Kaszti49/RezonFallDetector/out/phase2/fix2/element-1990.jpeg

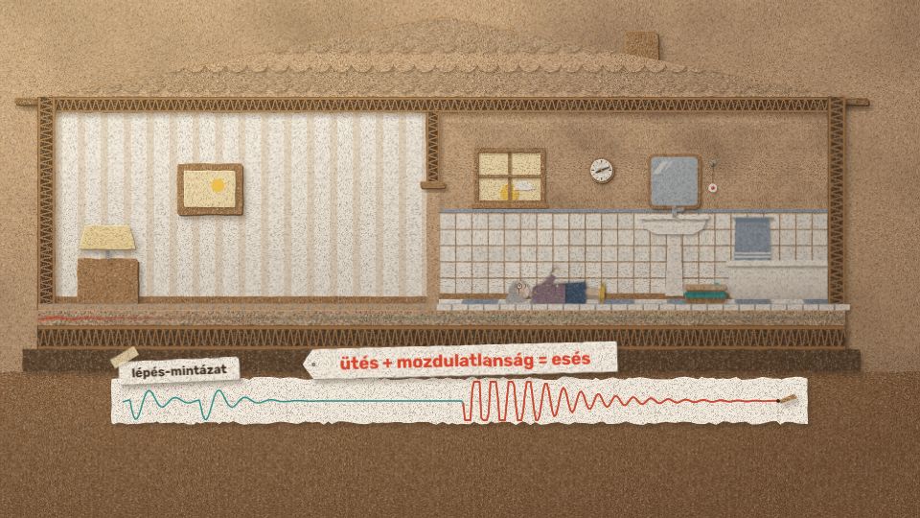
out/phase2/fix2/element-1990.jpeg
