Kaszti49/RezonFallDetector/out/phase2/fix_sheet.jpg

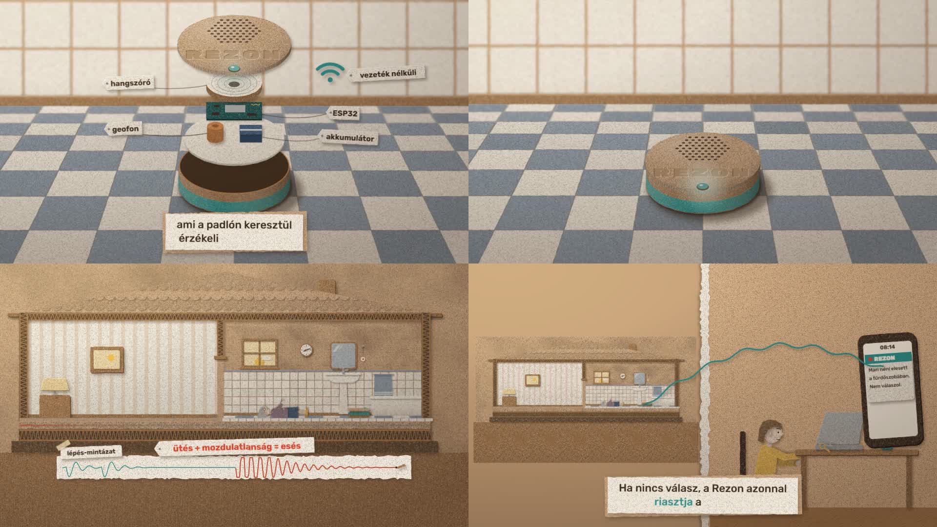
out/phase2/fix_sheet.jpg
