Kaszti49/RezonFallDetector/SCRIPT.md

# REZON – Harman Hackathon 2026 selection video: script

Single source of truth for the story, voiceover, captions and timing.
Language: Hungarian. Target length **1:56** (hard cap 1:58; the rules allow max 2:00).
30 fps. All times are mm:ss.

**Voices**
- **VO** = Kaszti (narrator).
- **DEV** = the Rezon device speaking. Also Kaszti, run through a "small speaker" filter.
- **TEAM** = each member's own line.

**Characters**
- **Mari néni**: 81, lives alone.
- **Anna**: her daughter.

---

## 1. HOOK (0:00 – 0:06)

| ID | Time | Picture | Sound | VO / caption |
|---|---|---|---|---|
| S01 | 0:00–0:06 | Black cardboard surface, barely lit. At 0:00.6 a dull **thud**, and the frame shakes once (3 px, damped). Dust specks settle. At 2.0 the caption appears word by word on a torn white paper strip. | thud (dull, cardboard-like), then 1 s of silence | **VO-01:** „Mi történik, ha senki sem hallja?" |

## 2. PROBLEM (0:06 – 0:29)

| ID | Time | Picture | Sound | VO / caption |
|---|---|---|---|---|
| S02 | 0:06–0:11 | Cardboard bathroom, morning light through a cut-out window. Mari néni shuffles in. In the background a **panic-button pendant hangs on a hook** by the mirror, out of reach. | dripping tap, slippers on tile | **VO-02:** „Ő Mari néni. Nyolcvanegy éves, és egyedül él." |
| S03 | 0:11–0:18 | Push in on a small camera in the top corner with a blinking red LED. Mari stares at it, hesitates, then throws a towel over it. The LED glows faintly through the towel. | paper rustle, towel flop | **VO-03:** „A lánya kamerát szereltetett a fürdőszobába. De ki akarna kamera előtt fürdeni?" |
| S04 | 0:18–0:21 | Wet tile, Mari slips, the cut-out falls flat. **Same thud as the hook** (callback). Small inset: the camera's feed shows only towel texture and the label **„NINCS KÉP"**. | thud, then silence | — |
| S05 | 0:21–0:29 | Time passes: the paper sun/moon disc rotates past the window, the clock hands spin, the light goes from warm to blue. Mari lies still. | ticking clock (sped up), silence | **VO-04:** „A kamera ott volt. Csak éppen semmit sem látott. Mari néni órákig feküdt a hideg csempén." |

## 3. PRODUCT (0:29 – 1:32), the longest section

| ID | Time | Picture | Sound | VO / caption |
|---|---|---|---|---|
| S06 | 0:29–0:33 | **Rewind:** a cardboard cassette-reel icon spins in the corner, and S05→S02 plays backwards fast, stepped and jerky. It stops on the empty morning bathroom. | tape rewind, then a click | **VO-05:** „Tekerjük vissza!" |
| S07 | 0:33–0:40 | The camera peels off the wall like a sticker and falls out of frame. The view pulls back and the bathroom becomes a **cross-section of the whole house** with the floor layers visible. A big cardboard caption stamps in: **2028**. | peel, stamp | **VO-06:** „Kétezer-huszonnyolc. Mi lenne, ha nem egy kamera figyelne, hanem maga a ház?" |
| S08 | 0:40–0:52 | **The Rezon device slides in** and lands on the floor by the bathroom wall. Push in, then an **exploded view**: the layers lift apart, with Hungarian labels on paper tags: **geofon · ESP32 · akkumulátor · hangszóró**, plus a small Wi-Fi icon for **„vezeték nélküli"**. Then it reassembles with a snap. | cardboard slide, snap | **VO-07:** „Ez a Rezon. Egy vezeték nélküli kis doboz, ami a padlón keresztül érzékeli a rezgéseket." |
| S09 | 0:52–1:03 | Mari walks across the cross-section. **Each step sends teal ripples** through the floor to the Rezon, and its LED pulses green. A **seismograph paper tape** at the bottom draws the same rhythm, labelled **„lépés-mintázat"**. | footsteps, paper tape scratch | **VO-08:** „Nem lát, nem vesz fel hangot, és nem kell hordani. Minden lépésnek saját rezgése van – a Rezon megtanulja, hogyan jár Mari néni." |
| S10 | 1:03–1:07 | Same slip as S04. **One big red ripple**, the tape spikes, then a **flat line**. A caption tag appears: **„ütés + mozdulatlanság = esés"**. | thud, then silence | — |
| S11 | 1:07–1:14 | The Rezon LED turns amber, and sound-wave rings come from its speaker. The speech bubble is shaped like sound waves. Mari's hand moves weakly; she cannot get up. A **10-second ring countdown** runs around the device. | two-tone chime | **DEV-01:** „Mari néni, jól van?" · (pause) · **DEV-02:** „Nyugalom, segítséget hívok." |
| S12 | 1:14–1:22 | Split screen. Right: Anna at her desk, and a cardboard phone lights up with **„REZON • Mari néni elesett a fürdőszobában. Nem válaszol. 08:14"**. Anna grabs her keys. Left: a ripple line travels from the house to the phone. | phone buzz, keys | **VO-10:** „Ha nincs válasz, a Rezon azonnal riasztja a családot. Nem órák múlva – másodpercek alatt." |
| S13 | 1:22–1:32 | Anna kneels by Mari and helps her sit up; Mari smiles. Pull back to the house: the Rezon LED back to green, calm ripples. **Tagline** in cardboard letters. | door, soft relief beat (no music) | **VO-11:** „Rezon. A ház, ami meghallja, ha baj van." |

## 4. TEAM (1:32 – 1:56)

Format: a pop-up book.
- Each member **pops up** from the center fold with a paper "flap" sound.
- Their **photo head sits on a cardboard suit body**, and the mouth flaps on their line.
- A name/role tag sits below them.
- After the line they **slide right** and stay there, so the members stack left to right.

| ID | Time | Picture | VO / caption |
|---|---|---|---|
| S14 | 1:32–1:36 | The book opens; the background is a warm kraft wall. | **VO-12:** „Mi vagyunk a Rezon csapata." |
| S15 | 1:36–1:40 | Member 1 pops up. Tag: **Kaszti Benedek – design és projektvezetés** | **TEAM-1:** „Mert mindenkinek van egy Mari nénije." |
| S16 | 1:40–1:44 | Member 2. Tag: **Szabó Viktor – jelfeldolgozás és MI** | **TEAM-2:** „Nem akarjuk kamerával figyelni." |
| S17 | 1:44–1:48 | Member 3. Tag: **Veress Bence – beágyazott szoftver** | **TEAM-3:** „De tudni akarjuk, hogy jól van." |
| S18 | 1:48–1:52 | Member 4. Tag: **Bors Máté – elektronika és prototípus** | **TEAM-4:** „Ezért építettük meg a Rezont." |
| S19 | 1:52–1:56 | **REZON** in cardboard letters pops up behind them, with the device on a small pedestal. Everyone in frame. Hold. | — |

**Team line limit:** max **7 words / 3 seconds** each, or the cap breaks.

---

## Recording list (Kaszti)

Record WAV, 48 kHz, 24-bit. Do 3 takes per line, with 1 s of silence before and after.

| File | Text |
|---|---|
| vo_01.wav | Mi történik, ha senki sem hallja? |
| vo_02.wav | Ő Mari néni. Nyolcvanegy éves, és egyedül él. |
| vo_03.wav | A lánya kamerát szereltetett a fürdőszobába. De ki akarna kamera előtt fürdeni? |
| vo_04.wav | A kamera ott volt. Csak éppen semmit sem látott. Mari néni órákig feküdt a hideg csempén. |
| vo_05.wav | Tekerjük vissza! |
| vo_06.wav | Kétezer-huszonnyolc. Mi lenne, ha nem egy kamera figyelne, hanem maga a ház? |
| vo_07.wav | Ez a Rezon. Egy vezeték nélküli kis doboz, ami a padlón keresztül érzékeli a rezgéseket. |
| vo_08.wav | Nem lát, nem vesz fel hangot, és nem kell hordani. Minden lépésnek saját rezgése van – a Rezon megtanulja, hogyan jár Mari néni. |
| dev_01.wav | Mari néni, jól van? *(calm, clear, a little slower)* |
| dev_02.wav | Nyugalom, segítséget hívok. |
| vo_10.wav | Ha nincs válasz, a Rezon azonnal riasztja a családot. Nem órák múlva – másodpercek alatt. |
| vo_11.wav | Rezon. A ház, ami meghallja, ha baj van. |
| vo_12.wav | Mi vagyunk a Rezon csapata. |
| team_1.wav | Mert mindenkinek van egy Mari nénije. *(Kaszti)* |
| team_2.wav | Nem akarjuk kamerával figyelni. *(Viktor)* |
| team_3.wav | De tudni akarjuk, hogy jól van. *(Bence)* |
| team_4.wav | Ezért építettük meg a Rezont. *(Máté)* |

## How the video answers the jury's questions

| Their question | Where |
|---|---|
| Problem / opportunity | S02–S05 |
| Human–machine relationship in 5 years | S07, S11 (the house speaks and asks) |
| Role of sound | S11 device voice, S09 the floor "hears", tagline |
| What's new vs today | S03 camera fails, S02 pendant out of reach, S08–S09 no camera, no wearable |
| Team introduced | S14–S19 |
| Technical depth (selection criterion) | S08 exploded view, S09 tape, S10 detection rule |

**Technical claims (approved by Kaszti, 2026-10-21):** wireless, battery-powered, speaker in the unit, "nem vesz fel hangot" (doesn't record audio), "impact + stillness = fall".

---

## Alternative team lines (decided 2026-10-22: **set D**)

Kaszti chose **set D** on 2026-10-22; it is now in S15–S18 and the recording list. The other sets are kept for reference only. Pick one set; then S15–S18, the recording list and the captions are updated together. Every line is ≤ 7 words and ≈ 2–3 seconds. Order is always Kaszti → Viktor → Bence → Máté.

**A – current: "What I give it"**
- Kaszti: „Én adok neki formát és hangot."
- Viktor: „Én tanítom meg érezni a lépéseket."
- Bence: „Én kötöm össze a családdal."
- Máté: „Én pedig összerakom, hogy működjön is."

**B – "What I do"** (plain and clear: each role in one sentence)
- Kaszti: „Én tervezem, hogyan néz ki és szól."
- Viktor: „Én tanítom meg felismerni az esést."
- Bence: „Én írom a dobozban futó kódot."
- Máté: „Én forrasztom össze az egészet."

**C – "Mine is…"** (short, rhythmic, a little funny – the easiest to say)
- Kaszti: „Enyém a dizájn."
- Viktor: „Enyém az okos rész."
- Bence: „Enyém a kód."
- Máté: „Enyém minden, amit megfoghatsz."

**D – "One thought, four voices"** (together they finish one sentence and restate why Rezon exists; follows VO-12 „Mi vagyunk a Rezon csapata.")
- Kaszti: „Mert mindenkinek van egy Mari nénije."
- Viktor: „Nem akarjuk kamerával figyelni."
- Bence: „De tudni akarjuk, hogy jól van."
- Máté: „Ezért építettük meg a Rezont."
