Kaszti49/RezonFallDetector/out/Font example.png

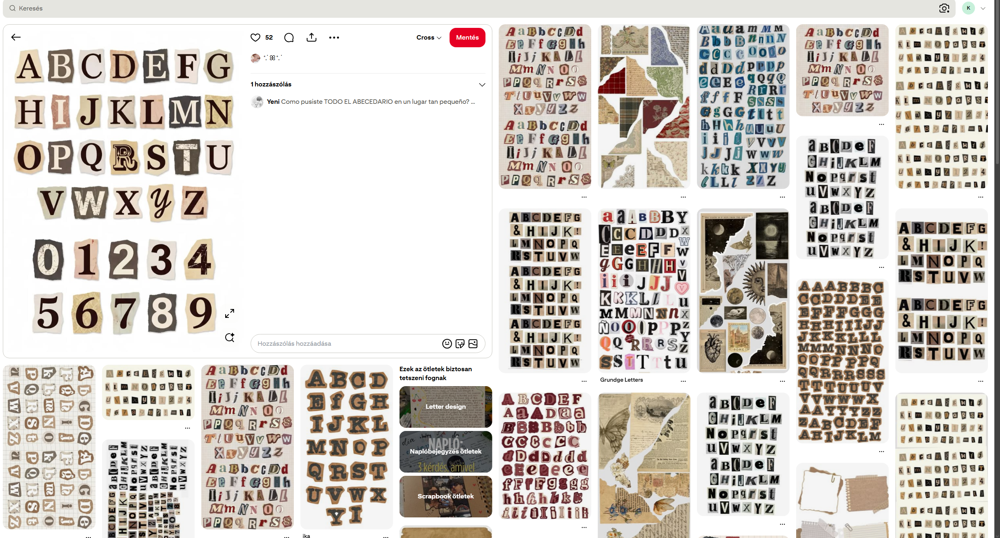
out/Font example.png
