Kaszti49/RezonFallDetector/out/phase0/title_crop_2x.png

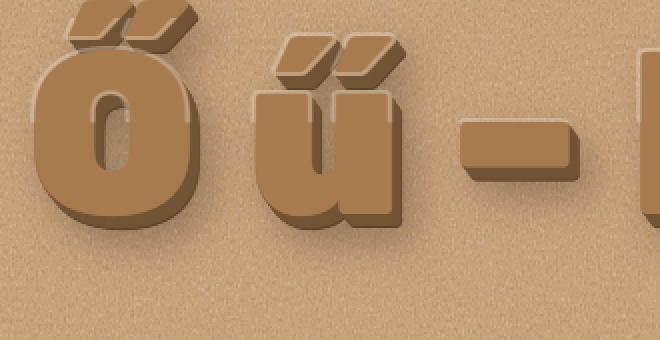
out/phase0/title_crop_2x.png
