Kaszti49/RezonFallDetector/out/phase1/PHASE1_contact_sheet.png

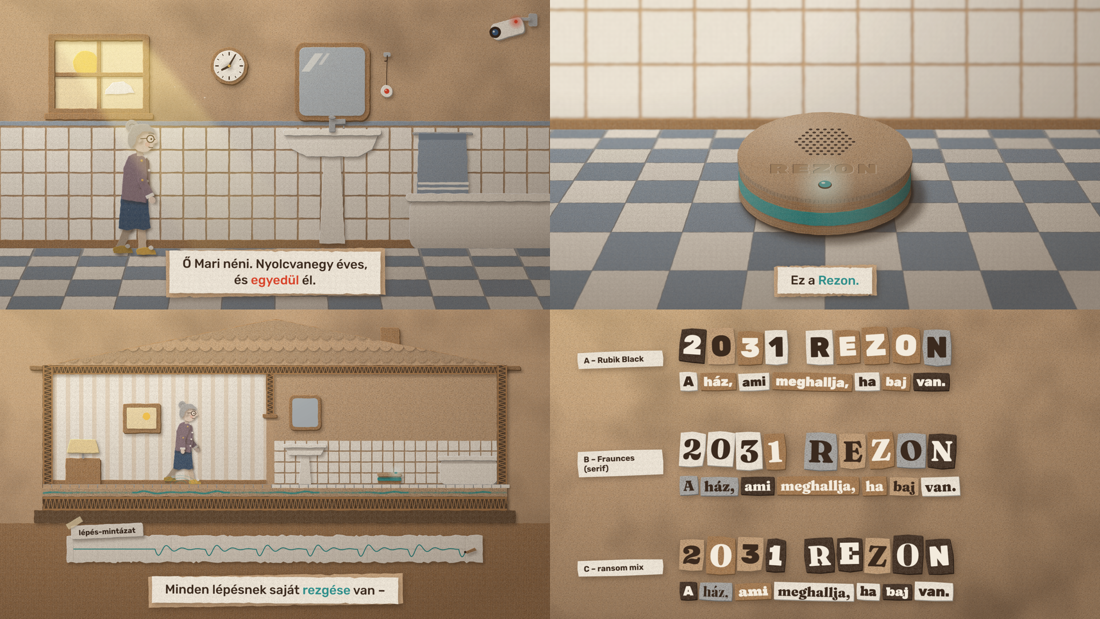
out/phase1/PHASE1_contact_sheet.png
