Kaszti49/RezonFallDetector/out/phase1/section_ripple_crop.png

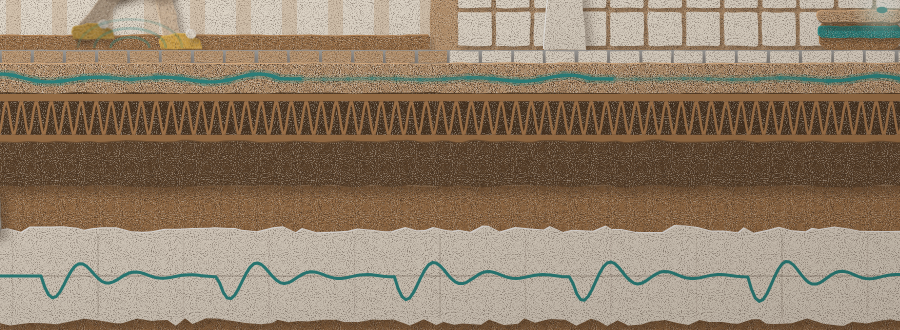
out/phase1/section_ripple_crop.png
