Kaszti49/RezonFallDetector/out/phase1/StyleBathroom.png

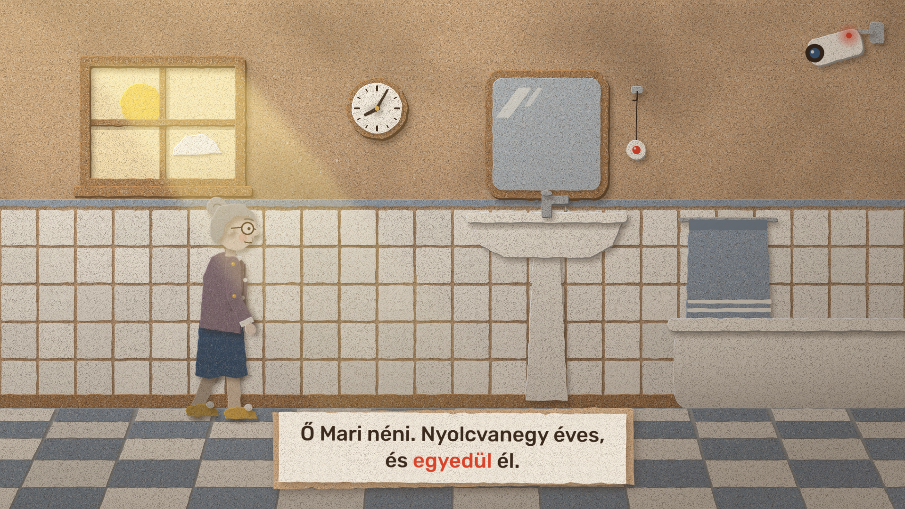
out/phase1/StyleBathroom.png
