Kaszti49/RezonFallDetector/out/phase1/StyleDevice.png

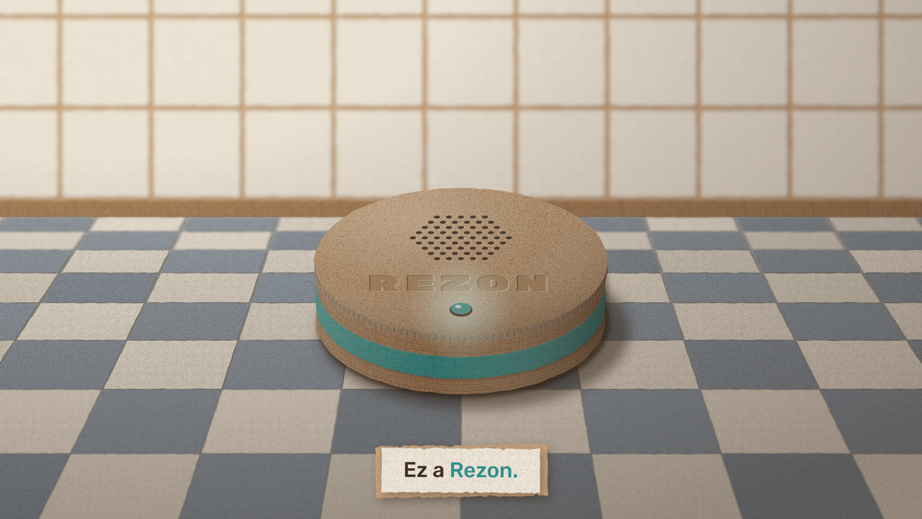
out/phase1/StyleDevice.png
