Kaszti49/RezonFallDetector/out/phase1/StyleSection.png

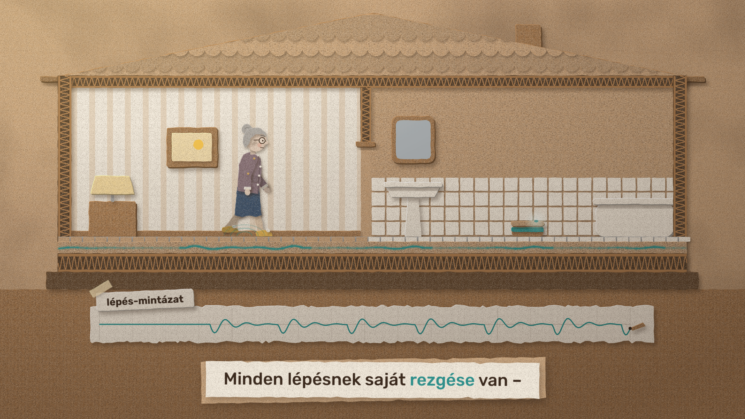
out/phase1/StyleSection.png
