Kaszti49/RezonFallDetector/out/phase1/StyleTitles.png

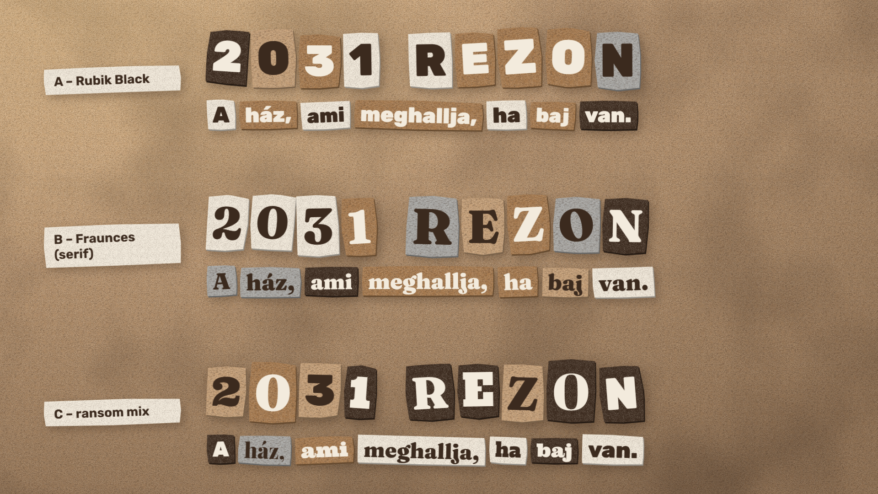
out/phase1/StyleTitles.png
