Kaszti49/RezonFallDetector/out/phase1/v1_bathroom.png

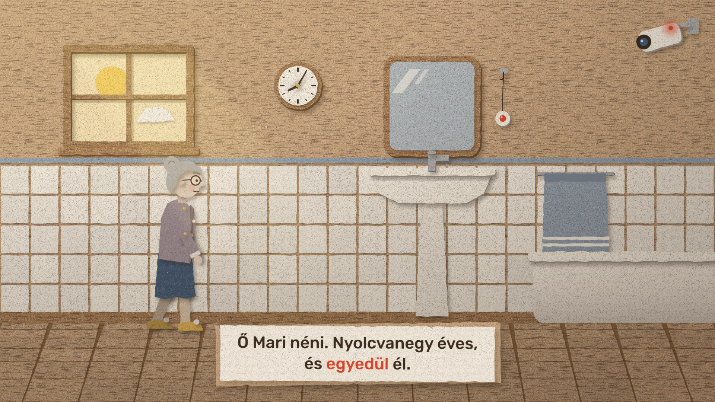
out/phase1/v1_bathroom.png
