Kaszti49/RezonFallDetector/out/phase1/v2_mari_2x.png

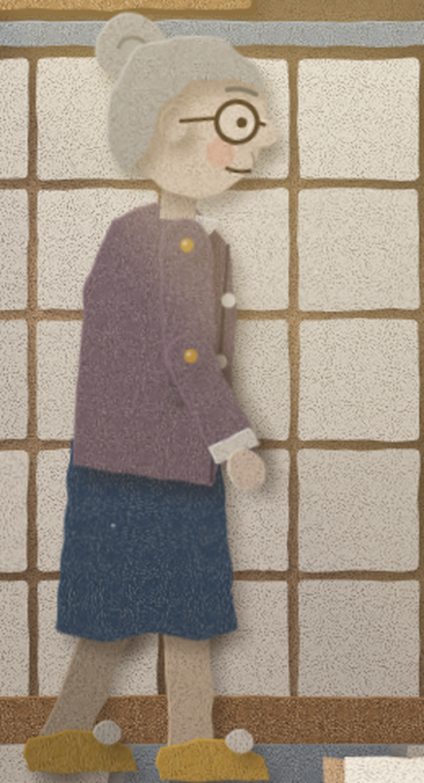
out/phase1/v2_mari_2x.png
