Kaszti49/RezonFallDetector/out/phase1/v3_StyleTitles.png

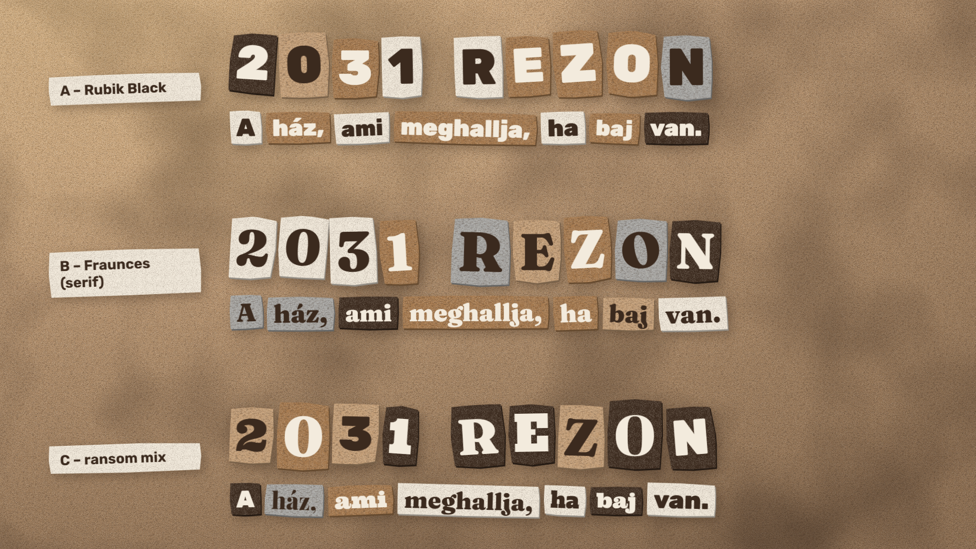
out/phase1/v3_StyleTitles.png
