Kaszti49/RezonFallDetector/out/phase2/cut_check.jpg

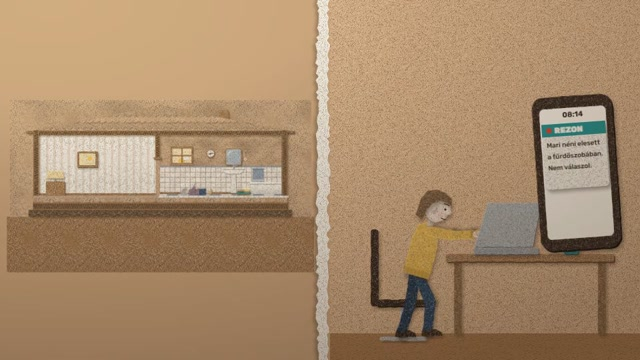
out/phase2/cut_check.jpg
