Kaszti49/RezonFallDetector/out/phase2/flap_check.jpg

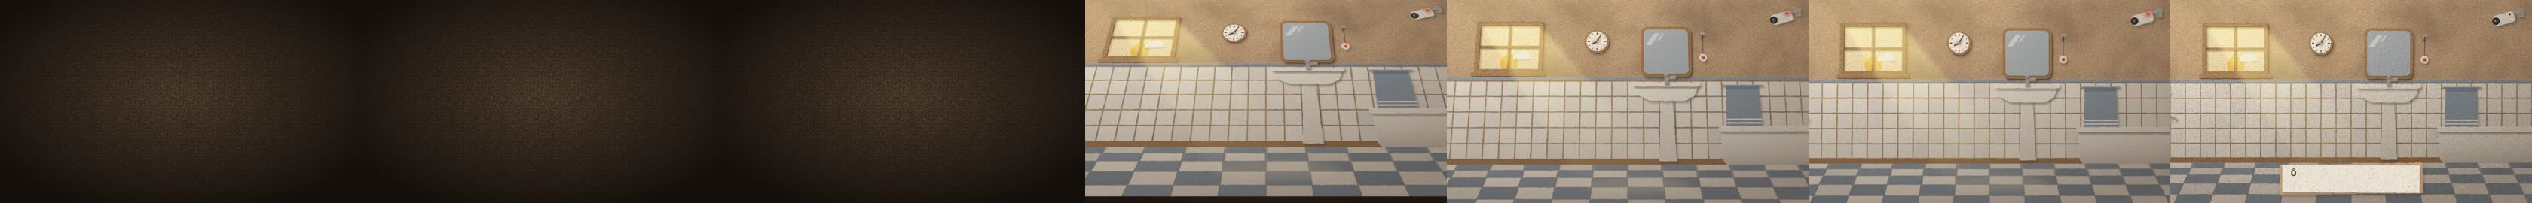
out/phase2/flap_check.jpg
