Kaszti49/RezonFallDetector/out/phase2/flip_check.jpg

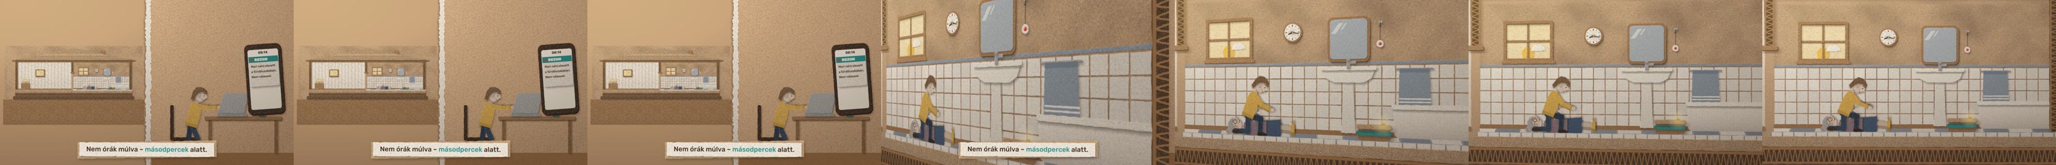
out/phase2/flip_check.jpg
