Kaszti49/RezonFallDetector/out/phase2/handoff.jpg

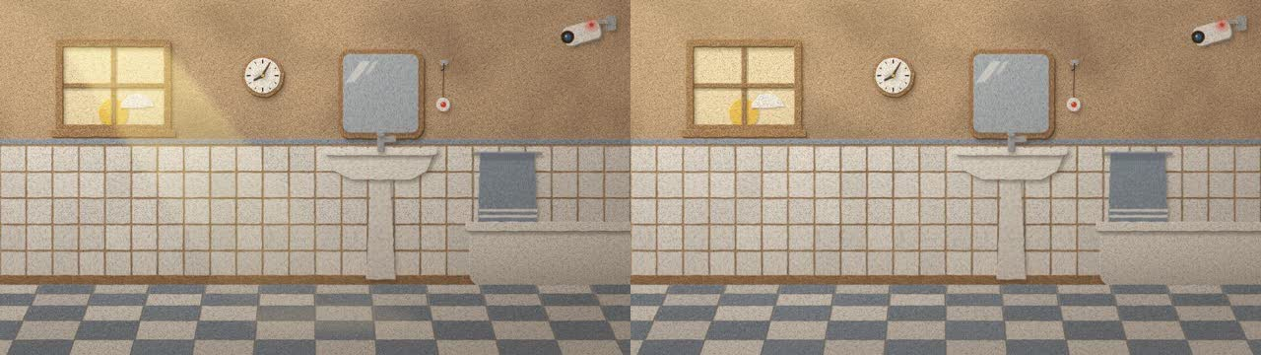
out/phase2/handoff.jpg
