Kaszti49/RezonFallDetector/out/phase2/keys/element-0021.jpeg

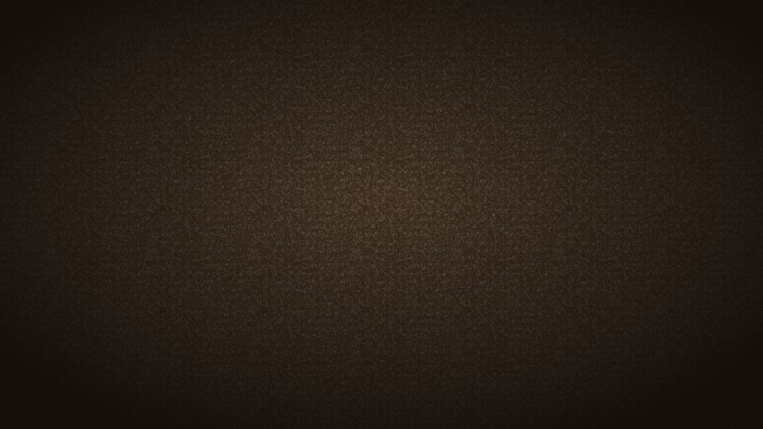
out/phase2/keys/element-0021.jpeg
