Kaszti49/RezonFallDetector/out/phase2/keys/element-0255.jpeg

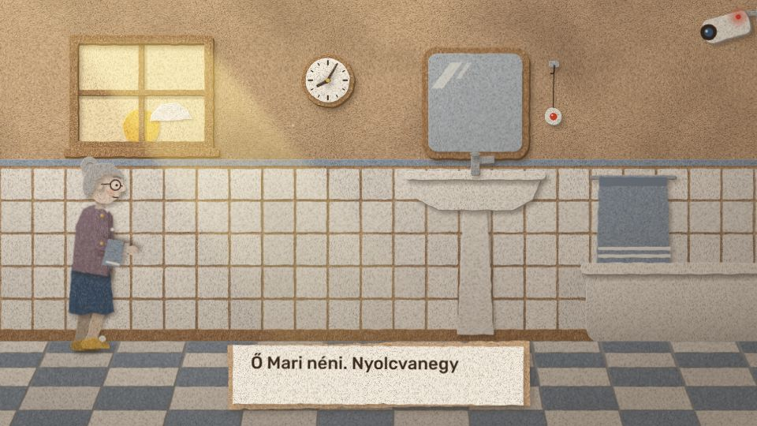
out/phase2/keys/element-0255.jpeg
