Kaszti49/RezonFallDetector/out/phase2/keys/element-0384.jpeg

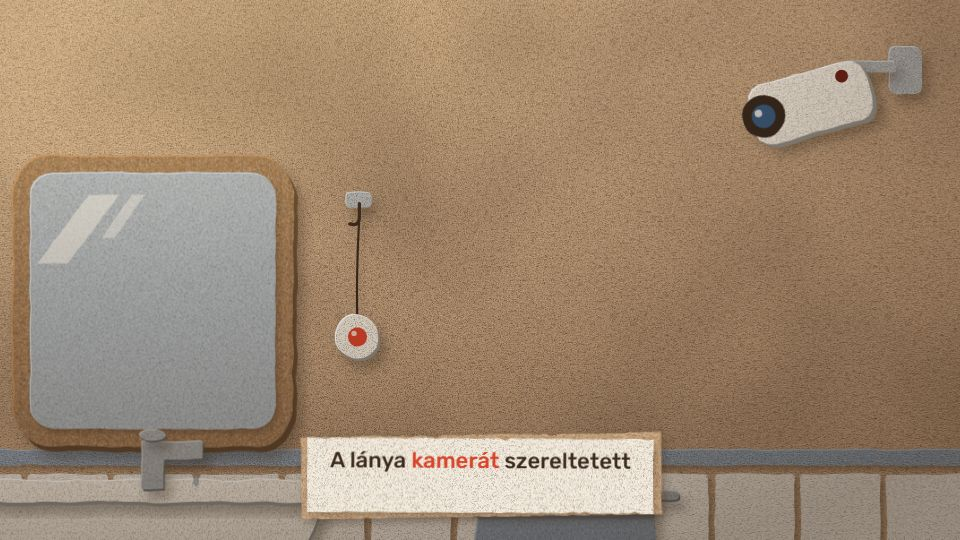
out/phase2/keys/element-0384.jpeg
