Kaszti49/RezonFallDetector/out/phase2/keys/element-0522.jpeg

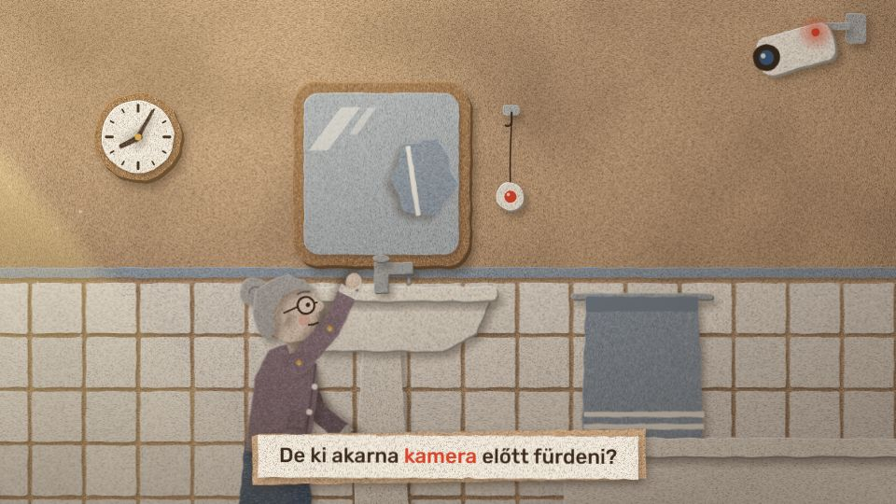
out/phase2/keys/element-0522.jpeg
