Kaszti49/RezonFallDetector/out/phase2/keys/element-0570.jpeg

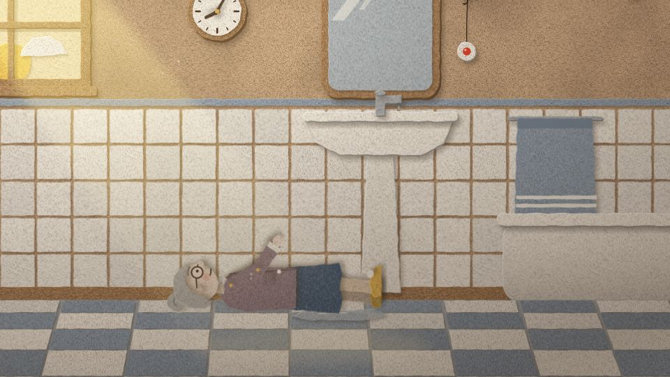
out/phase2/keys/element-0570.jpeg
