Kaszti49/RezonFallDetector/out/phase2/keys/element-0600.jpeg

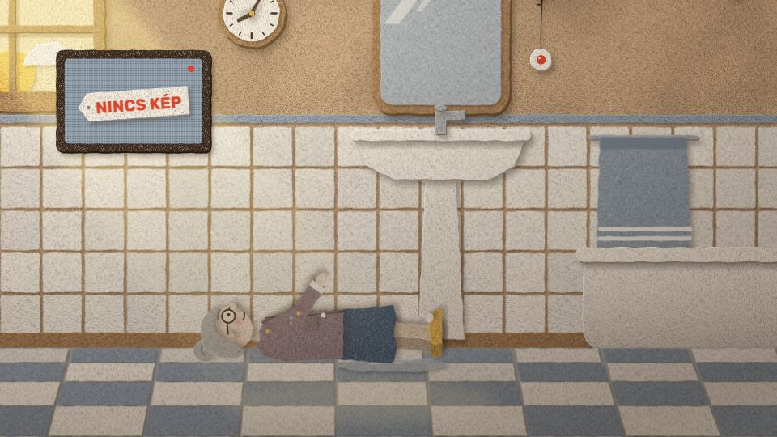
out/phase2/keys/element-0600.jpeg
