Kaszti49/RezonFallDetector/out/phase2/keys/element-0810.jpeg

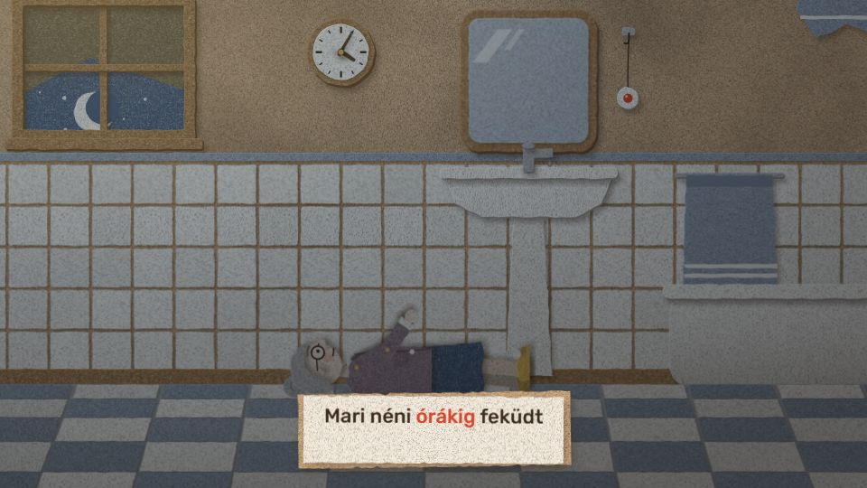
out/phase2/keys/element-0810.jpeg
