Kaszti49/RezonFallDetector/out/phase2/keys/element-0915.jpeg

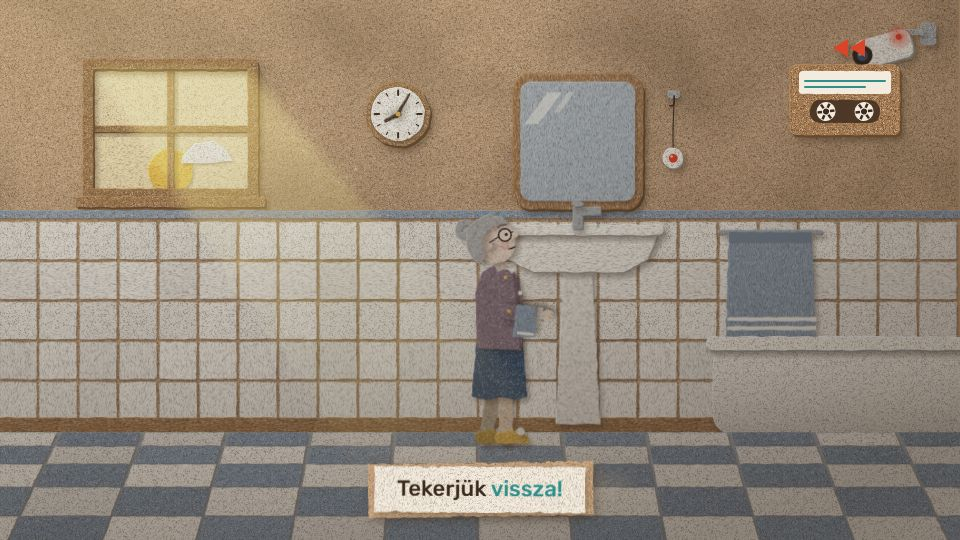
out/phase2/keys/element-0915.jpeg
