Kaszti49/RezonFallDetector/out/phase2/keys/element-0975.jpeg

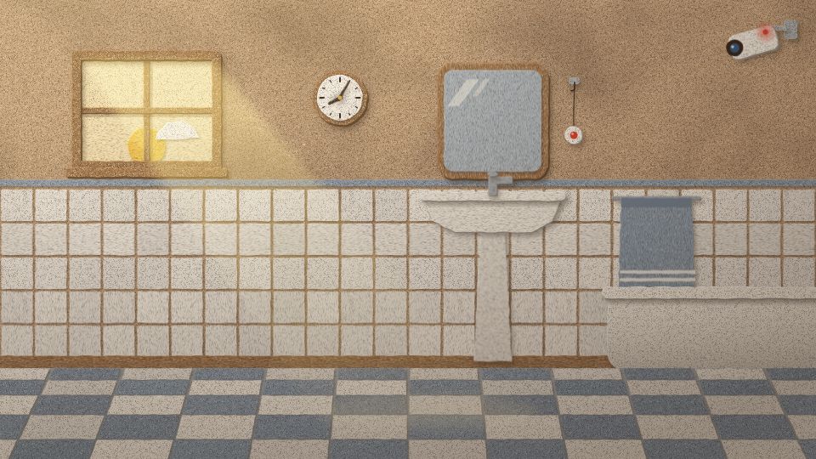
out/phase2/keys/element-0975.jpeg
