Kaszti49/RezonFallDetector/out/phase2/keys/element-1011.jpeg

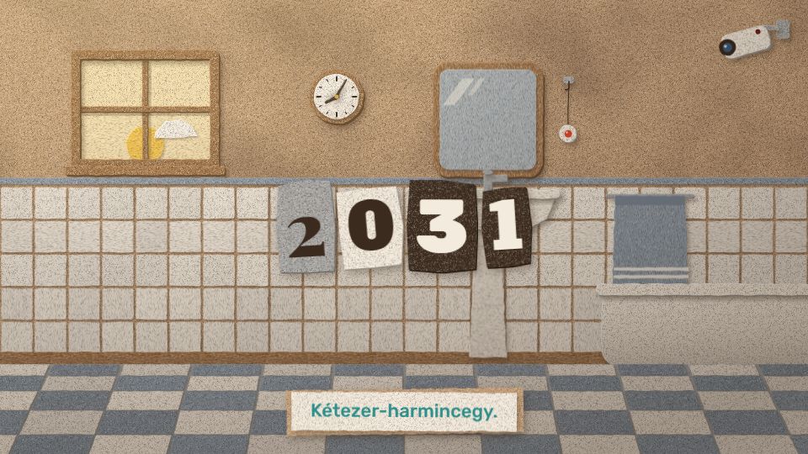
out/phase2/keys/element-1011.jpeg
