Kaszti49/RezonFallDetector/out/phase2/keys/element-1080.jpeg

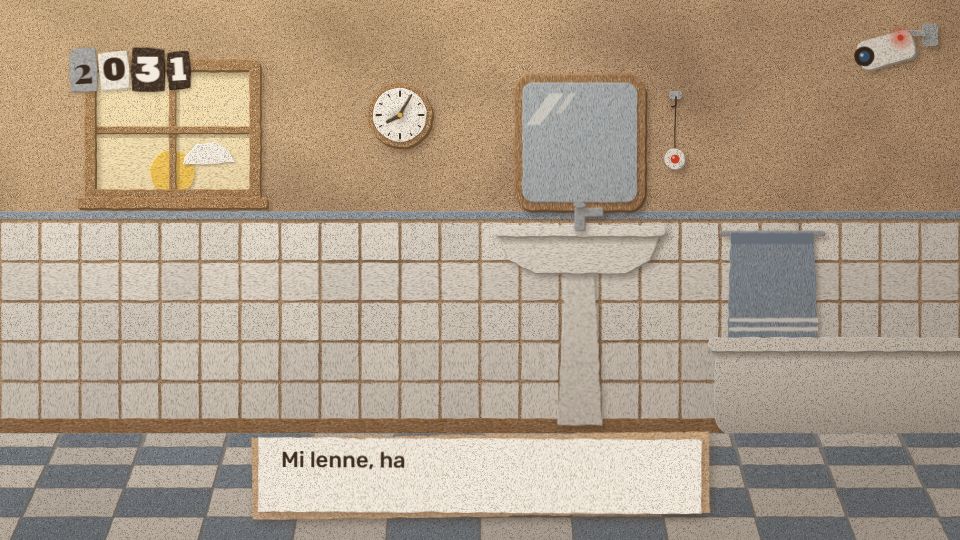
out/phase2/keys/element-1080.jpeg
