Kaszti49/RezonFallDetector/out/phase2/keys/element-1155.jpeg

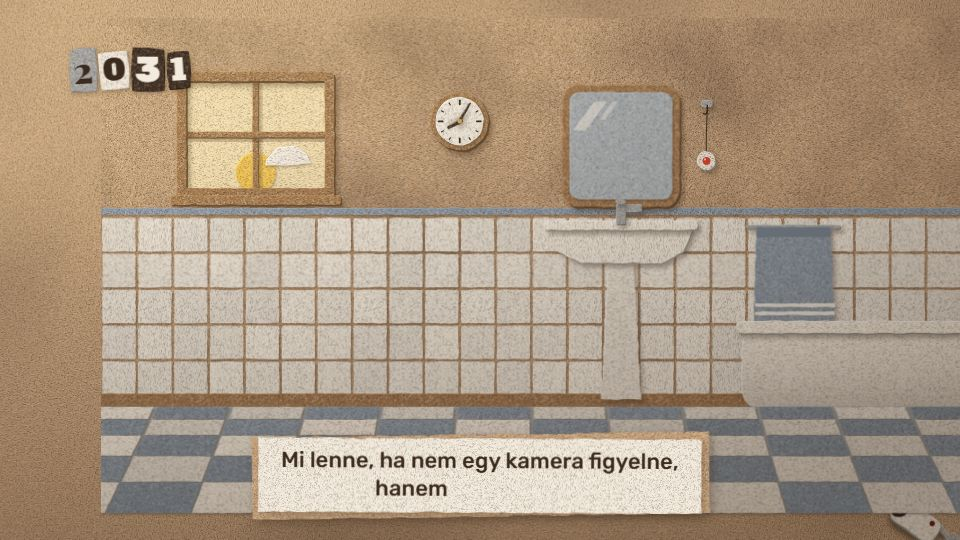
out/phase2/keys/element-1155.jpeg
