Kaszti49/RezonFallDetector/out/phase2/keys/element-1194.jpeg

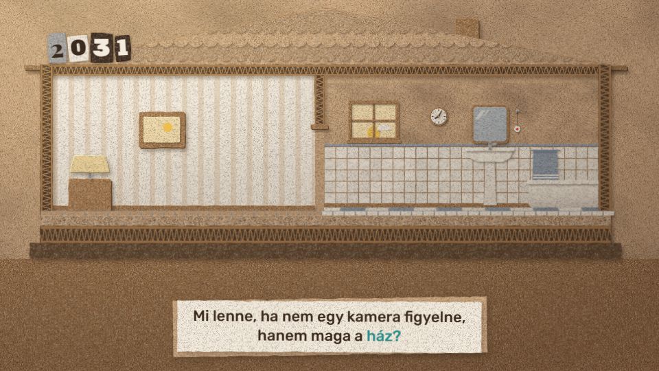
out/phase2/keys/element-1194.jpeg
