Kaszti49/RezonFallDetector/out/phase2/keys/element-1230.jpeg

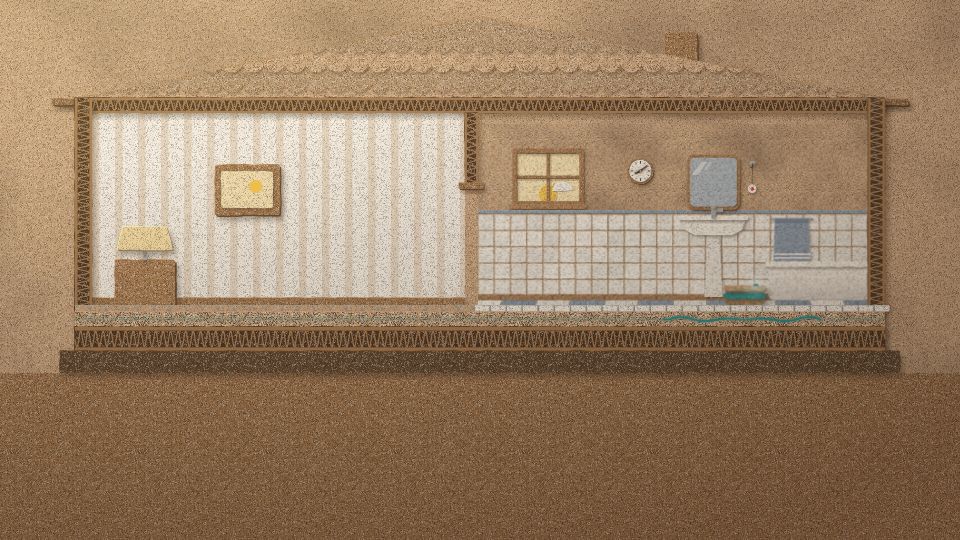
out/phase2/keys/element-1230.jpeg
