Kaszti49/RezonFallDetector/out/phase2/keys/element-1275.jpeg

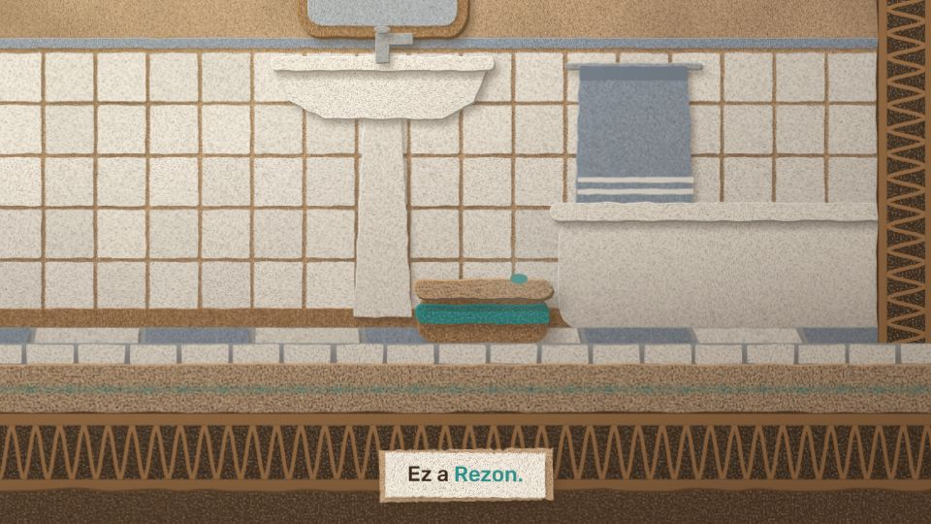
out/phase2/keys/element-1275.jpeg
