Kaszti49/RezonFallDetector/out/phase2/keys/element-1410.jpeg

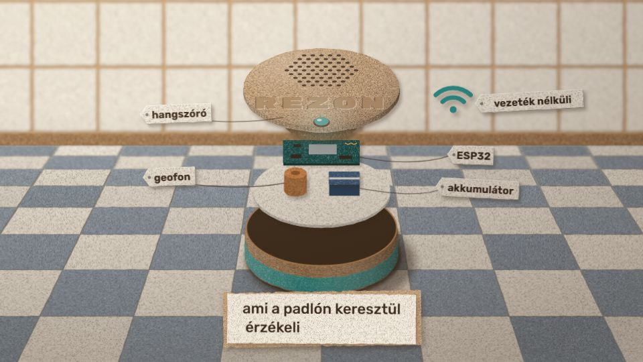
out/phase2/keys/element-1410.jpeg
