Kaszti49/RezonFallDetector/out/phase2/keys/element-1530.jpeg

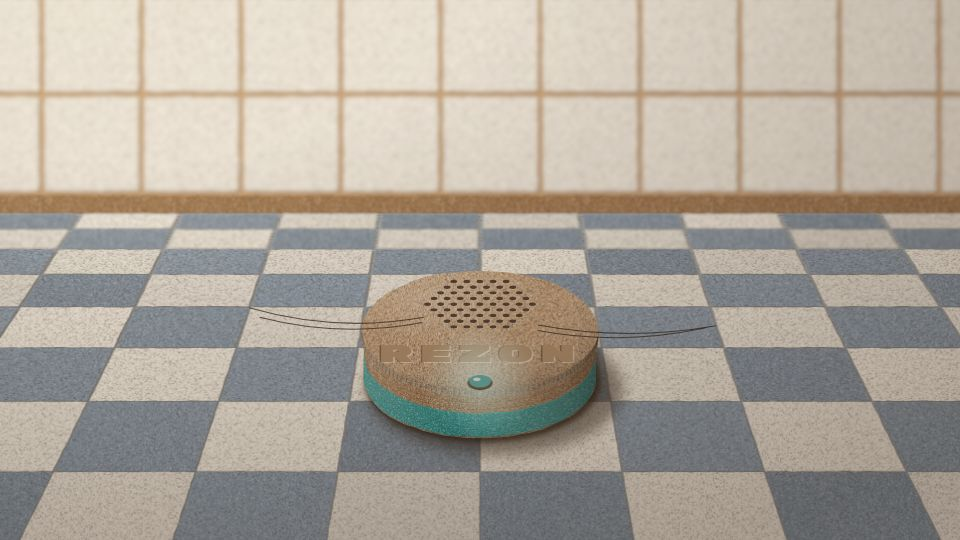
out/phase2/keys/element-1530.jpeg
