Kaszti49/RezonFallDetector/out/phase2/keys/element-1710.jpeg

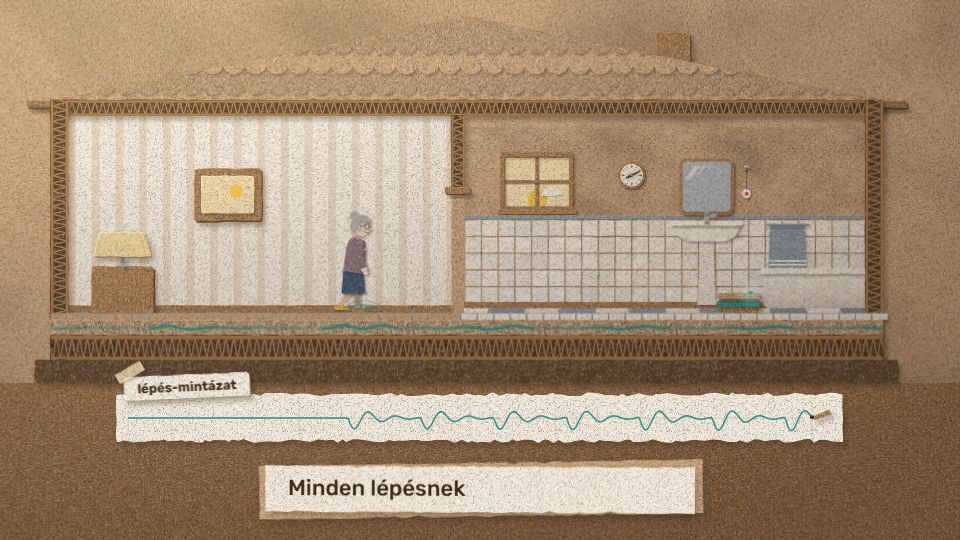
out/phase2/keys/element-1710.jpeg
