Kaszti49/RezonFallDetector/out/phase2/keys/element-1965.jpeg

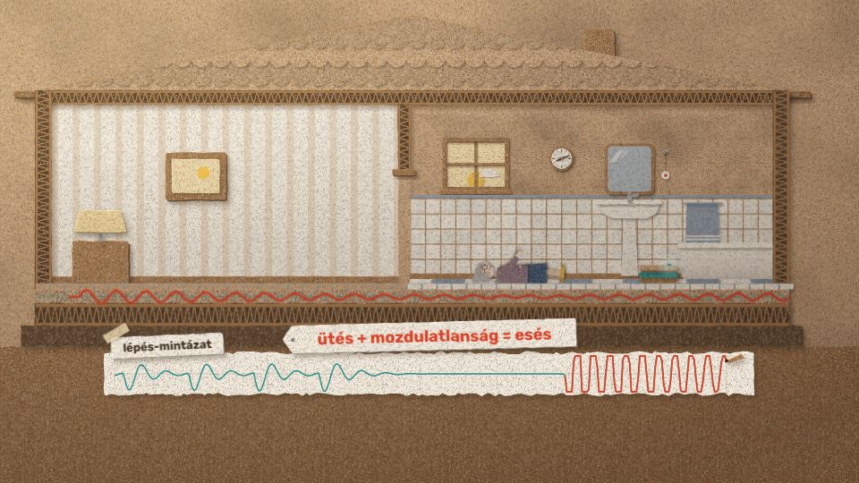
out/phase2/keys/element-1965.jpeg
