Kaszti49/RezonFallDetector/out/phase2/keys/element-2100.jpeg

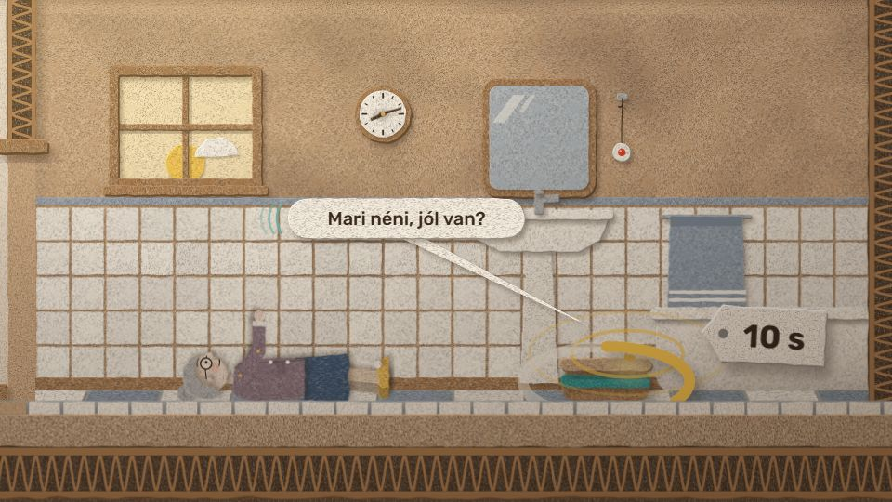
out/phase2/keys/element-2100.jpeg
