Kaszti49/RezonFallDetector/out/phase2/keys/element-2325.jpeg

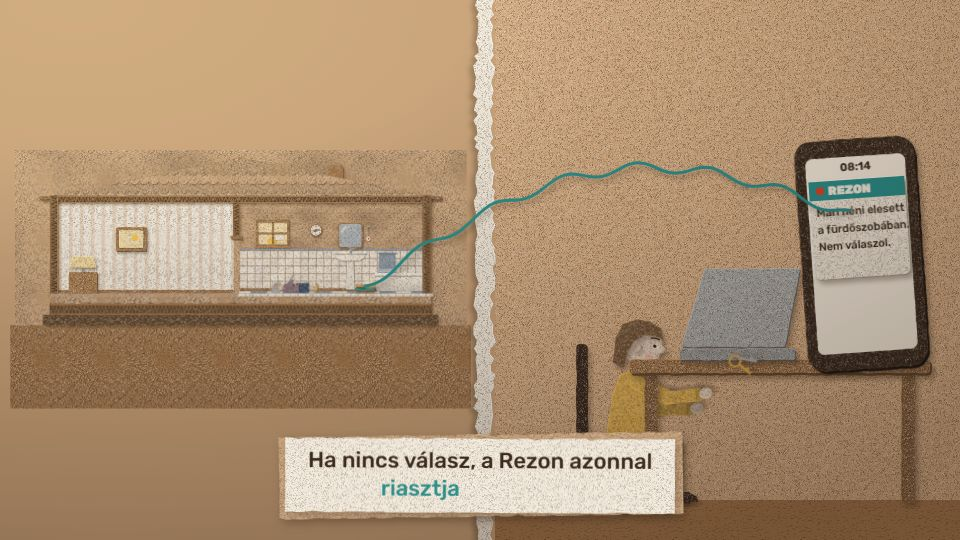
out/phase2/keys/element-2325.jpeg
