Kaszti49/RezonFallDetector/out/phase2/keys/element-2520.jpeg

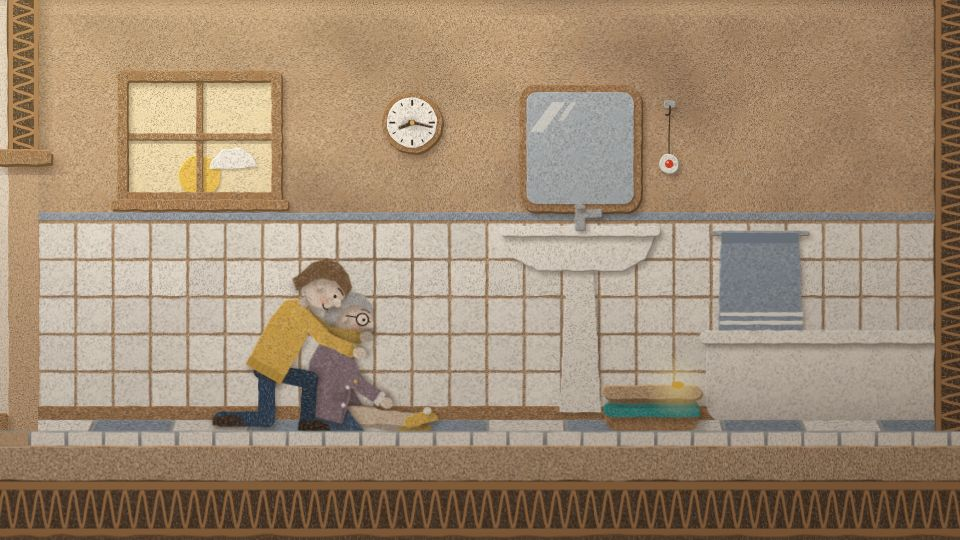
out/phase2/keys/element-2520.jpeg
