Kaszti49/RezonFallDetector/out/phase2/keys/element-2700.jpeg

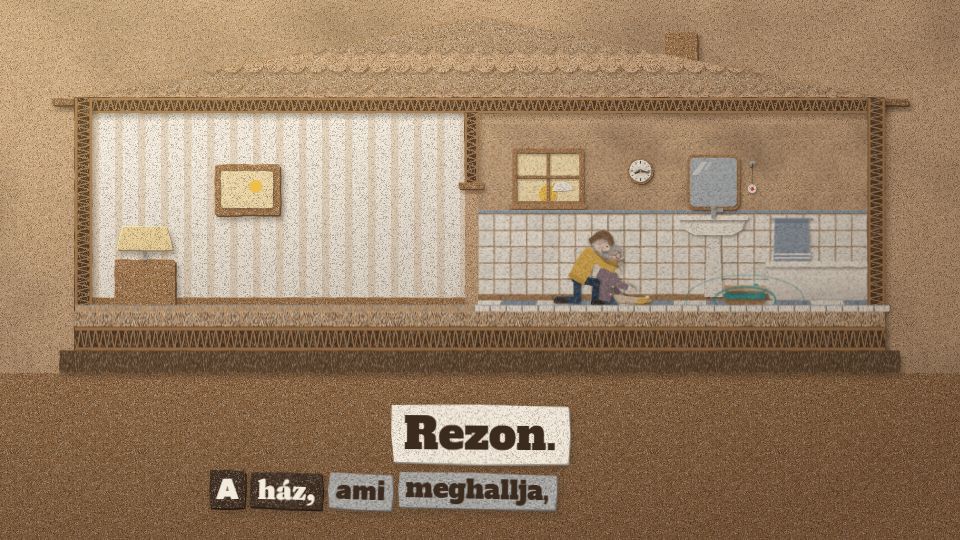
out/phase2/keys/element-2700.jpeg
