Kaszti49/RezonFallDetector/out/phase2/keys/element-2820.jpeg

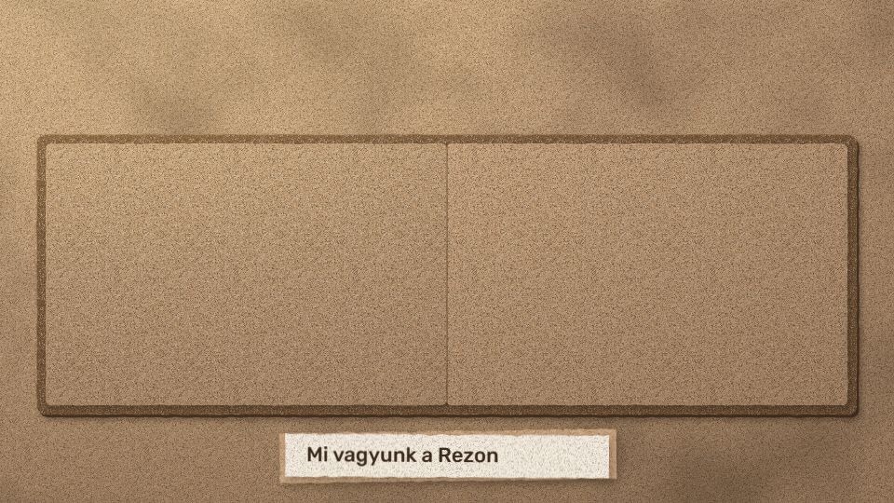
out/phase2/keys/element-2820.jpeg
