Kaszti49/RezonFallDetector/out/phase2/keys/element-2940.jpeg

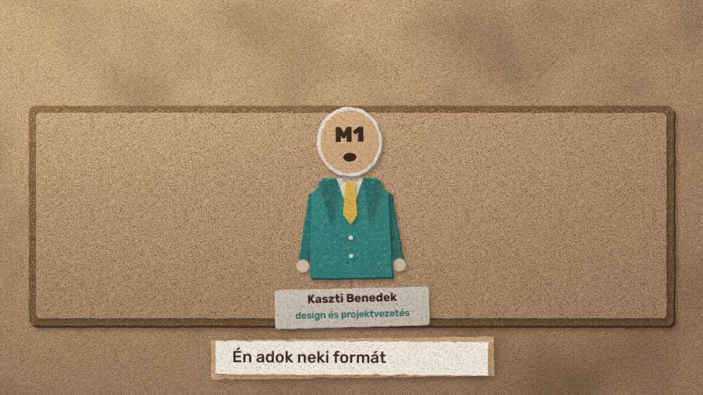
out/phase2/keys/element-2940.jpeg
