Kaszti49/RezonFallDetector/out/phase2/keys/element-3180.jpeg

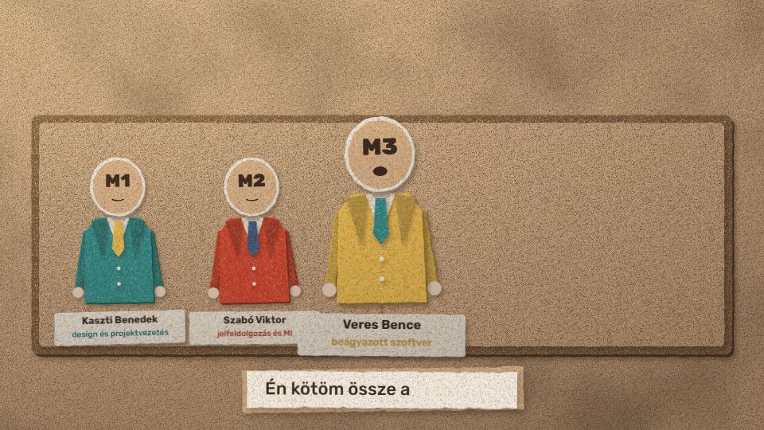
out/phase2/keys/element-3180.jpeg
