Kaszti49/RezonFallDetector/out/phase2/keys/element-3450.jpeg

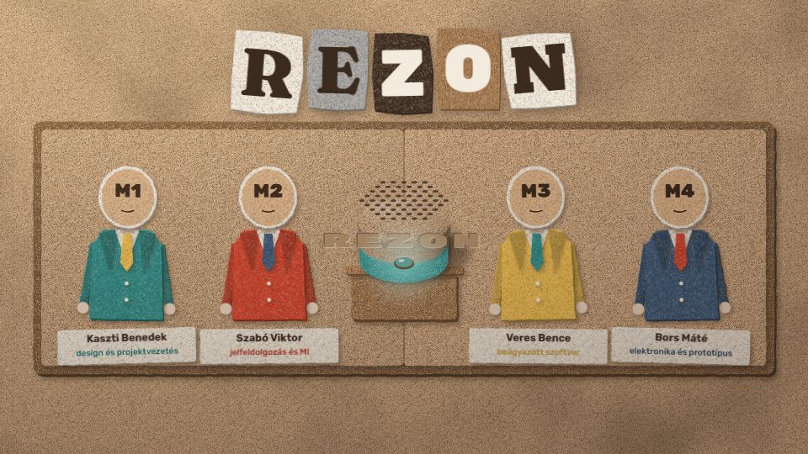
out/phase2/keys/element-3450.jpeg
