Kaszti49/RezonFallDetector/out/phase2/sheet_0.jpg

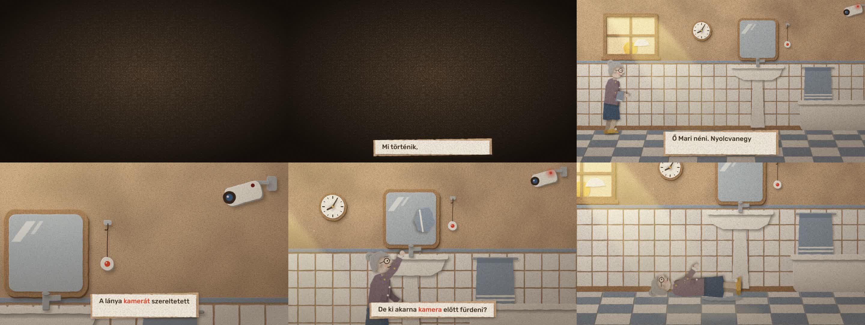
out/phase2/sheet_0.jpg
