Kaszti49/RezonFallDetector/out/phase2/sheet_1.jpg

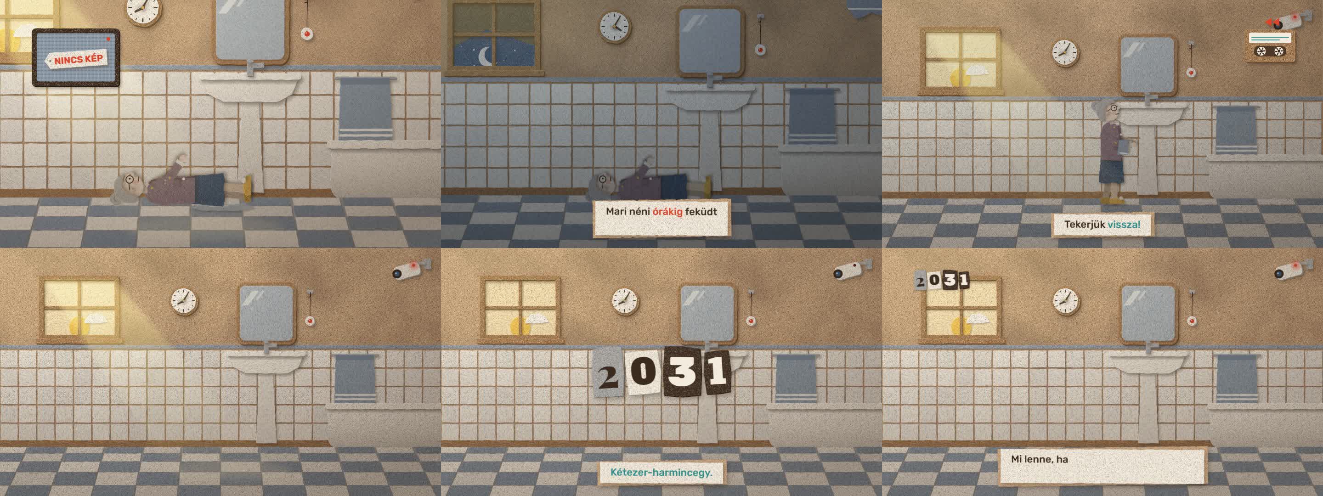
out/phase2/sheet_1.jpg
