Kaszti49/RezonFallDetector/out/phase2/sheet_2.jpg

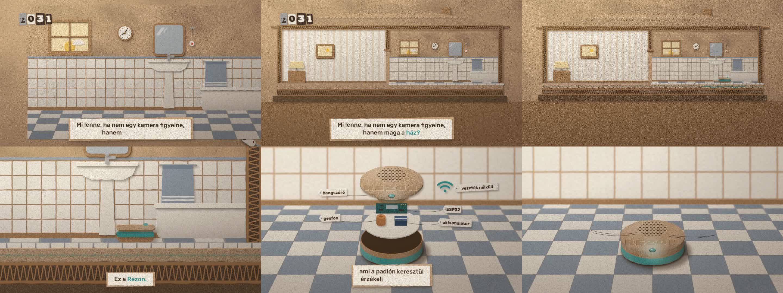
out/phase2/sheet_2.jpg
