Kaszti49/RezonFallDetector/out/phase2/sheet_3.jpg

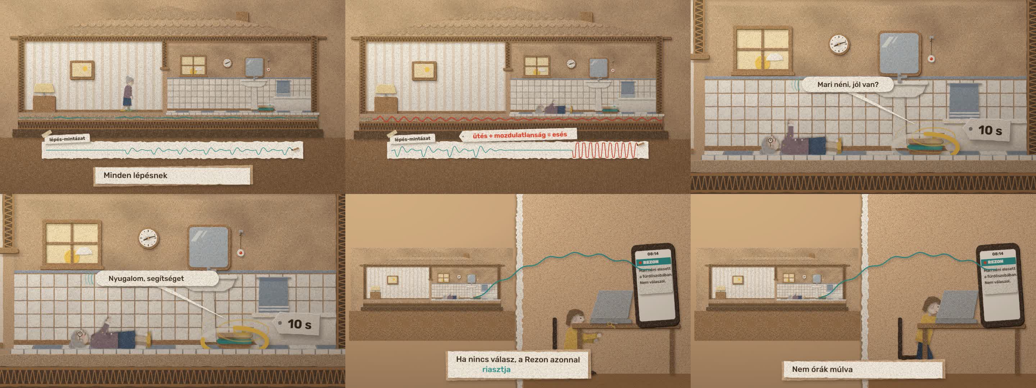
out/phase2/sheet_3.jpg
