Kaszti49/RezonFallDetector/out/phase2/sheet_4.jpg

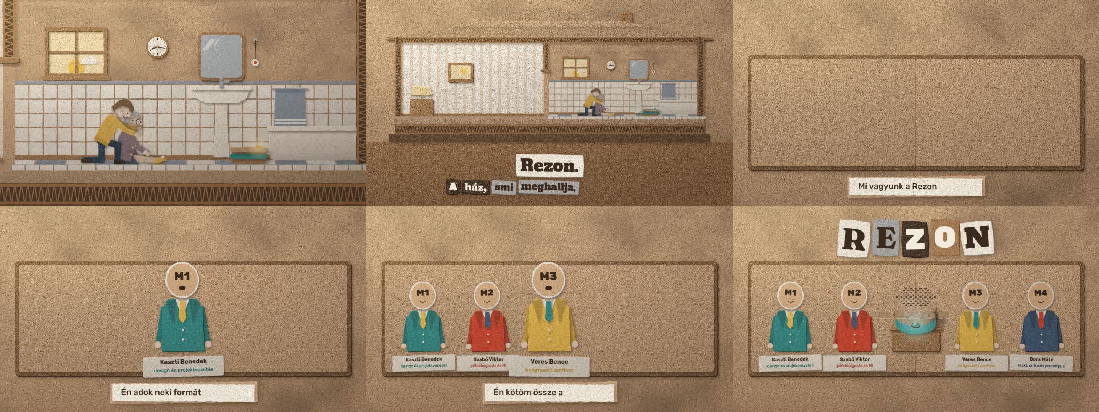
out/phase2/sheet_4.jpg
