Kaszti49/RezonFallDetector/out/phase2/trans/t_6.27.jpg

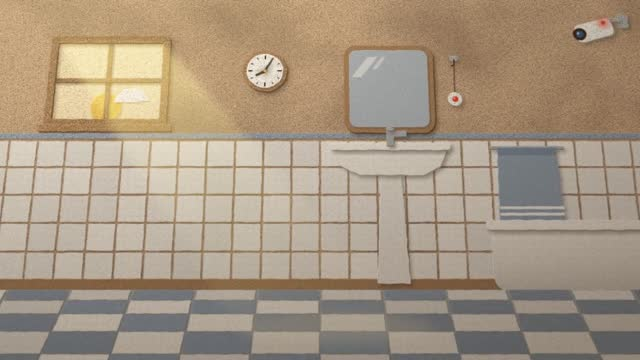
out/phase2/trans/t_6.27.jpg
