Kaszti49/RezonFallDetector/out/phase2/trans/t_33.05.jpg

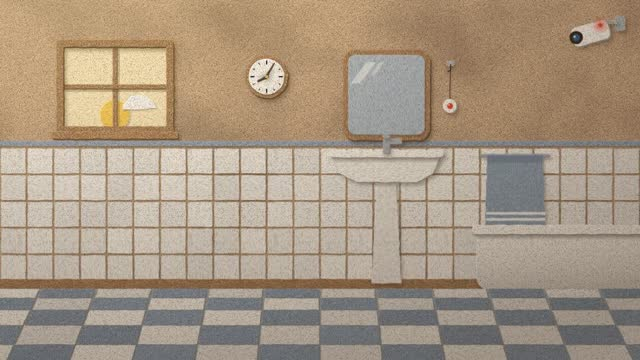
out/phase2/trans/t_33.05.jpg
