Kaszti49/RezonFallDetector/out/phase2/trans/t_74.27.jpg

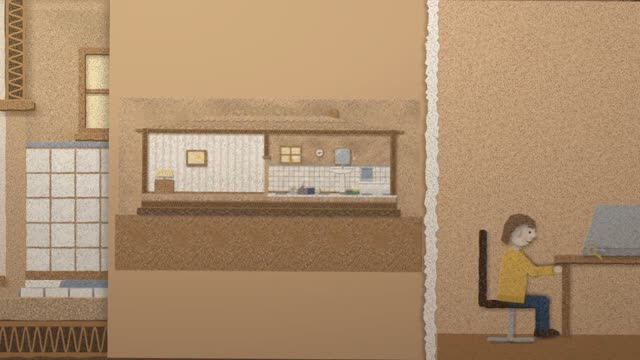
out/phase2/trans/t_74.27.jpg
