Kaszti49/RezonFallDetector/out/phase2/trans/t_82.30.jpg

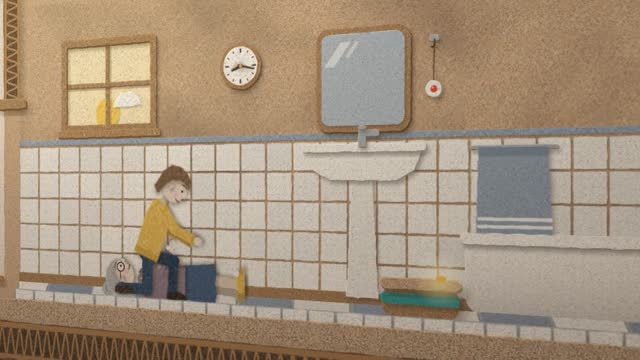
out/phase2/trans/t_82.30.jpg
