Kaszti49/RezonFallDetector/out/phase2/trans/t_92.30.jpg

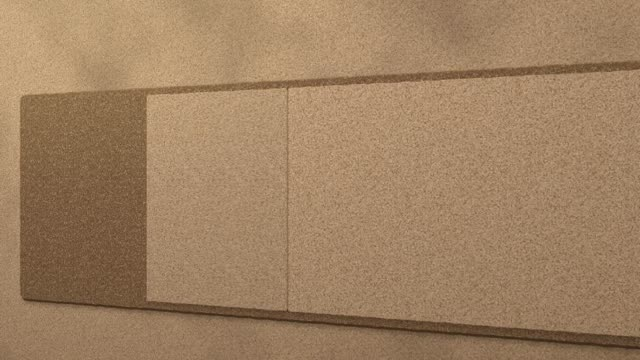
out/phase2/trans/t_92.30.jpg
