Kaszti49/RezonFallDetector/out/phase2/trans_sheet.jpg

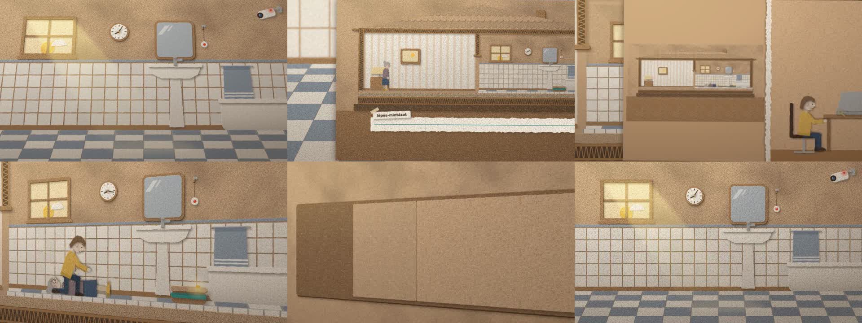
out/phase2/trans_sheet.jpg
