Kaszti49/RezonFallDetector/out/phase3/finale_book2.jpg

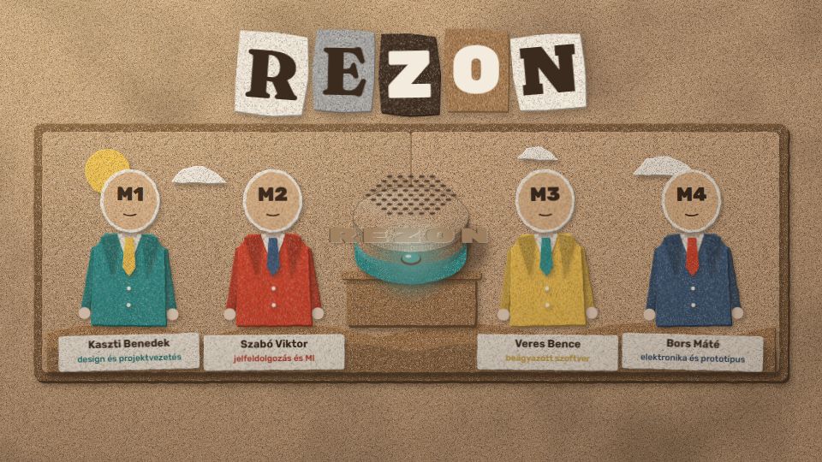
out/phase3/finale_book2.jpg
