Kaszti49/RezonFallDetector/out/phase3/keys4/element-0520.jpeg

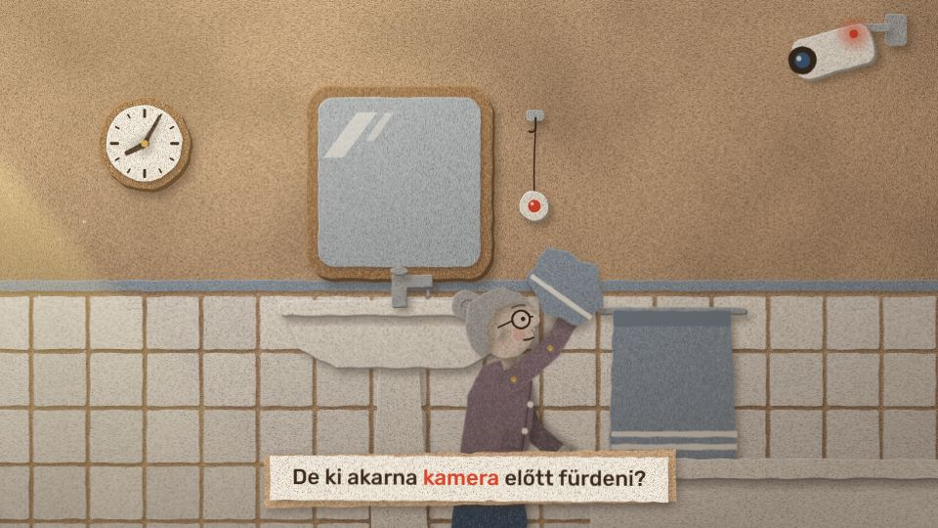
out/phase3/keys4/element-0520.jpeg
