Kaszti49/RezonFallDetector/out/phase3/keys4/element-1170.jpeg

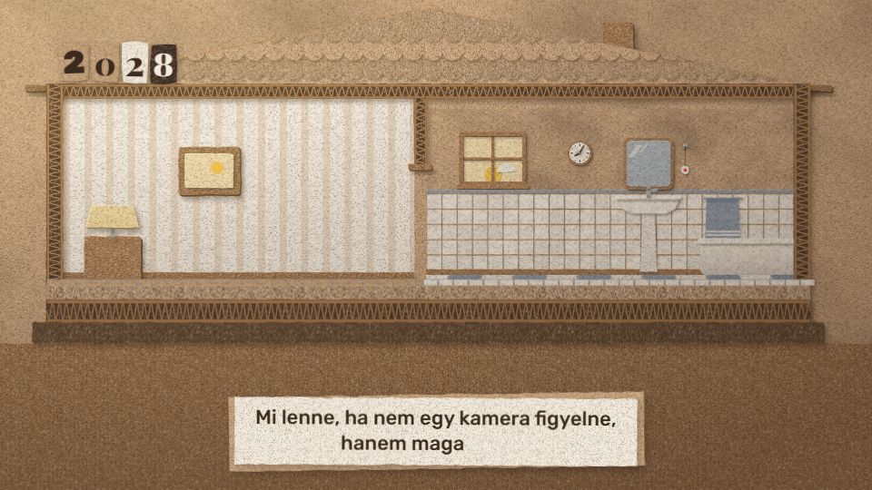
out/phase3/keys4/element-1170.jpeg
