Kaszti49/RezonFallDetector/out/phase3/keys4/element-2100.jpeg

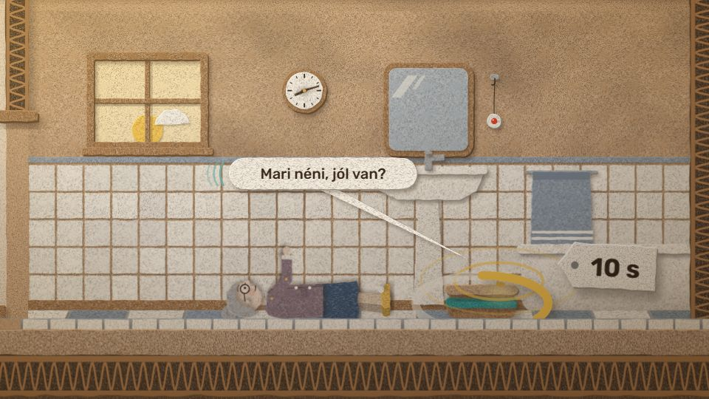
out/phase3/keys4/element-2100.jpeg
