Kaszti49/RezonFallDetector/out/phase3/keys/element-0330.jpeg

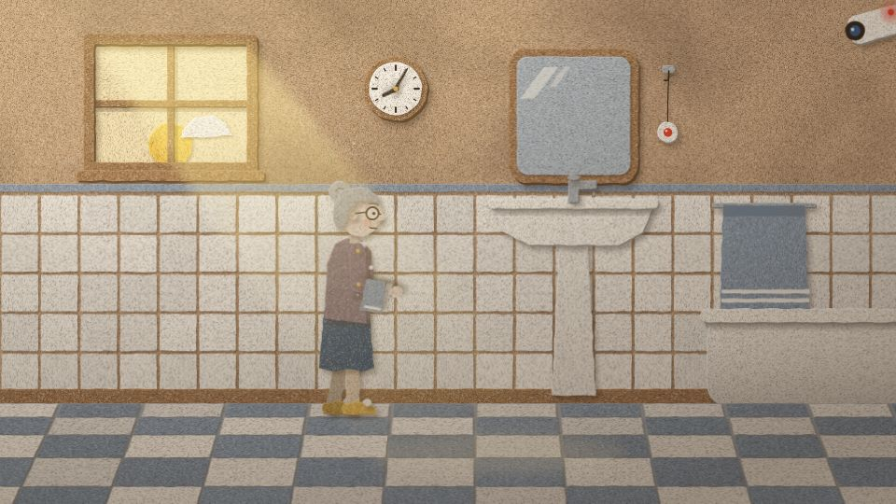
out/phase3/keys/element-0330.jpeg
