Kaszti49/RezonFallDetector/out/phase3/keys/element-2700.jpeg

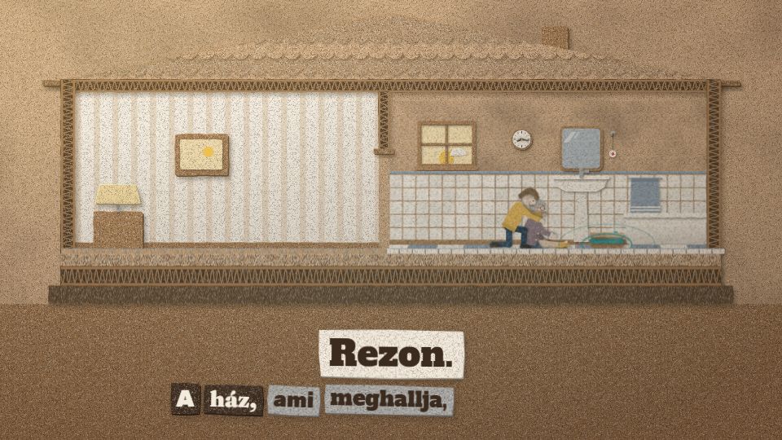
out/phase3/keys/element-2700.jpeg
