Kaszti49/RezonFallDetector/out/phase3/lid_check.jpg

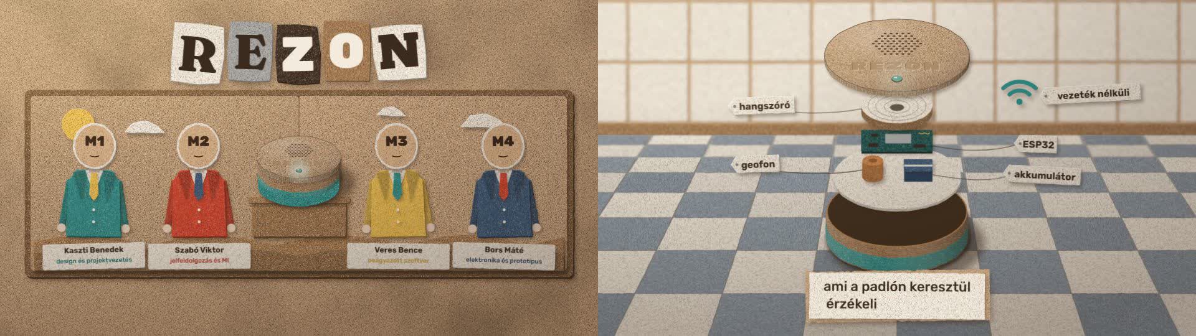
out/phase3/lid_check.jpg
