Kaszti49/RezonFallDetector/out/phase3/p3_keys.jpg

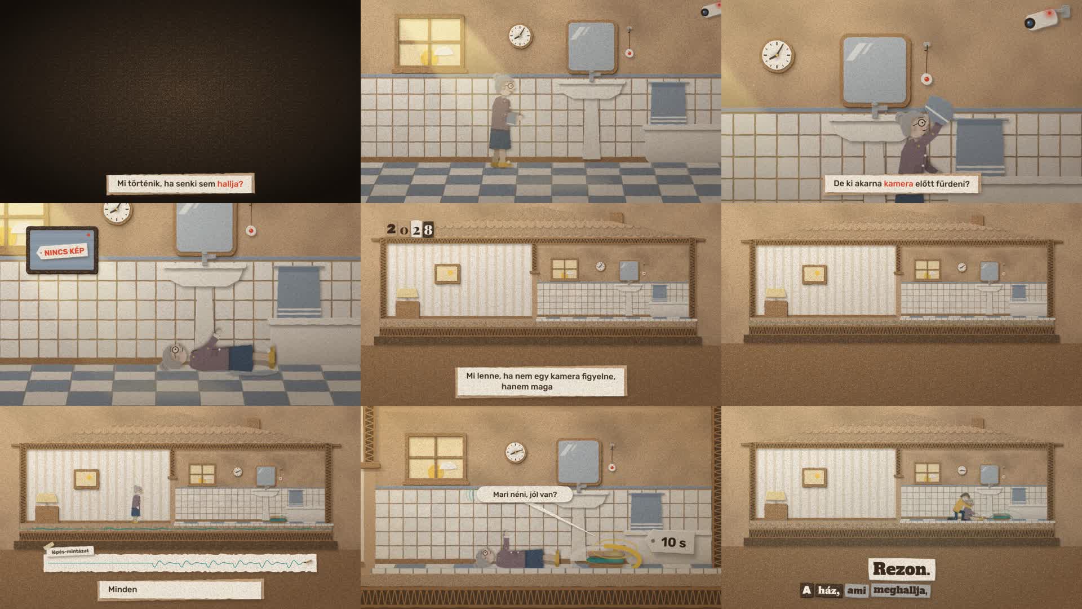
out/phase3/p3_keys.jpg
