Kaszti49/RezonFallDetector/out/phase3/s08_hero_check.jpg

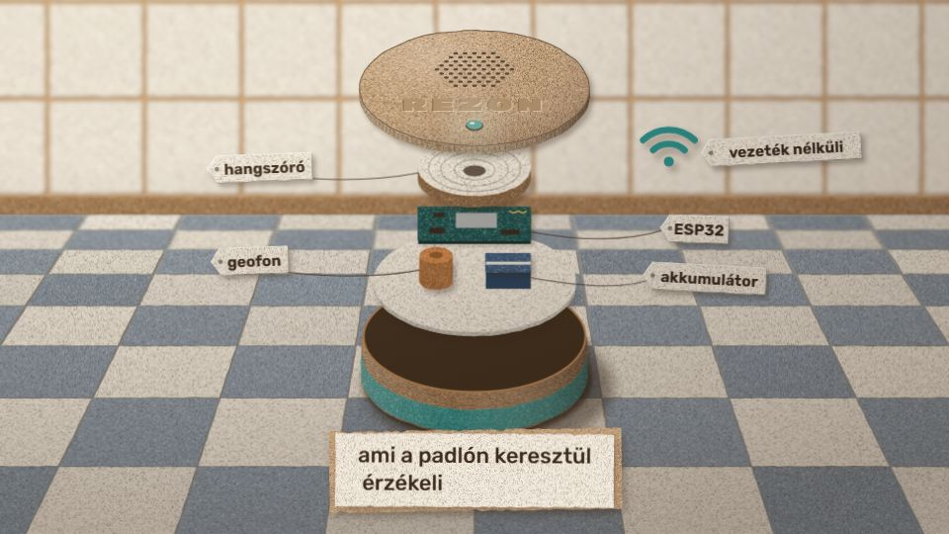
out/phase3/s08_hero_check.jpg
