Kaszti49/RezonFallDetector/out/phase3/spot_18.9.jpg

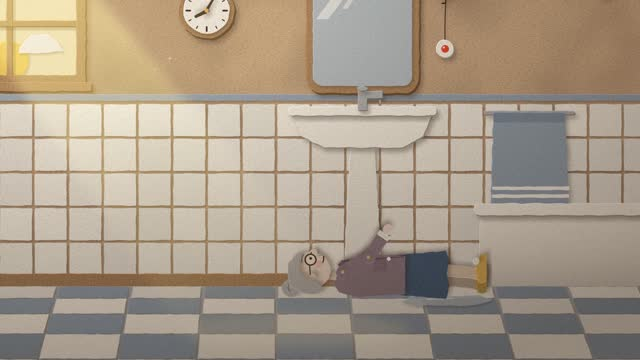
out/phase3/spot_18.9.jpg
