Kaszti49/RezonFallDetector/out/phase3/spot_64.0.jpg

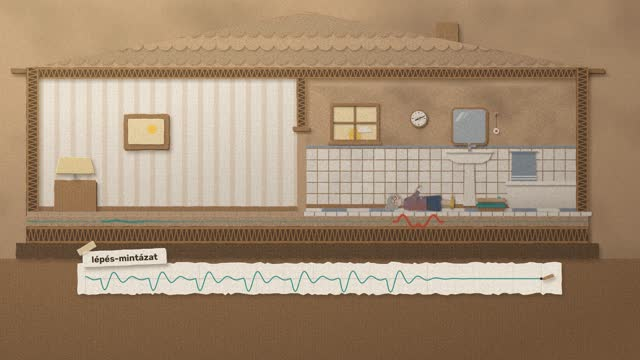
out/phase3/spot_64.0.jpg
