Kaszti49/RezonFallDetector/out/phase3/spot_sheet.jpg

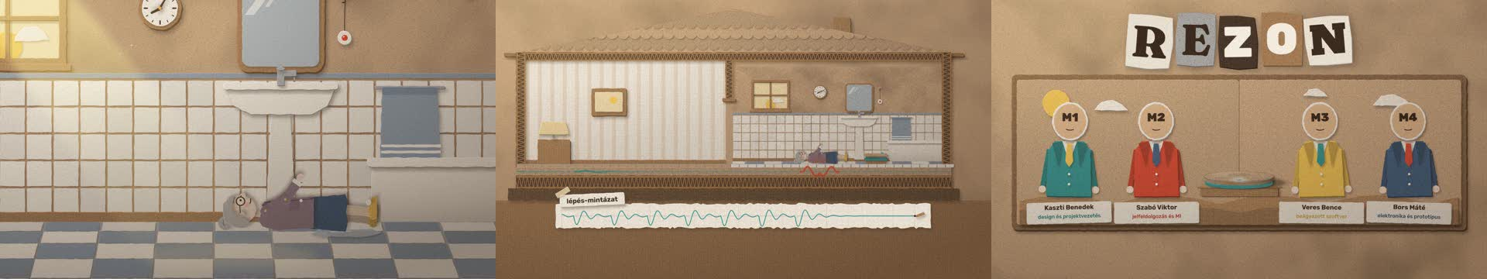
out/phase3/spot_sheet.jpg
