Kaszti49/RezonFallDetector/out/phase3/walk2/element-278.jpeg

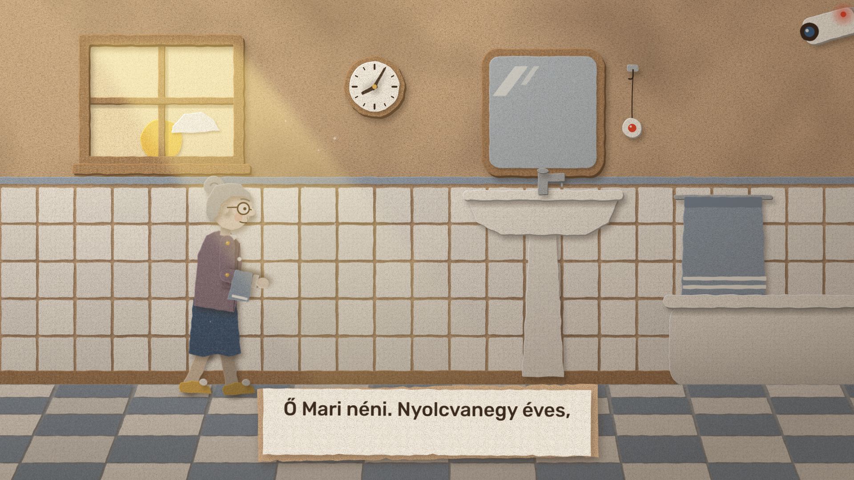
out/phase3/walk2/element-278.jpeg
