Kaszti49/RezonFallDetector/out/phase3/walk_strip2.jpg

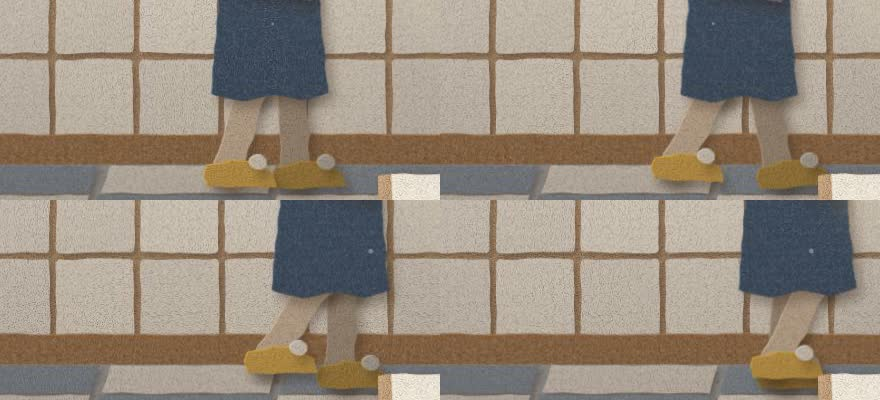
out/phase3/walk_strip2.jpg
