Kaszti49/RezonFallDetector/out/phase3/walk_strip.jpg

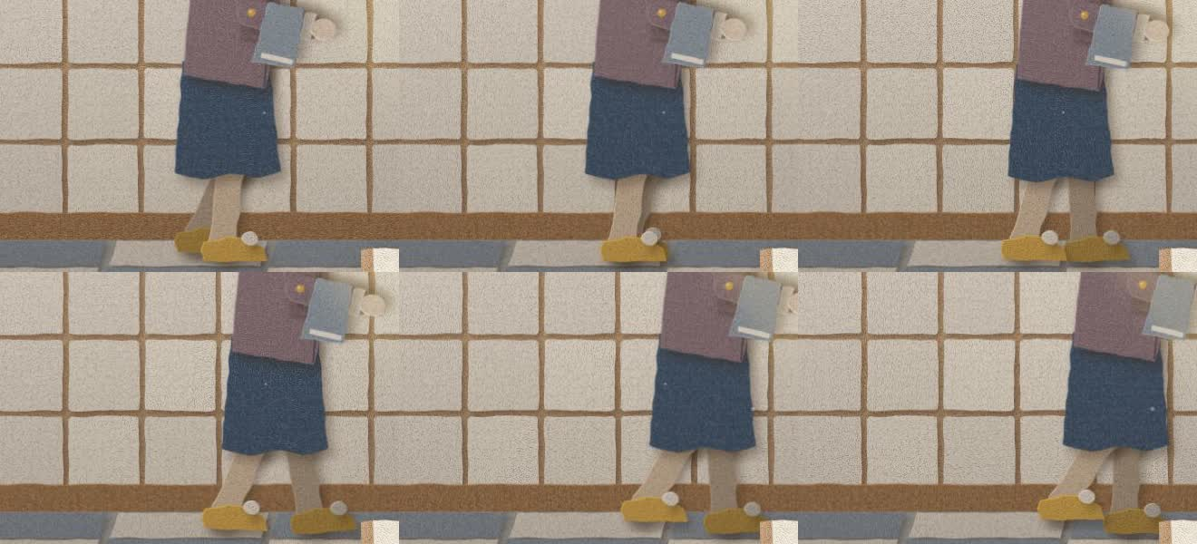
out/phase3/walk_strip.jpg
