Kaszti49/RezonFallDetector/practice/Robot ref1.jpg

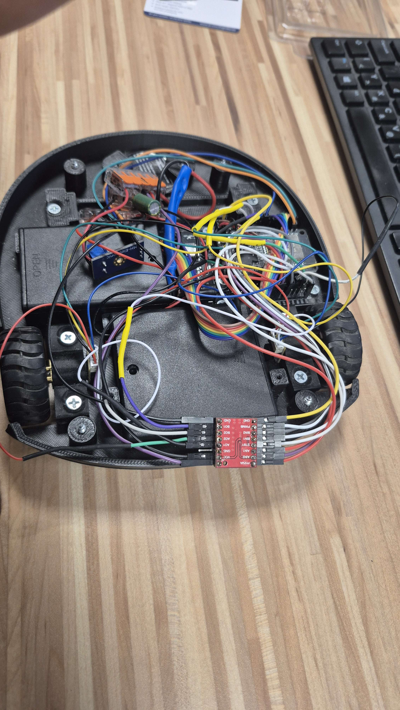
practice/Robot ref1.jpg
