Kaszti49/RezonFallDetector/practice/Robot ref2.jpg

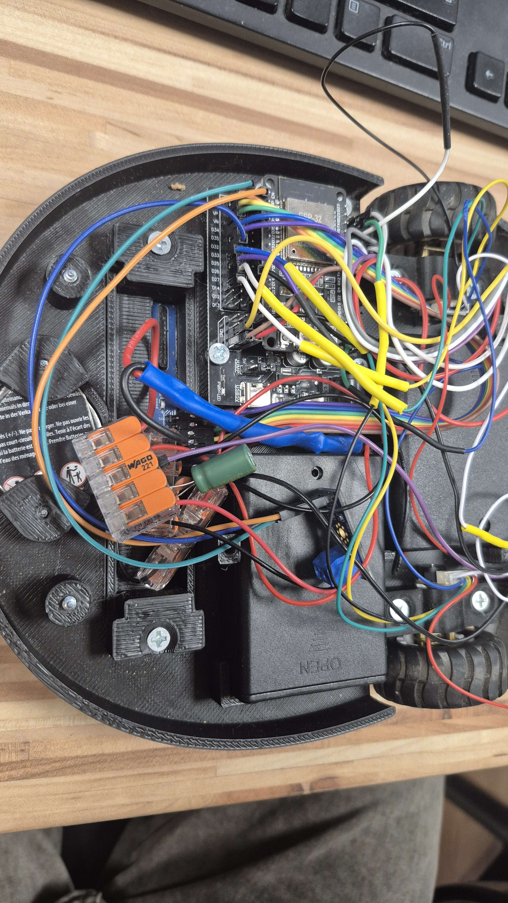
practice/Robot ref2.jpg
