Kaszti49/RezonFallDetector/presentation/assets/S02_1_forgetful_circle.png

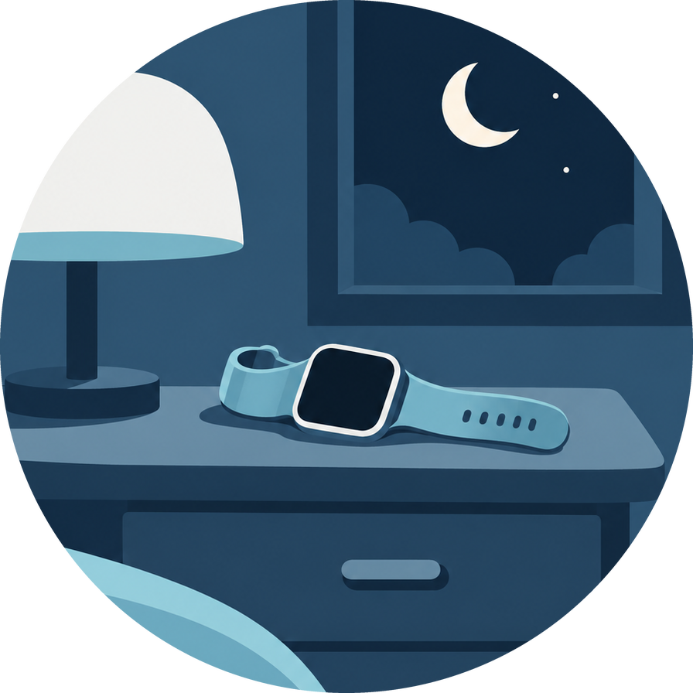
presentation/assets/S02_1_forgetful_circle.png
