Kaszti49/RezonFallDetector/presentation/assets/S02_2_privacy_circle.png

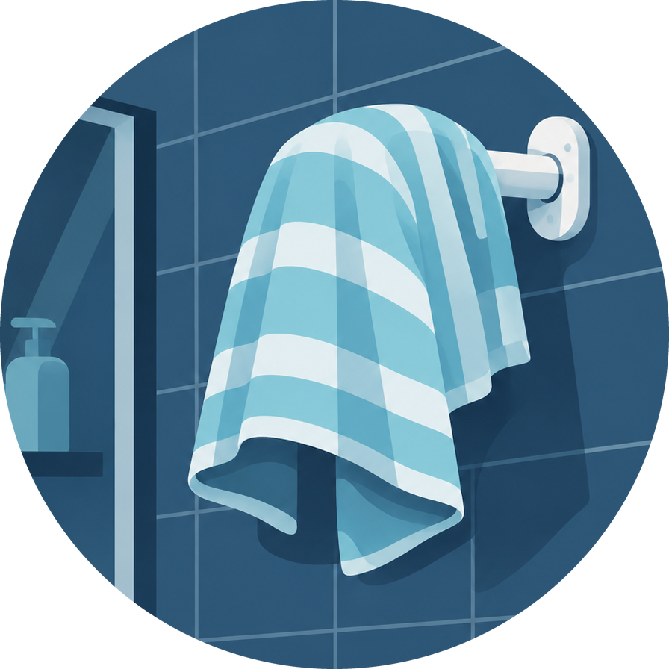
presentation/assets/S02_2_privacy_circle.png
