Kaszti49/RezonFallDetector/presentation/assets/S02_3_chance_circle.png

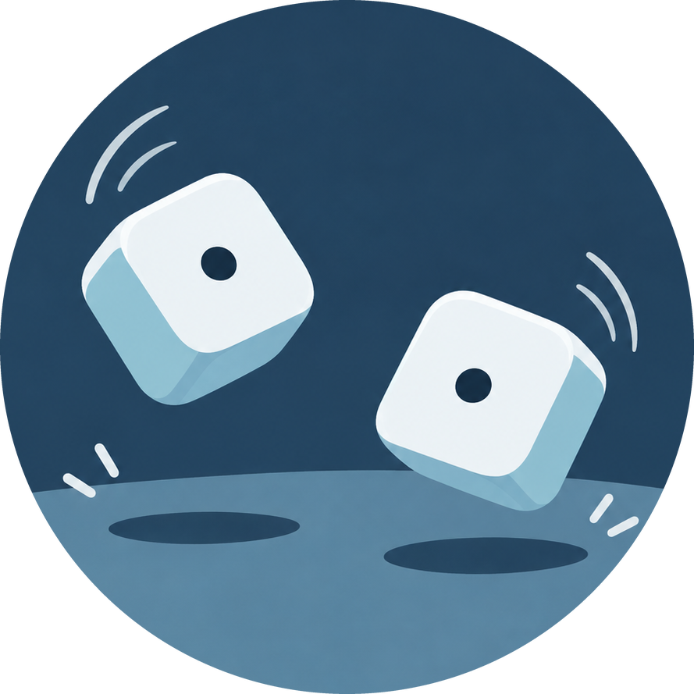
presentation/assets/S02_3_chance_circle.png
