Kaszti49/RezonFallDetector/presentation/renders/S02_styleframe_v1.png

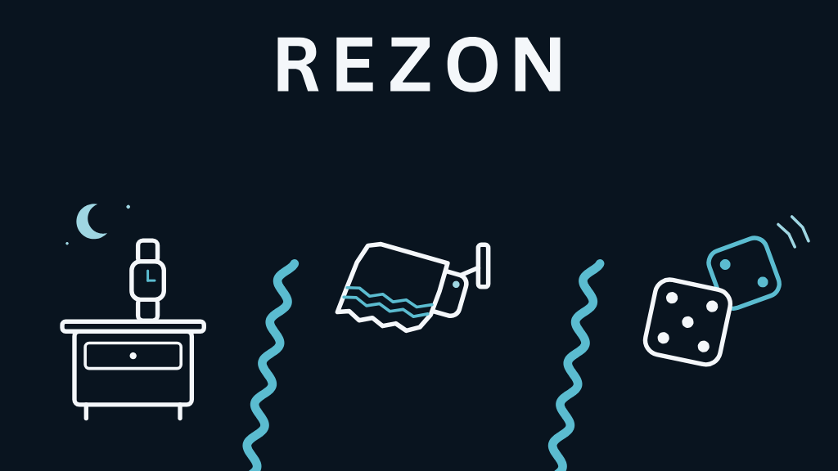
presentation/renders/S02_styleframe_v1.png
