Kaszti49/RezonFallDetector/public/faces/m1_closed.png

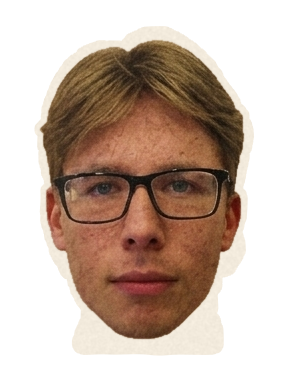
public/faces/m1_closed.png
