Kaszti49/RezonFallDetector/public/faces/m1_open.png

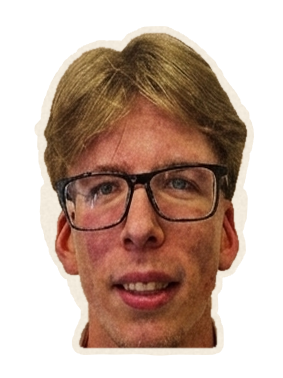
public/faces/m1_open.png
