Kaszti49/RezonFallDetector/public/faces/m2_closed.png

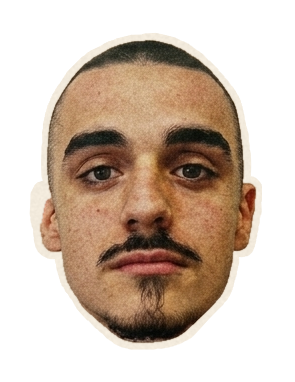
public/faces/m2_closed.png
