Kaszti49/RezonFallDetector/public/faces/m2_open.png

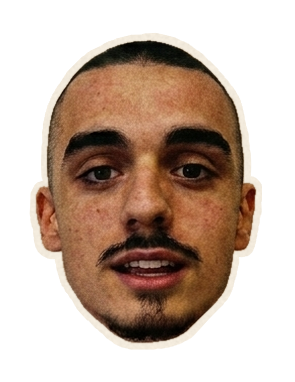
public/faces/m2_open.png
