Kaszti49/RezonFallDetector/public/faces/m3_closed.png

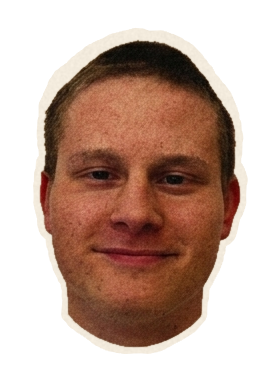
public/faces/m3_closed.png
