Kaszti49/RezonFallDetector/public/faces/m3_open.png

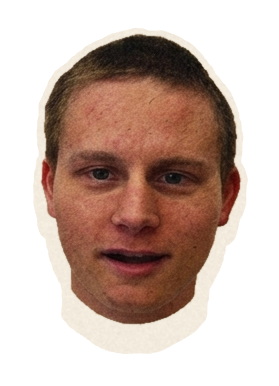
public/faces/m3_open.png
