Kaszti49/RezonFallDetector/public/faces/m4_closed.png

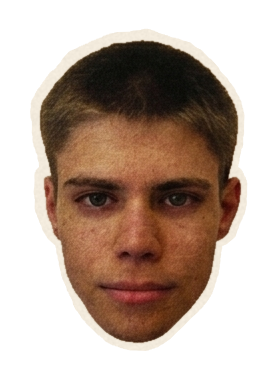
public/faces/m4_closed.png
