Kaszti49/RezonFallDetector/public/faces/m4_open.png

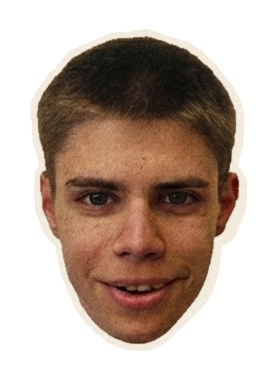
public/faces/m4_open.png
