Kaszti49/RezonFallDetector/uploads/Device1.jpg

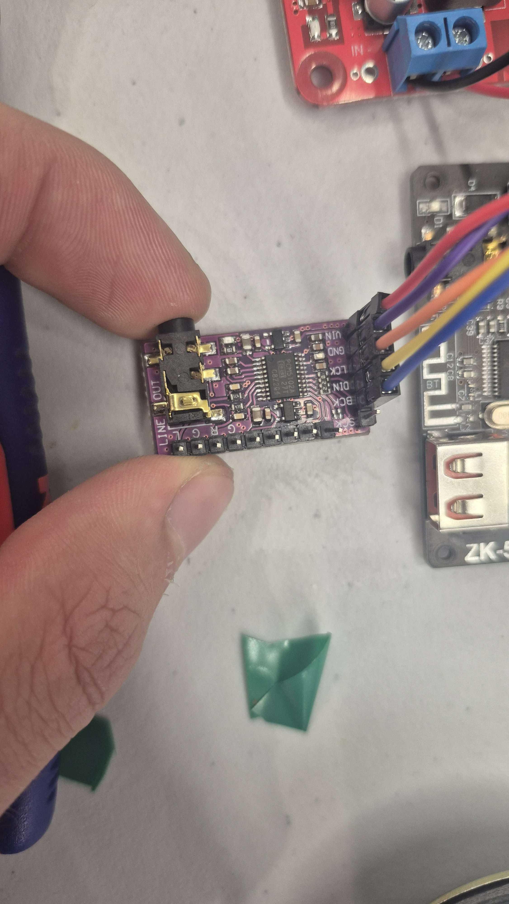
uploads/Device1.jpg
