Kaszti49/RezonFallDetector/uploads/Device2.jpg

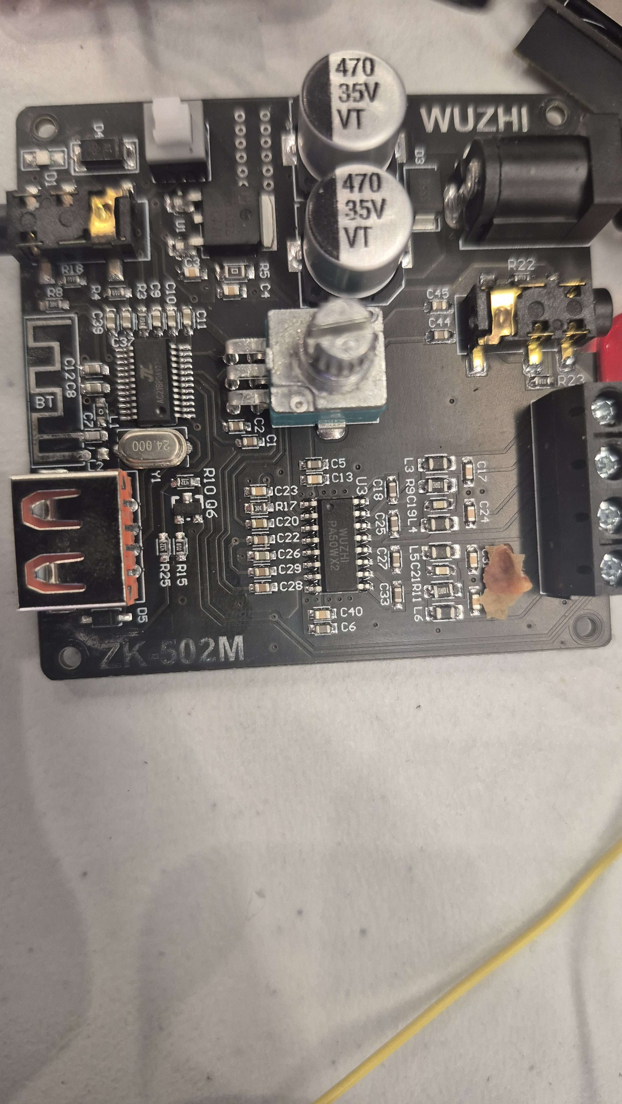
uploads/Device2.jpg
