Kaszti49/RezonFallDetector/uploads/Device3.jpg

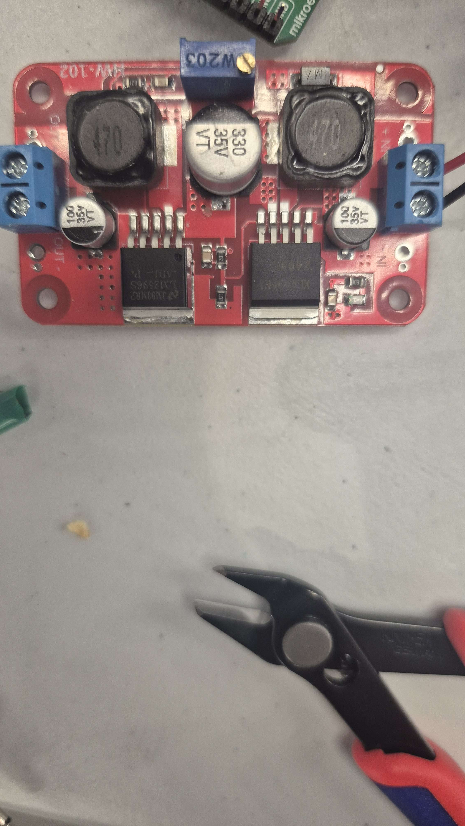
uploads/Device3.jpg
