Kaszti49/RezonFallDetector/uploads/NewSIM.jpg

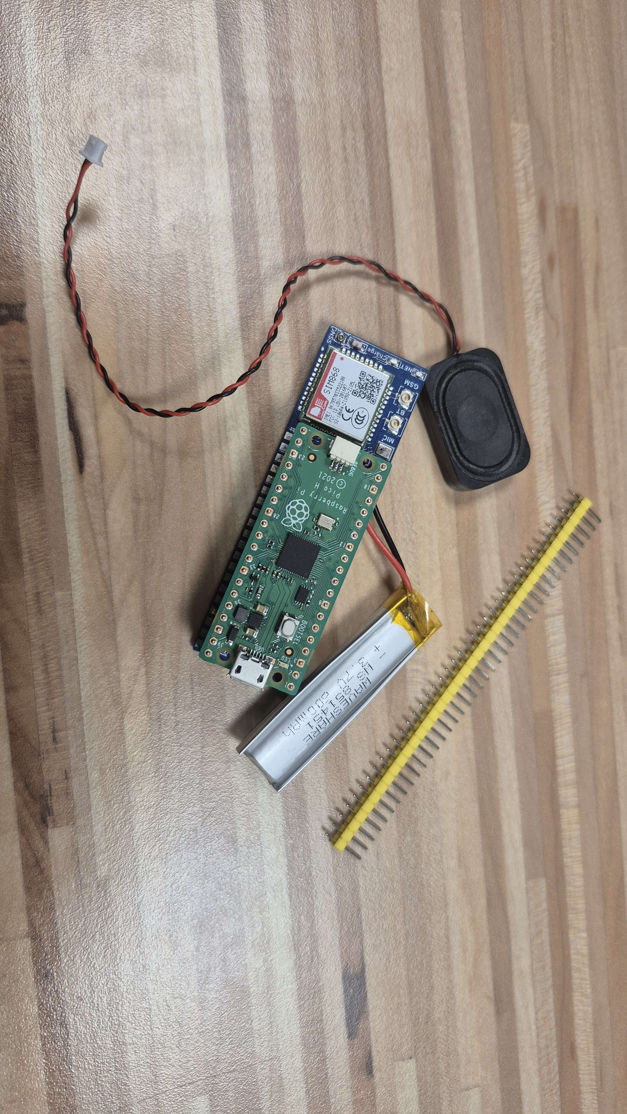
uploads/NewSIM.jpg
