Kaszti49/RezonFallDetector/uploads/S02_1_forgetful.png

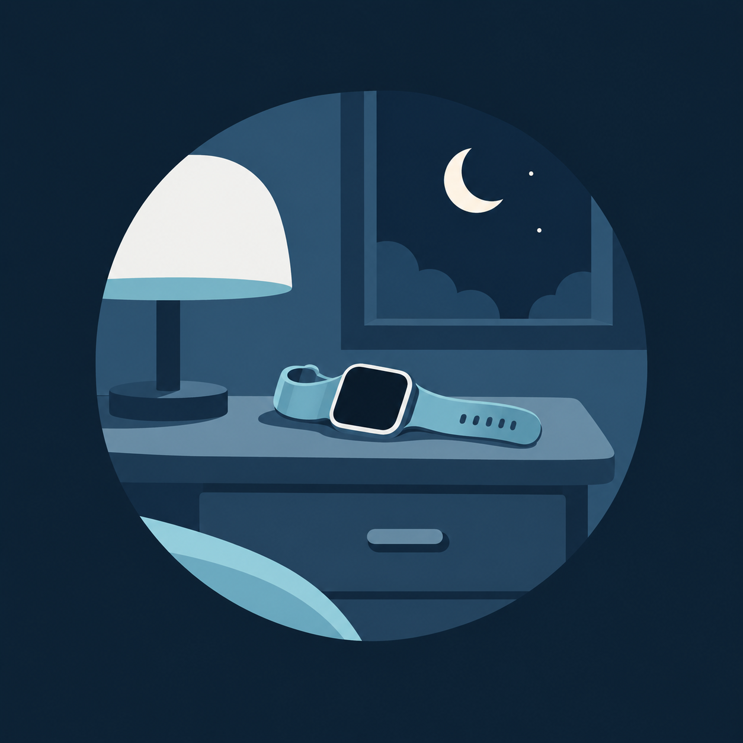
uploads/S02_1_forgetful.png
