Kaszti49/RezonFallDetector/uploads/S02_2_privacy.png

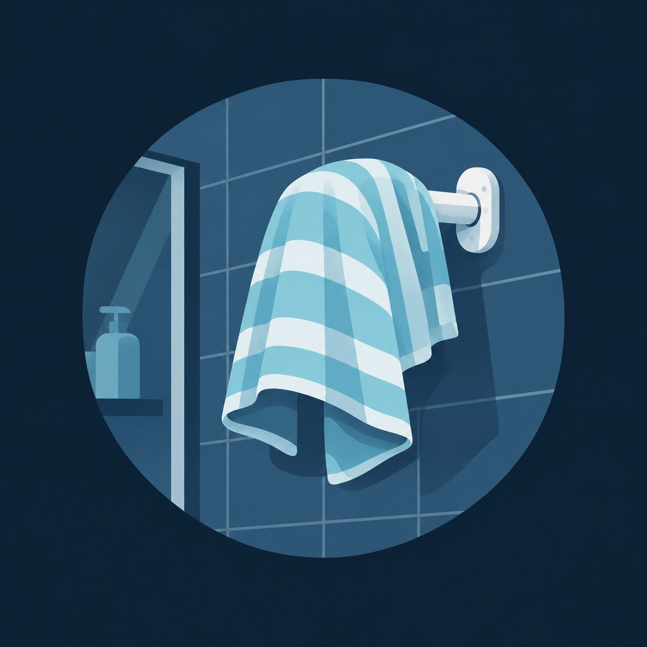
uploads/S02_2_privacy.png
