Kaszti49/RezonFallDetector/uploads/S02_3_chance.png

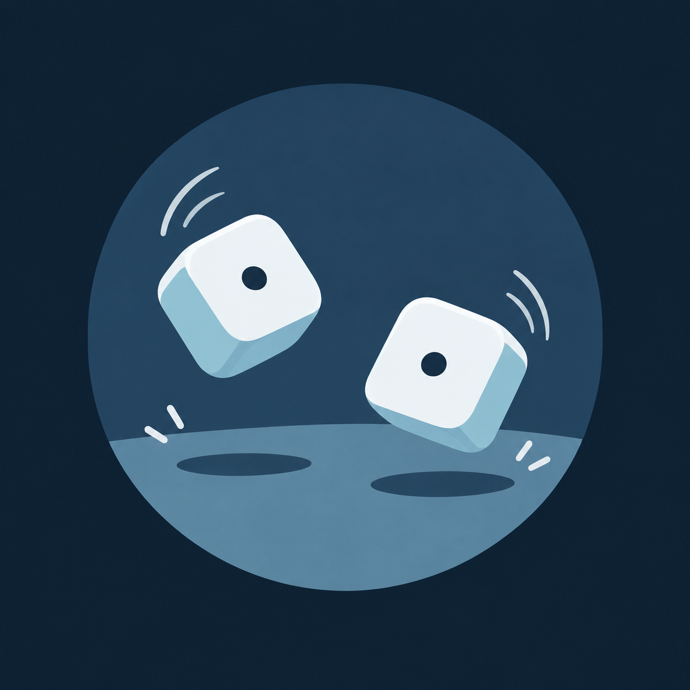
uploads/S02_3_chance.png
