Kaszti49/RezonFallDetector/uploads/Slide1 ref.png

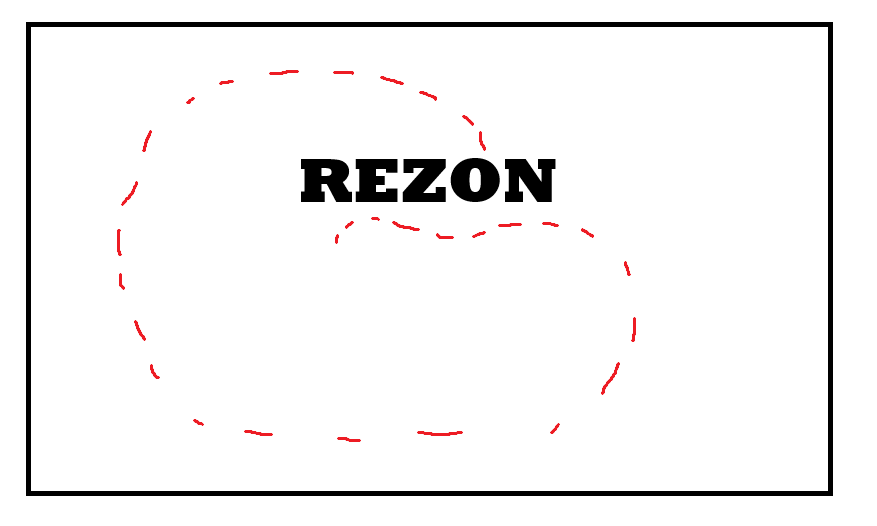
uploads/Slide1 ref.png
