Kaszti49/RezonFallDetector/uploads/Slide2 ref.png

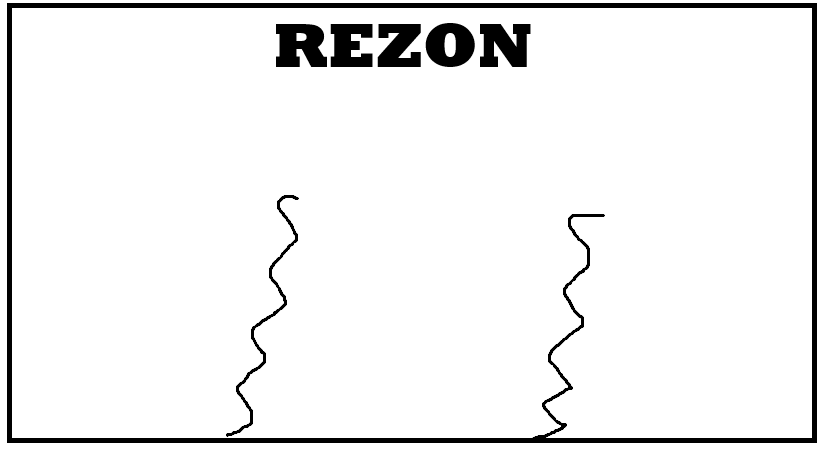
uploads/Slide2 ref.png
