Kaszti49/RezonFallDetector/uploads/Swiggly line ref.png

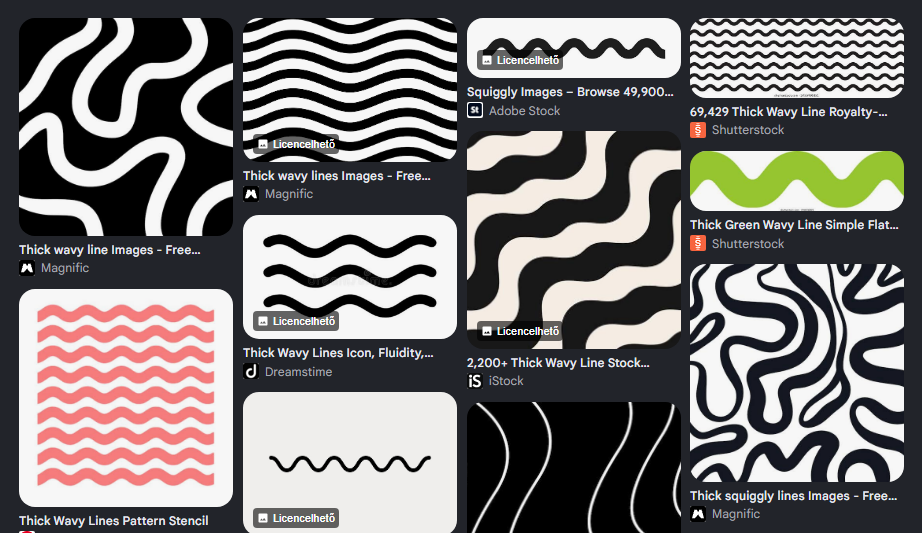
uploads/Swiggly line ref.png
