Kaszti49/RezonFallDetector/Rezon_Full_Mockup.stl

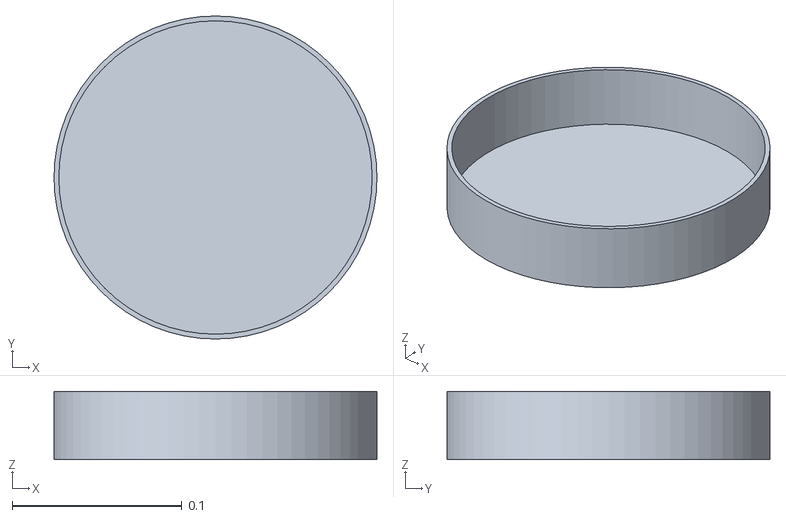
[picture p104: CAD file, 2026-11-14]
Rezon_Full_Mockup.stl
0.19 x 0.19 x 0.04
