Kaszti49/RezonFallDetector/Rezon_Walls_Mockup.stl

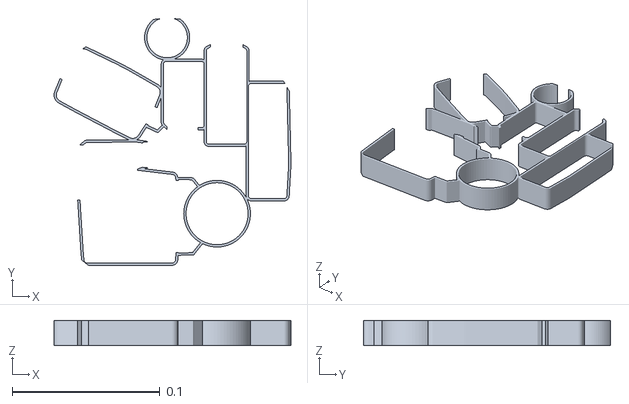
[picture p105: CAD file, 2026-11-14]
Rezon_Walls_Mockup.stl
0.161 x 0.167 x 0.0172
