Kaszti49/RezonFallDetector/Rezon_Lid.stl

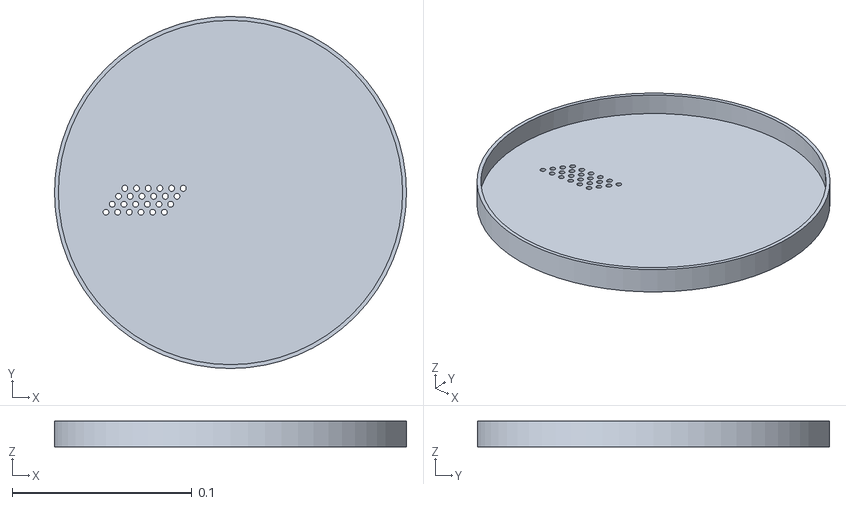
[picture p106: CAD file, 2026-11-14]
Rezon_Lid.stl
0.196 x 0.196 x 0.0143
