Kaszti49/RezonFallDetector/(list of files, cad)

Other CAD files:
Rezon_Full_Mockup.blend
