Kaszti49/RezonFallDetector/Rezon_Wiring_List.pdf

# REZON fall detector · wiring list

SM-24 geophone · ADC 15 Click · ESP32-S3 · PCM5102A + PAM8403 · SIM868 (Waveshare) · 18650 · hackathon build · 2026-11-12 · same numbering as the 3D guide (Rezon_Wiring_Guide.html)

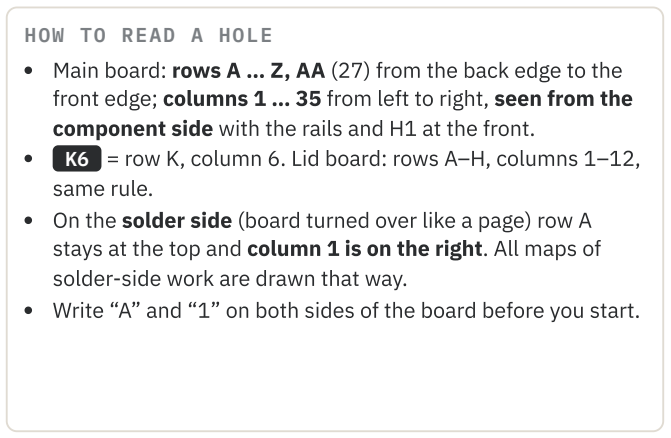
[picture p107: figure]
HOW TO READ A HOLE; same rule.; solder-side work are drawn that way.

Main board: rows A … Z, AA (27) from the back edge to the front edge; columns 1 … 35 from left to right, seen from the

component side with the rails and H1 at the front.
K6 = row K, column 6. Lid board: rows A–H, columns 1–12,

On the solder side (board turned over like a page) row A stays at the top and column 1 is on the right. All maps of

Write “A” and “1” on both sides of the board before you start.

## HOW EVERY CONNECTION IS MADE

Bare wire (rails/buses): 20 AWG solid, laid across the pads on the solder side, soldered at each listed hole.

Bridge: bend the component leg flat onto the neighbouring pin and solder both (one joint).

Link (33×): one insulated core from the 6×0.22 cable on the solder side. Cut to the listed length, strip 3 mm both ends, solder each end onto the named pin leg. “via” lists the corner holes the wire passes over.

Top wire: on the component side (screw terminals, module pads).

Two wires may cross (insulated); a link never runs along a bare rail.

Colours are for reading the list. The insulated cores can be any colour; label both ends with tape if they are all the same.

## BOARD LAYOUT · COMPONENT SIDE

1

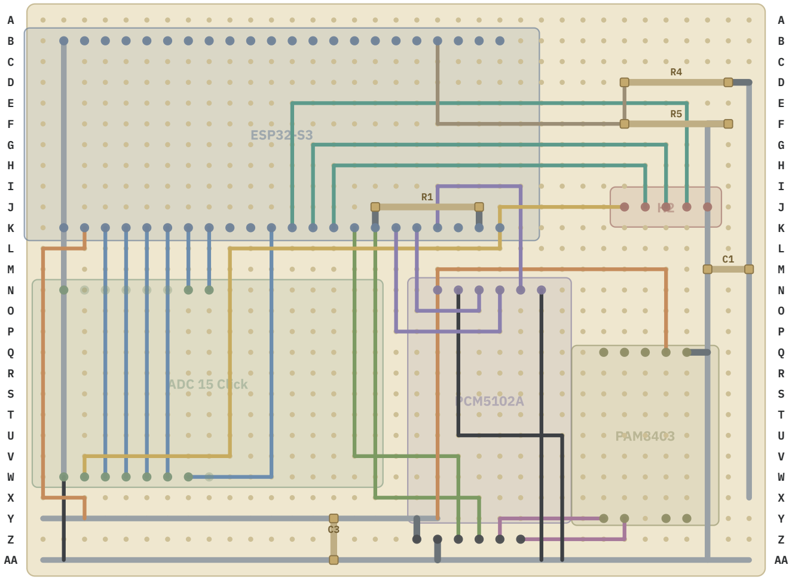
[picture p108: figure]
ESP32-S3; ADC 15 Click; PCM5102A; PAM8403

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
COMPONENT SIDE · row A (back) at the top · column 1 on the left · solder-side wires shown through the board

Check your modules first. The ESP32-S3 rows must be 9 holes apart (B and K), the Click rows 9 apart (N and W). If one of yours differs, shift that module’s second row and every hole that refers to it. Firmware pin map: SCK 12, MISO 13, MOSI 14, ADC-CS 11, clock-CS 9, DRDY 10, ADC-RST 8, I²S BCK 4 / LCK 5 / DIN 6, SIM868 TXD→GPIO18, GPIO17→SIM868 RXD, SIM868 PWRKEY 16

(HIGH 1.5 s), button 7, LED 15, VBAT/2 on GPIO1.

## REF Every pin hole on the main board

## ESP32-S3

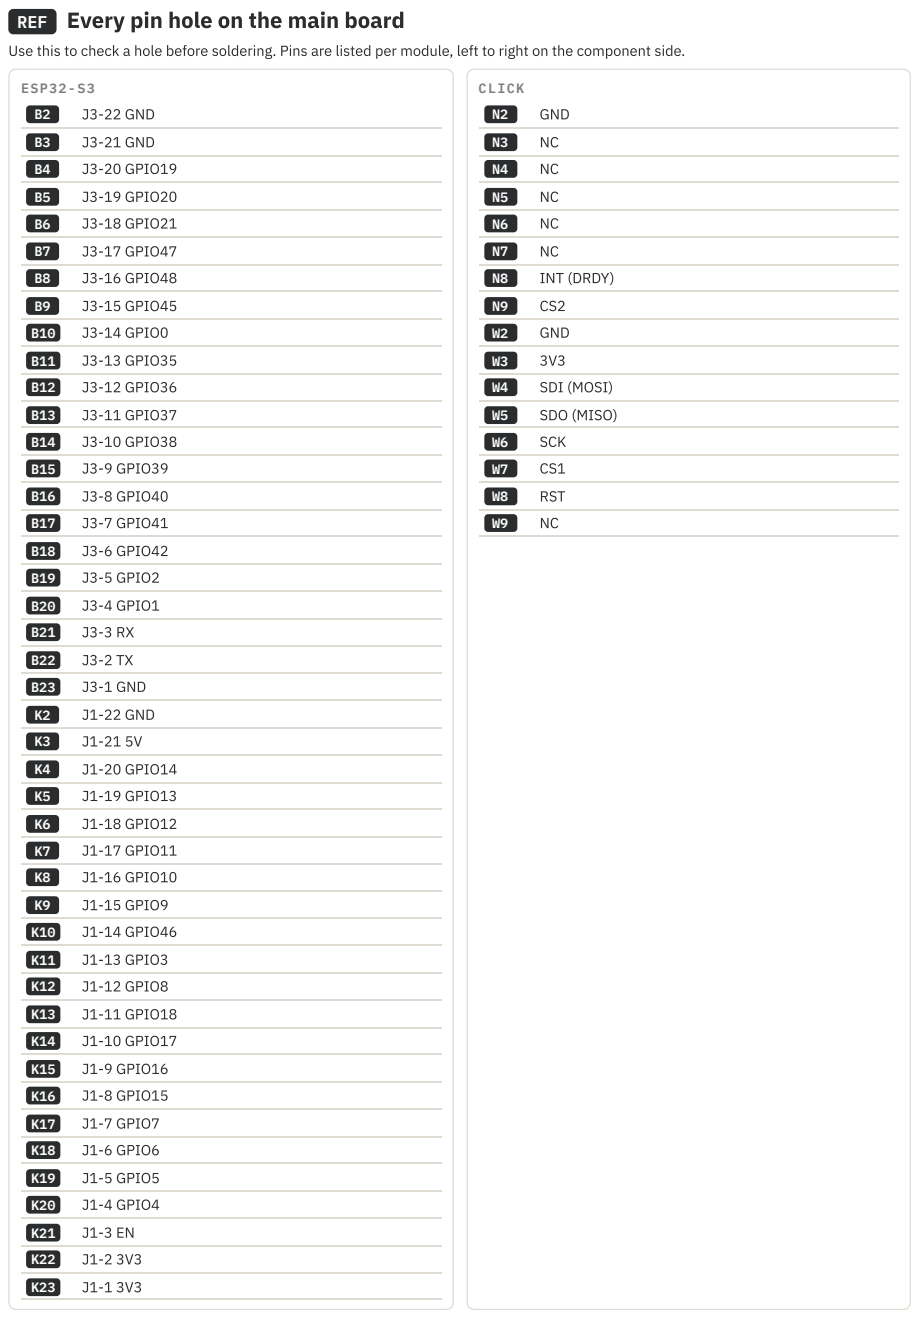
[picture p109: page 3]
J3-22 GND; J3-21 GND; J3-20 GPIO19; J3-19 GPIO20; J3-18 GPIO21; J3-17 GPIO47; J3-16 GPIO48; J3-15 GPIO45; J3-14 GPIO0; J3-13 GPIO35; J3-12 GPIO36; J3-11 GPIO37; J3-10 GPIO38; J3-9 GPIO39; J3-8 GPIO40; J3-7 GPIO41; J3-6 GPIO42; J3-5 GPIO2; J3-4 GPIO1; J3-1 GND; J1-22 GND; J1-20 GPIO14; J1-19 GPIO13; J1-18 GPIO12; J1-17 GPIO11; J1-16 GPIO10; J1-15 GPIO9; J1-14 GPIO46; J1-13 GPIO3; J1-12 GPIO8; J1-11 GPIO18; J1-10 GPIO17; J1-9 GPIO16; J1-8 GPIO15; J1-7 GPIO7; J1-6 GPIO6; J1-5 GPIO5; J1-4 GPIO4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

Use this to check a hole before soldering. Pins are listed per module, left to right on the component side.

## PCM5102A N20 VIN

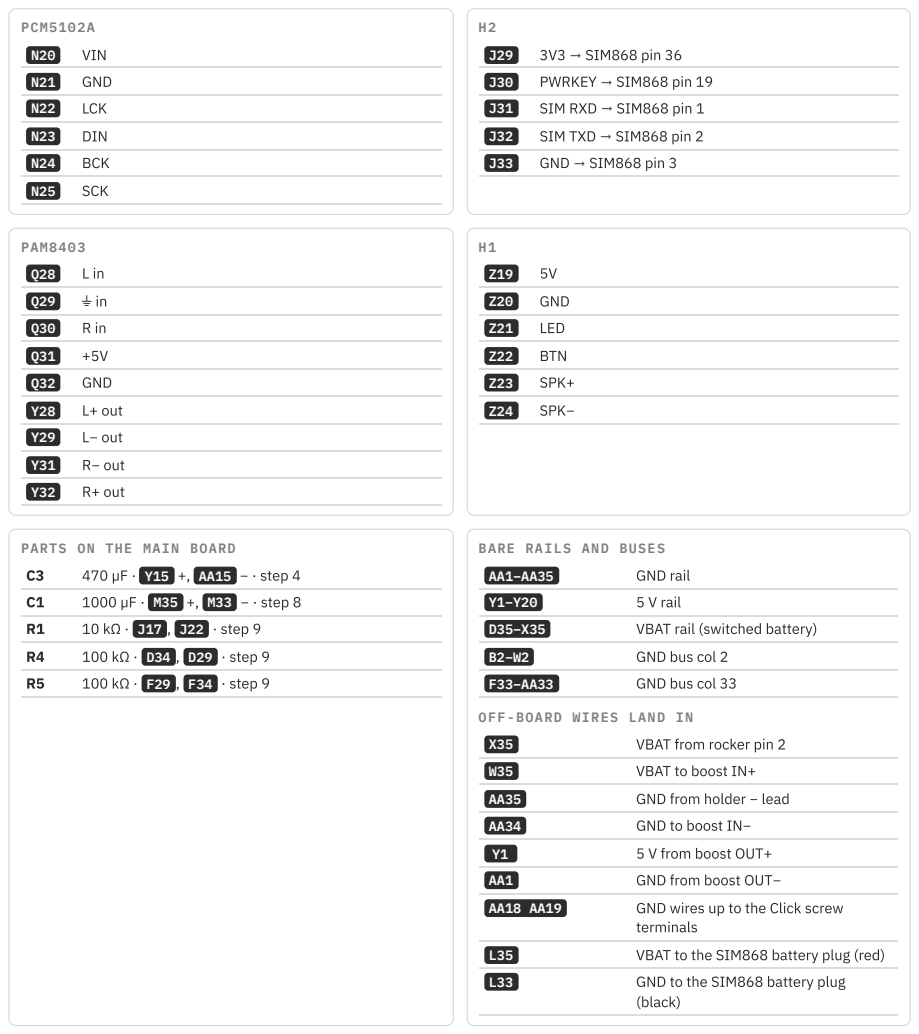
[picture p110: page 4]

PARTS ON THE MAIN BOARD

BARE RAILS AND BUSES

OFF-BOARD WIRES LAND IN

## STEP 2 Cut the perfboard

### Cutting bench

Cut the 9 × 15 cm perfboard (stock row 101) into the main board (35 columns × 27 rows of holes, ≈ 90 × 70 mm) and the lid board (12 × 8 holes, ≈ 30 × 20 mm). Score both sides along a hole row, snap, sand flat, knock 1 mm off each corner. With a pen, write “A” at the back

edge and “1” at the left edge on BOTH sides of the main board.

## STEP 3 Sockets, headers & module pins

### Soldering station Cutting bench

Component side up. Solder every socket and header before any wire. Plug the module in while soldering so the rows stay parallel; tack one pin at each end first, check, then solder the rest.

## HOLES

B2 … B23 | ESP32-S3 J3 socket, 22 contacts. B23 = J3-1 (GND, antenna end), B2 = J3-22 (GND, USB end)
K2 … K23 | ESP32-S3 J1 socket, 22 contacts. K23 = J1-1 (3V3), K3 = J1-21 (5V), K2 = J1-22 (GND)
N2 … N9 | Click back header socket, 8 contacts. N9 = CS2, N8 = INT, N7–N3 = NC, N2 = GND
W2 … W9 | Click front header socket, 8 contacts. W9 = NC, W8 = RST, W7 = CS1, W6 = SCK, W5 = SDO, W4 = SDI, W3 = 3V3,
J29 … J33 | H2 SIM868 header, 5 male pins pointing up: J29 3V3, J30 PWRKEY, J31 SIM RXD, J32 SIM TXD, J33 GND (the SIM868 board itself is off the perfboard, at the back wall)
N20 … N25 | PCM5102A: its own male header soldered straight into the board. N20 VIN, N21 GND, N22 LCK, N23 DIN, N24 BCK, N25 SCK
Q28 … Q32 | PAM8403 input/power pins (male header pins, module 2 mm above the board): Q28 L in, Q29 ⏚ in, Q30 R in, Q31
| +5V, Q32 GND
Y28 Y29 Y31 Y32 | PAM8403 output pins: Y28 L+, Y29 L−, Y31 R−, Y32 R+
Z19 … Z24 | H1 lid header, 6 male pins pointing up: Z19 5V, Z20 GND, Z21 LED, Z22 BTN, Z23 SPK+, Z24 SPK−

1

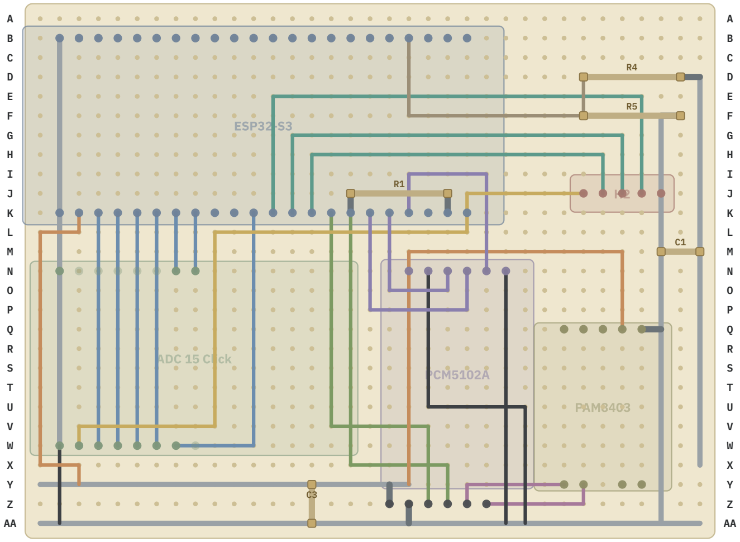
[picture p111: figure]
ESP32-S3; ADC 15 Click; PCM5102A; PAM8403

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
COMPONENT SIDE · row A (back) at the top · column 1 on the left · solder-side wires shown through the board

## STEP 4 Rails, buses & power distribution

## DO THESE IN ORDER

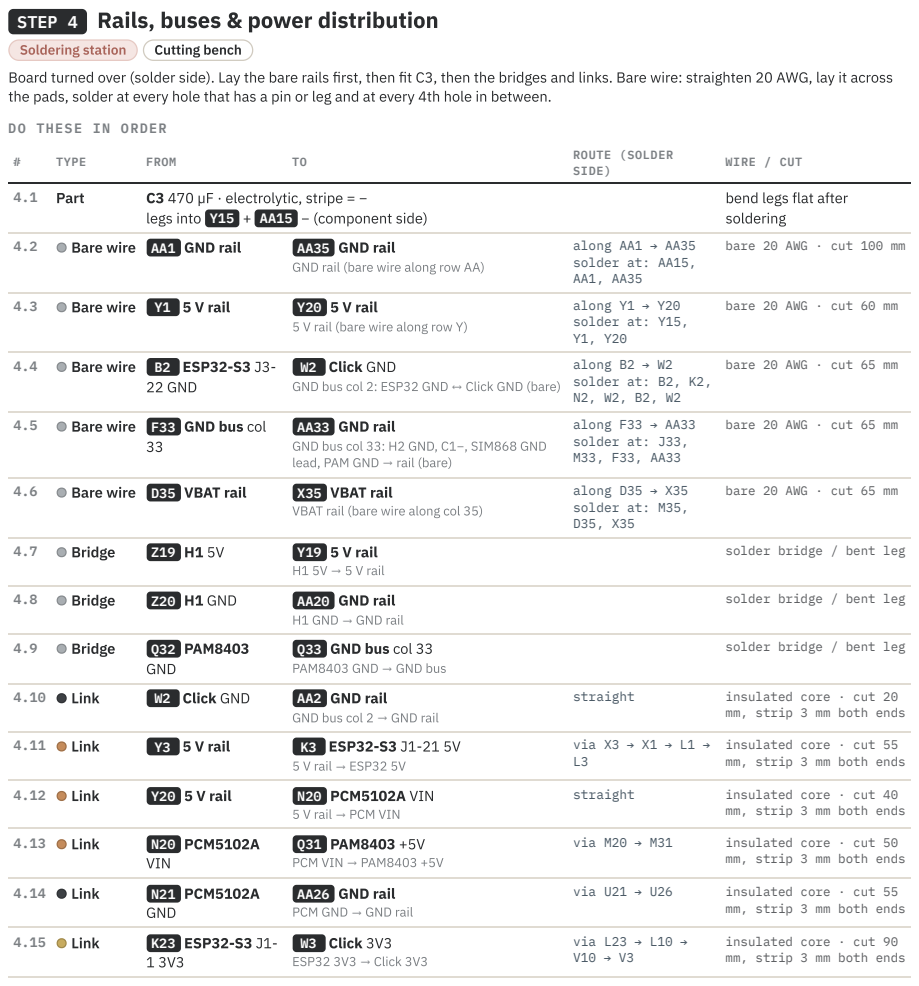
[picture p112: page 7]

Board turned over (solder side). Lay the bare rails first, then fit C3, then the bridges and links. Bare wire: straighten 20 AWG, lay it across
the pads, solder at every hole that has a pin or leg and at every 4th hole in between.

bend legs flat after
soldering
bare 20 AWG · cut 100 mm

legs into Y15 + AA15 − (component side)

GND rail (bare wire along row AA)

bare 20 AWG · cut 60 mm

5 V rail (bare wire along row Y)

W2 Click GND
GND bus col 2: ESP32 GND ↔ Click GND (bare)

bare 20 AWG · cut 65 mm

GND bus col 33: H2 GND, C1−, SIM868 GND
lead, PAM GND → rail (bare)

VBAT rail (bare wire along col 35)

solder bridge / bent leg

GND bus col 2 → GND rail

mm, strip 3 mm both ends

insulated core · cut 55

AA26 GND rail
PCM GND → GND rail

insulated core · cut 90

1

2

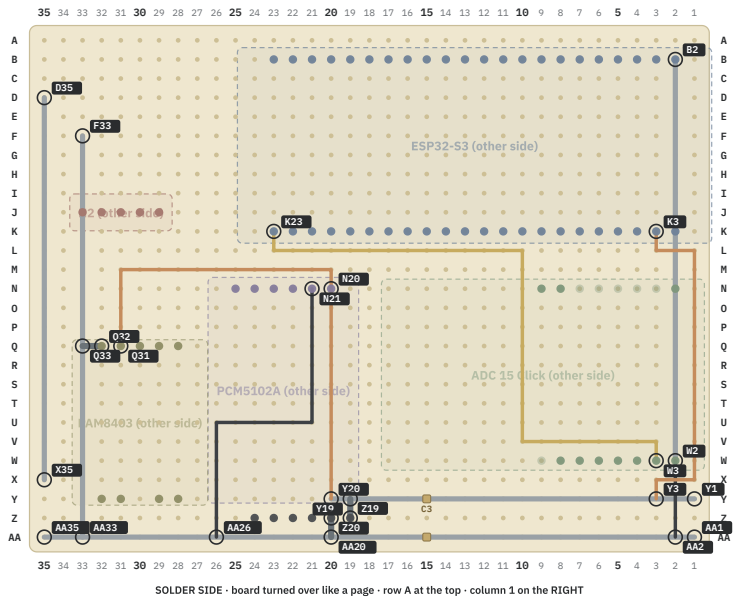
[picture p113: page 8]
ESP32-S3 (other side); PCM5102A (other side); PAM8403 (other side); H2 (other side)

ADC 15 Click (other side)

SOLDER SIDE · board turned over like a page · row A at the top · column 1 on the RIGHT

## STEP 5 ADC 15 Click ↔ ESP32⁻S3 (SPI)

### Soldering station

Seven links on the solder side. Six run straight in one column and pass the Click’s unused NC pins (N3–N7, W9): keep the insulation intact there.

## DO THESE IN ORDER

# | TYPE | FROM | TO

## ROUTE (SOLDER SIDE)

## WIRE / CUT

5.1 | Link | K6 ESP32-S3 J1-18 GPIO12 | W6 Click SCK
| | | SCK
straight | insulated core · cut 40

## mm, strip 3 mm both ends

5.2 | Link | K5 ESP32-S3 J1-19 GPIO13 | W5 Click SDO (MISO)
| | | MISO
straight | insulated core · cut 40

## mm, strip 3 mm both ends

5.3 | Link | K4 ESP32-S3 J1-20 GPIO14 | W4 Click SDI (MOSI) MOSI
straight | insulated core · cut 40

## mm, strip 3 mm both ends

5.4 | Link | K7 ESP32-S3 J1-17 GPIO11 | W7 Click CS1 ADC chip-select
straight | insulated core · cut 40

## mm, strip 3 mm both ends

5.5 | Link | K9 ESP32-S3 J1-15 GPIO9 | N9 Click CS2 clock-chip select
straight | insulated core · cut 20

## mm, strip 3 mm both ends

5.6 | Link | K8 ESP32-S3 J1-16 GPIO10 | N8 Click INT (DRDY) DRDY, active low
straight | insulated core · cut 20

## mm, strip 3 mm both ends

5.7 | Link | K12 ESP32-S3 J1-12 GPIO8 | W8 Click RST
| | | ADC reset
via W12 | insulated core · cut 50

## mm, strip 3 mm both ends

1

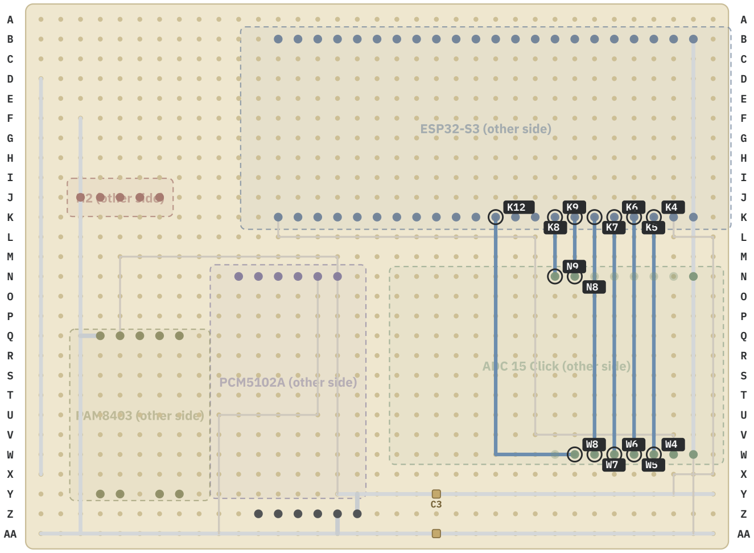
[picture p114: figure]
ESP32-S3 (other side); ADC 15 Click (other side); PCM5102A (other side); PAM8403 (other side); H2 (other side)

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
SOLDER SIDE · board turned over like a page · row A at the top · column 1 on the RIGHT

## STEP 6 Geophone → Click CH1

### Soldering station Small flat screwdriver

Solder the 1 kΩ resistor across the two SM-24 solder tabs. Twist two cores of the 6×0.22 cable (about 1 turn per cm), solder to the tabs (mark the + core). Screw-terminal ends: strip 5 mm, twist, tin lightly. Each terminal takes at most two conductors.

## DO THESE IN ORDER

# | TYPE | FROM | TO

## ROUTE (SOLDER SIDE)

## WIRE / CUT

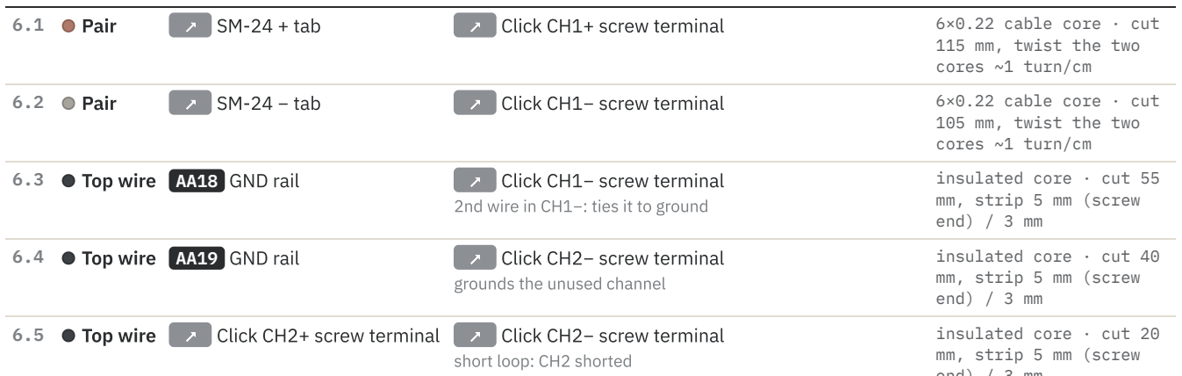
[picture p115: figure]
Pair; SM-24 + tab; Click CH1+ screw terminal; 6×0.22 cable core · cut; 115 mm, twist the two cores ~1 turn/cm; SM-24 − tab; Click CH1− screw terminal; 105 mm, twist the two cores ~1 turn/cm; Top wire; AA18 GND rail; 2nd wire in CH1−: ties it to ground; insulated core · cut 55 mm, strip 5 mm (screw end) / 3 mm; AA19 GND rail; Click CH2− screw terminal; grounds the unused channel; insulated core · cut 40 mm, strip 5 mm (screw end) / 3 mm; Click CH2+ screw terminal; short loop: CH2 shorted; insulated core · cut 20 mm, strip 5 mm (screw

## end) / 3 mm

1

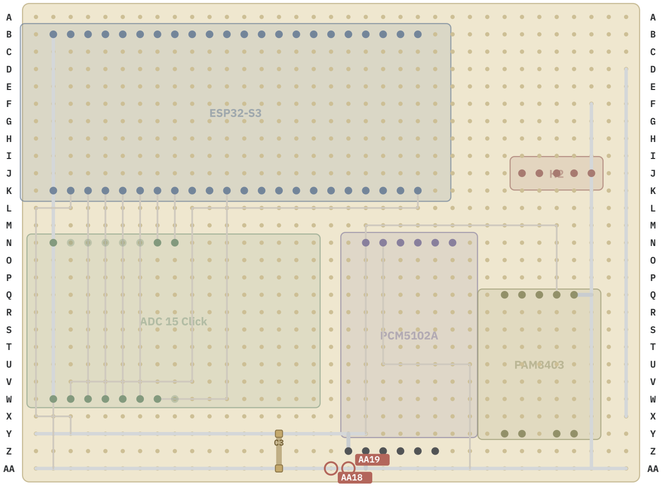
[picture p116: figure]
ESP32-S3; ADC 15 Click; PCM5102A; PAM8403

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
COMPONENT SIDE · row A (back) at the top · column 1 on the left · solder-side wires shown through the board

## STEP 7 Audio: I²S, DAC → amp → H1

### Soldering station

Before wiring, set the PCM5102A back-side jumpers: 1 FLT = L, 2 DEMP = L, 3 XSMT = H, 4 FMT = L. The two DAC → amp wires run on the

component side, pad to pad on top of the modules.

## DO THESE IN ORDER

# | TYPE | FROM | TO

## ROUTE (SOLDER SIDE)

## WIRE / CUT

7.1 | Link | Y28 PAM8403 L+ out | Z23 H1 SPK+
| | | speaker +
via Y23 | insulated core · cut 25

## mm, strip 3 mm both ends

7.2 | Link | Y29 PAM8403 L− out | Z24 H1 SPK−
| | | speaker −, NOT ground
via Z29 | insulated core · cut 25

## mm, strip 3 mm both ends

7.3 | Link | K20 ESP32-S3 J1-4 GPIO4 | N24 PCM5102A BCK bit clock
via I20 → I24 | insulated core · cut 40

## mm, strip 3 mm both ends

7.4 | Link | K19 ESP32-S3 J1-5 GPIO5 | N22 PCM5102A LCK word clock
via O19 → O22 | insulated core · cut 30

## mm, strip 3 mm both ends

7.5 | Link | K18 ESP32-S3 J1-6 GPIO6 | N23 PCM5102A DIN
via P18 → P23 | insulated core · cut 40

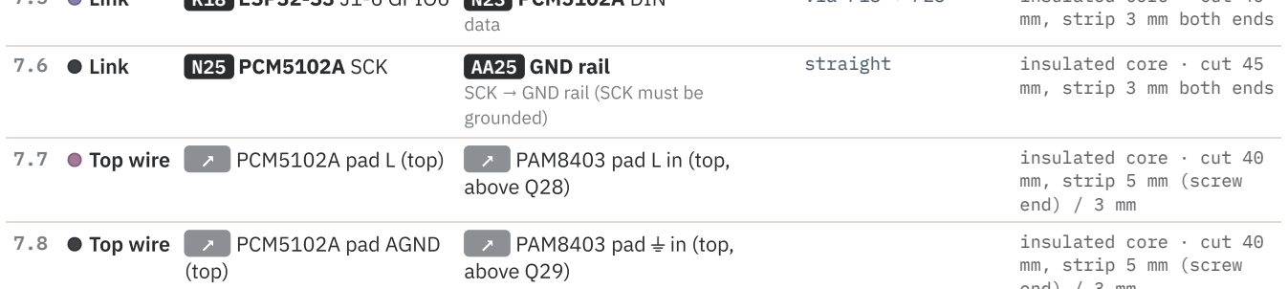
[picture p117: figure]
data; mm, strip 3 mm both ends; Link; N25 PCM5102A SCK; AA25 GND rail; SCK → GND rail (SCK must be; grounded); straight; insulated core · cut 45; Top wire; PCM5102A pad L (top); PAM8403 pad L in (top,; above Q28); insulated core · cut 40 mm, strip 5 mm (screw end) / 3 mm; PCM5102A pad AGND; (top); PAM8403 pad ⏚ in (top,; above Q29); insulated core · cut 40 mm, strip 5 mm (screw

## end) / 3 mm

1

2

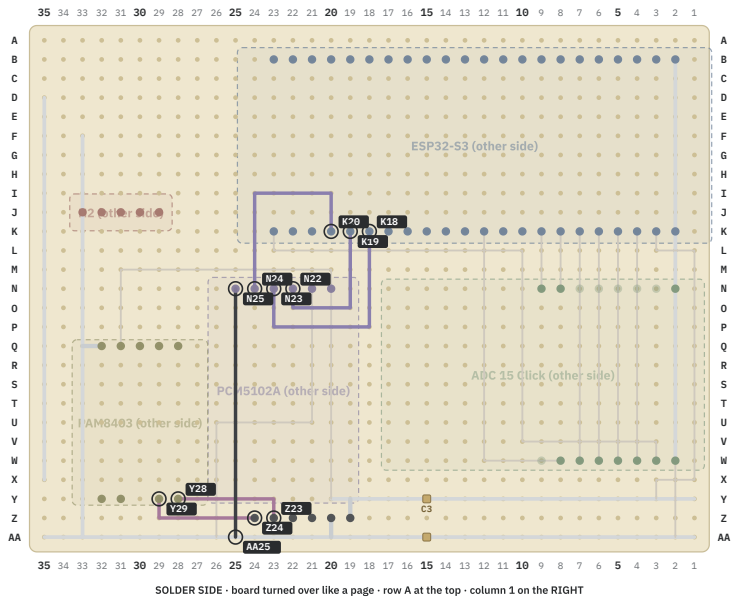
[picture p118: page 12]
ESP32-S3 (other side); PCM5102A (other side); PAM8403 (other side); H2 (other side)

ADC 15 Click (other side)

SOLDER SIDE · board turned over like a page · row A at the top · column 1 on the RIGHT

## STEP 8 SIM868: power leads, UART, jumpers

### Soldering station Cutting bench

The Waveshare Pico-SIM868 board is used as a modem only: pull the Pico H off it, it is not used. Fit C1, then the four links on the solder side to H2. Then the two 0.5 mm² power leads from L35/L33 (top side) to a PH2.0 plug for the board’s battery socket, and five M-F jumpers

from H2 into the board’s Pico sockets. Before power-on: GSM antenna on the “GSM” u.FL socket, nano SIM (PIN off) in the slot, the board’s power slide switch on the battery side.

## SIM868 BOARD: WHAT GOES WHERE

pin 1 (GP0) | SIM868 RXD, through the board’s own 3.3 V ↔ 2.8 V level shifter. From H2 J31 ← GPIO17 (ESP TX). No divider
pin 2 (GP1) | SIM868 TXD. To H2 J32 → GPIO18 (ESP RX).
pin 3 | GND. From H2 J33 (GND bus col 33).
pin 19 (GP14) | PWR_EN: drives an NPN on the SIM868 PWRKEY. HIGH for 1.5 s switches the module on (or off). From H2 J30 ←

pin 36 (3V3 OUT) Powers the board’s level shifter, microphone and RTC backup. From H2 J29 ← ESP32 3V3. Without it the UART

stays dead.

pin 39, pin 40 | VSYS, VBUS: leave EMPTY. Never 5 V into this board.
BAT (PH2.0) | Battery socket → SIM868 VBAT (3.4–4.4 V, 2 A bursts). Red lead from L35 (VBAT rail), black from L33 (GND bus).

Check polarity against the plug of the Li-po in the box.

GSM (u.FL) | GSM antenna, stuck flat to the inner wall at the back left. GNSS and BT sockets stay empty.

## DO THESE IN ORDER

# | TYPE | FROM | TO

## ROUTE (SOLDER SIDE)

## WIRE / CUT

8.1 Part | C1 1000 µF · electrolytic, stripe = −, burst reserve at the SIM868
| | power take-off
legs into M35 + M33 − (component side)

bend legs flat after
soldering
8.2 | Link | K23 ESP32-S3 J1-1
| | 3V3

J29 H2 3V3 → SIM868 pin 36

ESP32 3V3 (J1-1) → H2 3V3 (feeds the

via J23 | insulated core · cut 30

## mm, strip 3 mm both ends

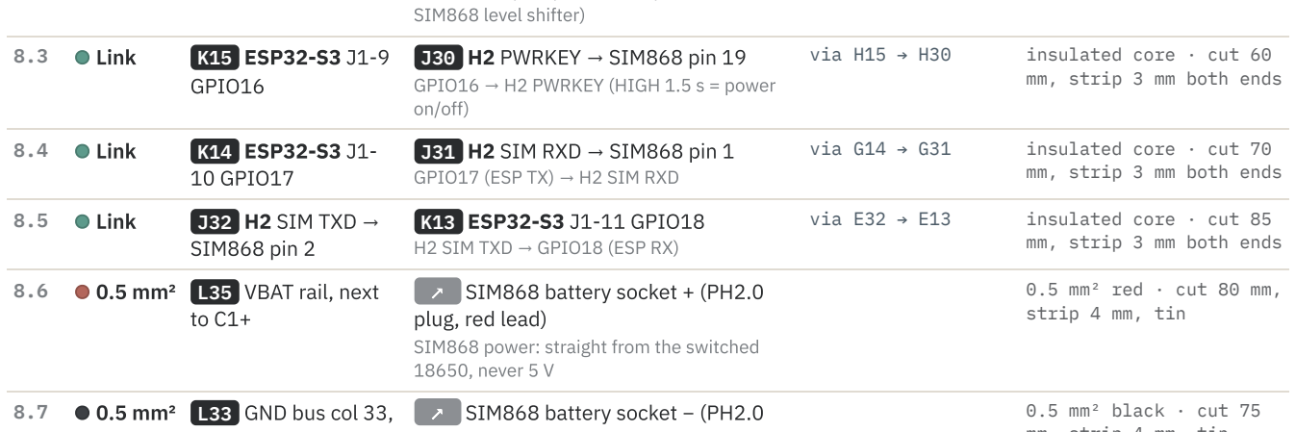
[picture p119: figure]
SIM868 level shifter); Link; K15 ESP32-S3 J1-9; GPIO16; J30 H2 PWRKEY → SIM868 pin 19; GPIO16 → H2 PWRKEY (HIGH 1.5 s = power; on/off); via H15 → H30; insulated core · cut 60; mm, strip 3 mm both ends; K14 ESP32-S3 J1-; 10 GPIO17; J31 H2 SIM RXD → SIM868 pin 1; GPIO17 (ESP TX) → H2 SIM RXD; via G14 → G31; insulated core · cut 70; J32 H2 SIM TXD →; SIM868 pin 2; K13 ESP32-S3 J1-11 GPIO18; H2 SIM TXD → GPIO18 (ESP RX); via E32 → E13; insulated core · cut 85; 0.5 mm²; L35 VBAT rail, next; SIM868 battery socket + (PH2.0; plug, red lead); 18650, never 5 V; 0.5 mm² red · cut 80 mm, strip 4 mm, tin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

SIM868 power: straight from the switched

female end on H2, male end straight into the

## end into the SIM868 socket

8.9 | Jumper | J30 H2 PWRKEY | ↗ | SIM868 header pin 19 (GP14 /

PWR_EN)

female end on H2, male end straight into the

SIM868 socket (Pico removed)

## M-F jumper 10 cm (stock row 39), used as is: female end on H2, male end into the SIM868 socket

8.10 | Jumper | J31 H2 SIM RXD | ↗ | SIM868 header pin 1 (GP0 / RXD)

female end on H2, male end straight into the

SIM868 socket (Pico removed)

## M-F jumper 10 cm (stock row 39), used as is: female end on H2, male end into the SIM868 socket

# | TYPE | FROM | TO

## ROUTE (SOLDER

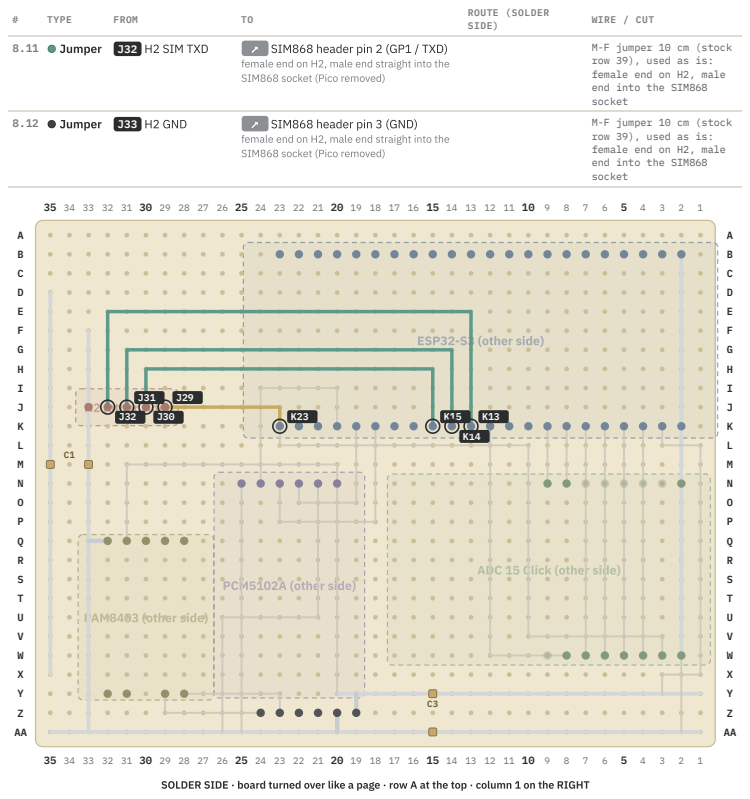
[picture p120: page 14]
SIDE); WIRE / CUT; Jumper; J32 H2 SIM TXD; SIM868 header pin 2 (GP1 / TXD); J33 H2 GND; SIM868 header pin 3 (GND); ESP32-S3 (other side); PCM5102A (other side); PAM8403 (other side); H2 (other side)

M-F jumper 10 cm (stock
row 39), used as is:
female end on H2, male
end into the SIM868
socket

female end on H2, male end straight into the
SIM868 socket (Pico removed)

ADC 15 Click (other side)

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

1

2

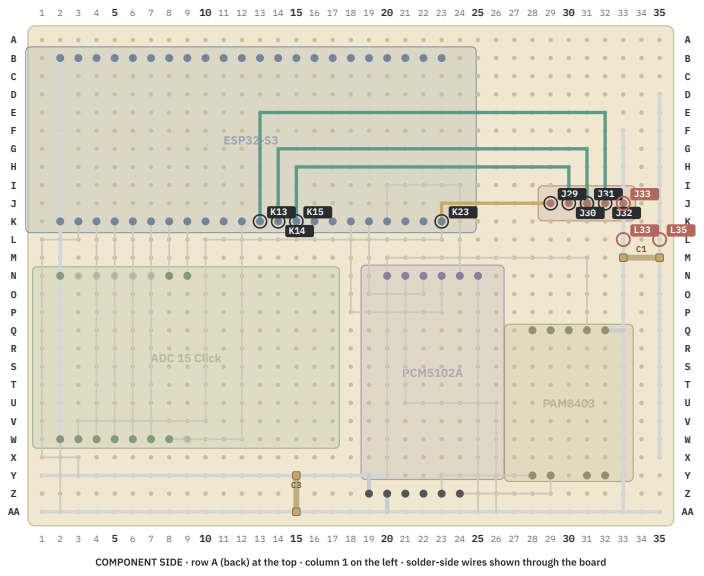
[picture p121: page 15]
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

## STEP 9 Battery sense, button & LED lines

## DO THESE IN ORDER

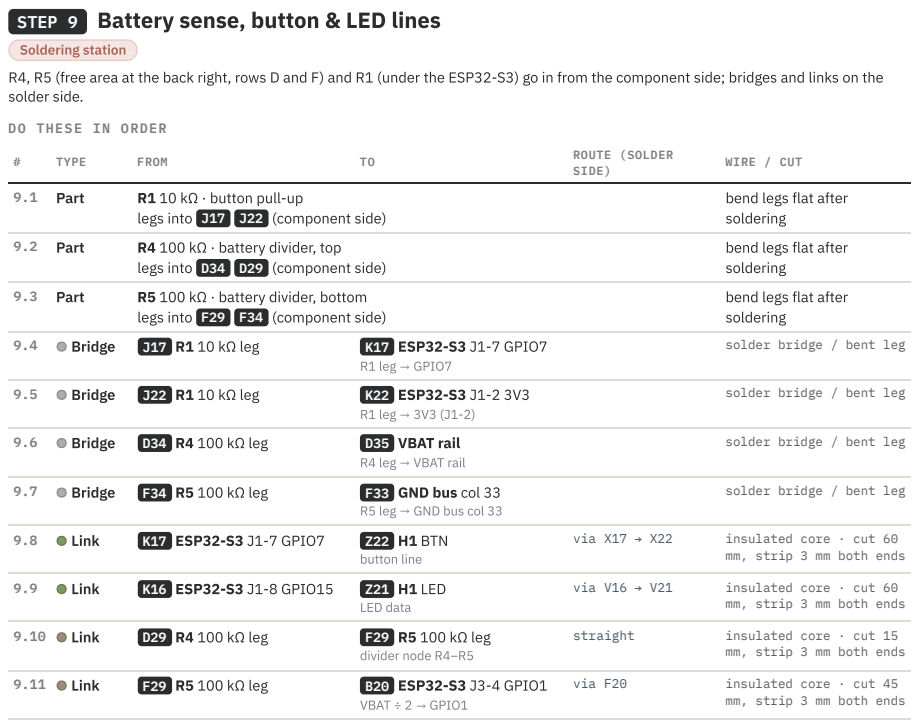
[picture p122: page 16]

R4, R5 (free area at the back right, rows D and F) and R1 (under the ESP32-S3) go in from the component side; bridges and links on the
solder side.

bend legs flat after
soldering

legs into J17 J22 (component side)

legs into D34 D29 (component side)

solder bridge / bent leg

legs into F29 F34 (component side)

R5 leg → GND bus col 33

mm, strip 3 mm both ends

1

2

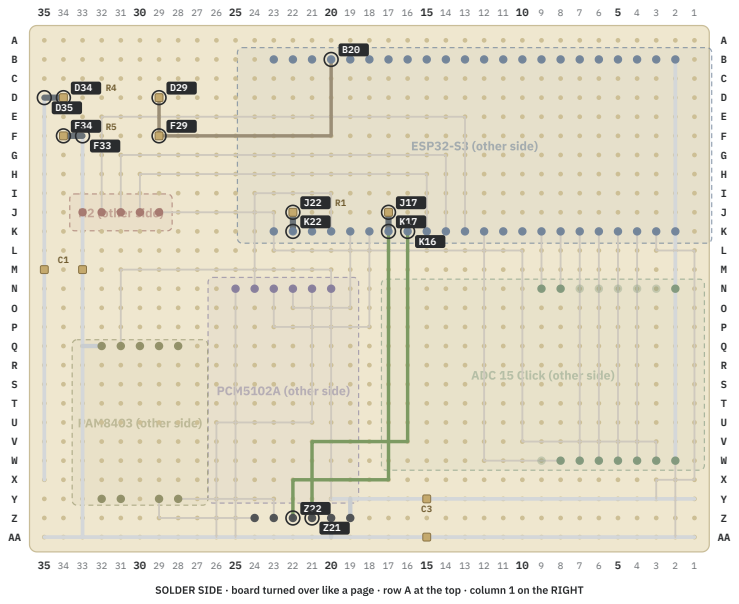
[picture p123: page 17]

ADC 15 Click (other side)

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

# STEP 10 Battery → switch

### Soldering station

Battery out of the holder. Push the rocker into the base’s wall cutout from outside first, then solder its two pins (lamp pin unused). Rail-end holes: tin the 0.5 mm² wire, push it through the hole from the component side and solder it to the rail underneath. No charger board in the device: charge the 18650 in an external charger and use a protected cell (nothing else stops over-discharge).

## DO THESE IN ORDER

# | TYPE | FROM | | TO

## ROUTE (SOLDER SIDE)

| | | | | | WIRE / CUT
10.1 | Lead | ↗ | Holder + lead | ↗ | Rocker pin 1 | holder lead · trim to 65
10.2 | Lead | ↗ | Holder − lead | AA35 GND rail end | holder lead · trim to 65
10.3 | 0.5 mm² | ↗ | Rocker pin 2 | X35 VBAT rail end | 0.5 mm² red · cut 60 mm,
| | | | | | strip 4 mm, tin

1

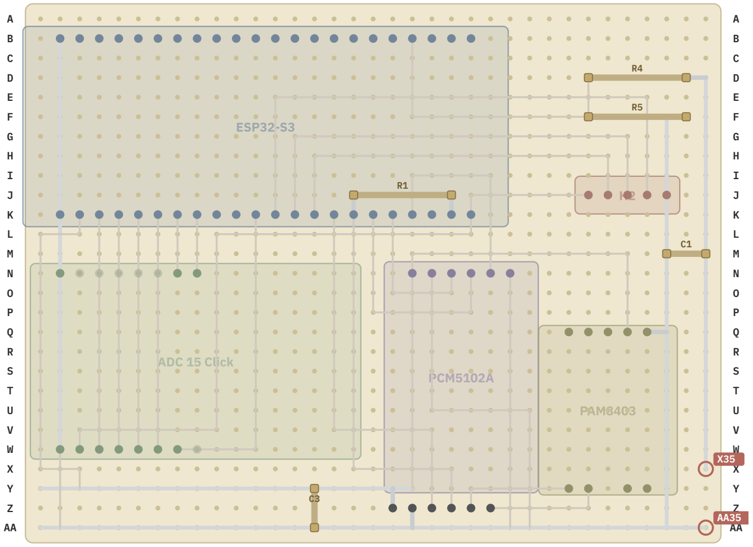
[picture p124: figure]
ESP32-S3; ADC 15 Click; PCM5102A; PAM8403

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

## STEP 11 Boost converter to 5.0 V

## DO THESE IN ORDER

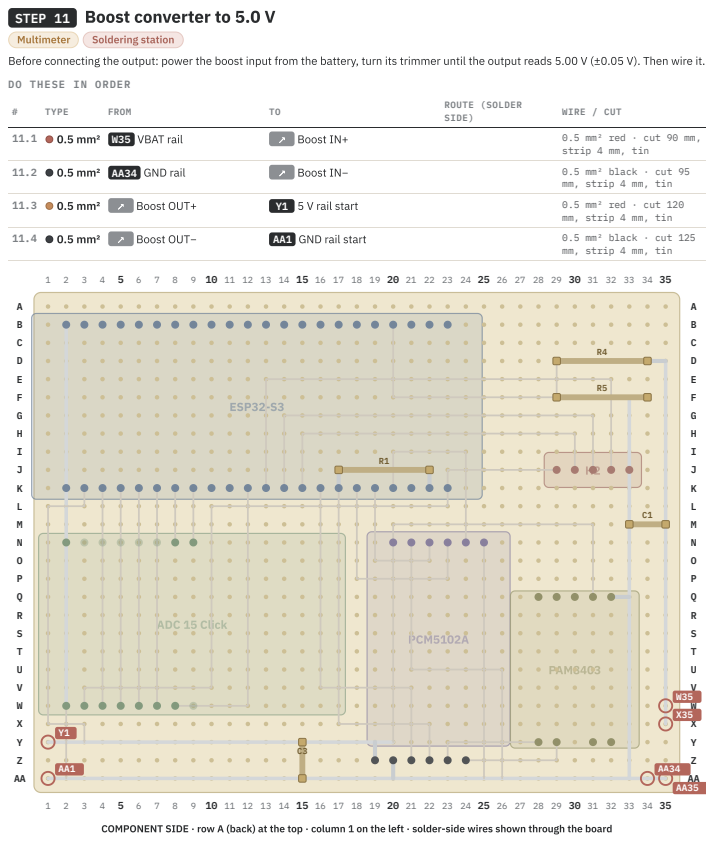
[picture p125: page 19]
Multimeter; Soldering station; TYPE; FROM; ROUTE (SOLDER SIDE); WIRE / CUT; 0.5 mm²; W35 VBAT rail; Boost IN+; 0.5 mm² red · cut 90 mm,; AA34 GND rail; Boost IN−; 0.5 mm² black · cut 95; Boost OUT+; Y1 5 V rail start; 0.5 mm² red · cut 120; Boost OUT−; AA1 GND rail start; 0.5 mm² black · cut 125; ESP32-S3; ADC 15 Click; PCM5102A; PAM8403

Before connecting the output: power the boost input from the battery, turn its trimmer until the output reads 5.00 V (±0.05 V). Then wire it.

strip 4 mm, tin

mm, strip 4 mm, tin

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

## STEP 12 Lid board: button, LED, diode

### Soldering station Cutting bench

Lid board, component side up: fit the parts into the listed holes, then turn it over and make the links. The header pins are bent 90° outward over the edge after soldering.

## PARTS INTO HOLES (COMPONENT SIDE)

C1 D1 E1 F1 | Lid header, 4 straight pins (C1 5V, D1 GND, E1 DIN, F1 BTN), bent 90° outward over the edge
C3 C6 E3 E6 | Tact switch legs (C3 + C6 are joined inside, E3 + E6 are joined inside)
A5 → A9 | 1N4001: anode A5, cathode (stripe) A9
C10 E10 G10 | WS2812B single pixel: stubs (resistor-leg offcuts) from its +5V, DIN, GND pads into C10, E10, G10

## DO THESE IN ORDER

# | TYPE | FROM | TO

## ROUTE (SOLDER SIDE)

## WIRE / CUT

12.1 | Link | C1 Lid header 5V | A5 1N4001 anode

header 5V → diode anode

via A1 | insulated core · cut 25

## mm, strip 3 mm both ends

12.2 | Link | A9 1N4001 cathode (stripe) | C10 WS2812B +5V stub

diode cathode → pixel +5V

via A10 | insulated core · cut 20

## mm, strip 3 mm both ends

12.3 | Link | E1 Lid header DIN | E10 WS2812B DIN stub

header DIN → pixel DIN

## via E2 → F2 → F10 insulated core · cut 40 mm, strip 3 mm both ends

12.4 | Link | D1 Lid header GND | C3 Button leg 1

header GND → button leg 1

via D3 | insulated core · cut 20

## mm, strip 3 mm both ends

12.5 | Link | C3 Button leg 1 | G10 WS2812B GND stub

button leg 1 → pixel GND

via C5 → G5 | insulated core · cut 40

## mm, strip 3 mm both ends

12.6 | Link | F1 Lid header BTN | E6 Button leg 4

header BTN → button leg 4 (diagonal)

via H1 → H6 | insulated core · cut 35

## mm, strip 3 mm both ends

12 11 10 | 9 | 8 | 7 | 6 | 5 | 4 | 3 | 2 | 1

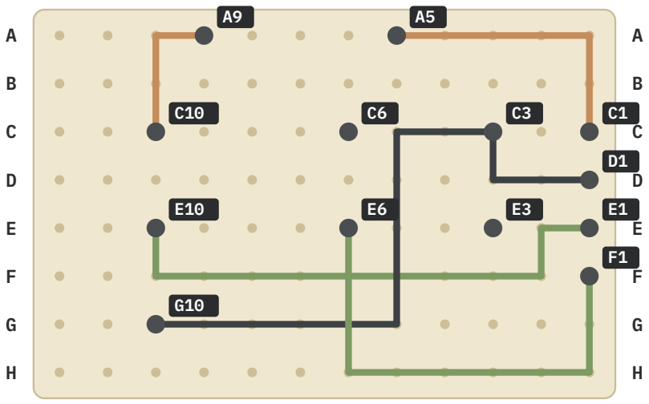
[picture p126: figure]

LID BOARD · LINK SIDE (turned over like a page: column 1 on the RIGHT)

## STEP 13 Lid harness & speaker leads

### Cutting bench Soldering station

Four F-F jumpers are shortened (cut the stated length out of the middle, strip 4 mm, twist, solder, heat-shrink) and two are cut for the speaker (keep one female plug, solder the cut end to the speaker tab, heat-shrink).

## DO THESE IN ORDER

# | TYPE | FROM | TO

## ROUTE (SOLDER SIDE)

| | | | | WIRE / CUT

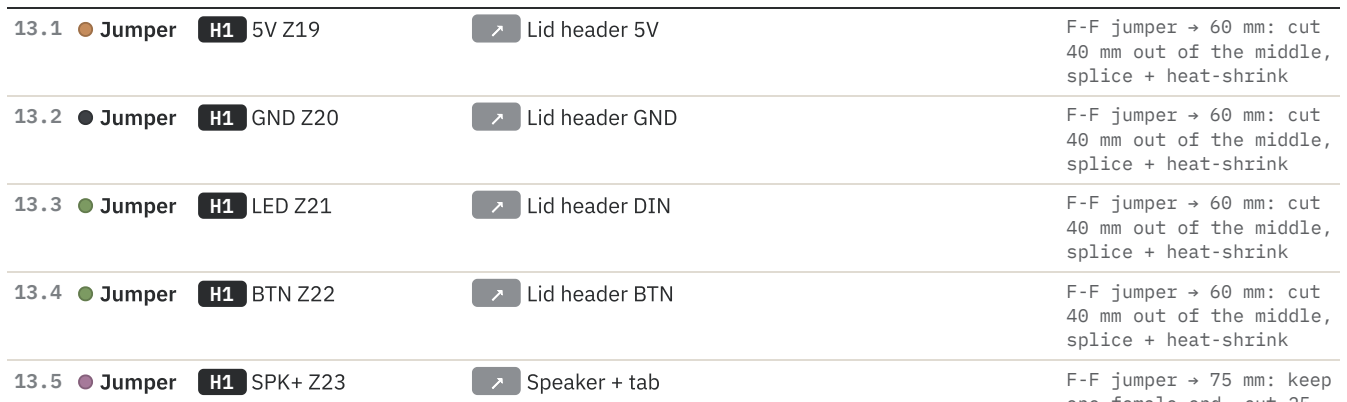
[picture p127: figure]
40 mm out of the middle, splice + heat-shrink

13.1 | Jumper | H1 5V Z19 | ↗ | Lid header 5V | F-F jumper → 60 mm: cut
13.2 | Jumper | H1 GND Z20 | ↗ | Lid header GND | F-F jumper → 60 mm: cut
13.3 | Jumper | H1 LED Z21 | ↗ | Lid header DIN | F-F jumper → 60 mm: cut
13.4 | Jumper | H1 BTN Z22 | ↗ | Lid header BTN | F-F jumper → 60 mm: cut
13.5 | Jumper | H1 SPK+ Z23 | ↗ | Speaker + tab | F-F jumper → 75 mm: keep one female end, cut 25 mm off, solder to the speaker tab
13.6 | Jumper | H1 SPK− Z24 | ↗ | Speaker − tab | F-F jumper → 90 mm: keep one female end, cut 10 mm off, solder to the speaker tab

1

2

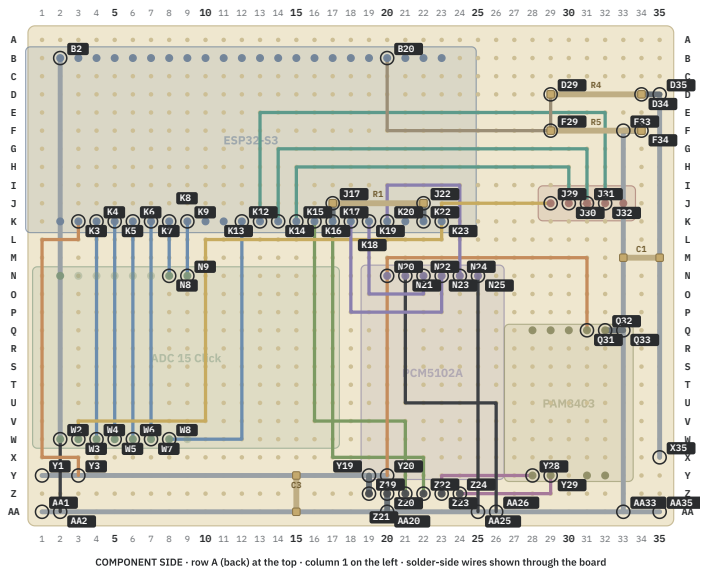
[picture p128: page 22]
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

## STEP 14 Check sheet

## MUST NOT BEEP (SHORTS)

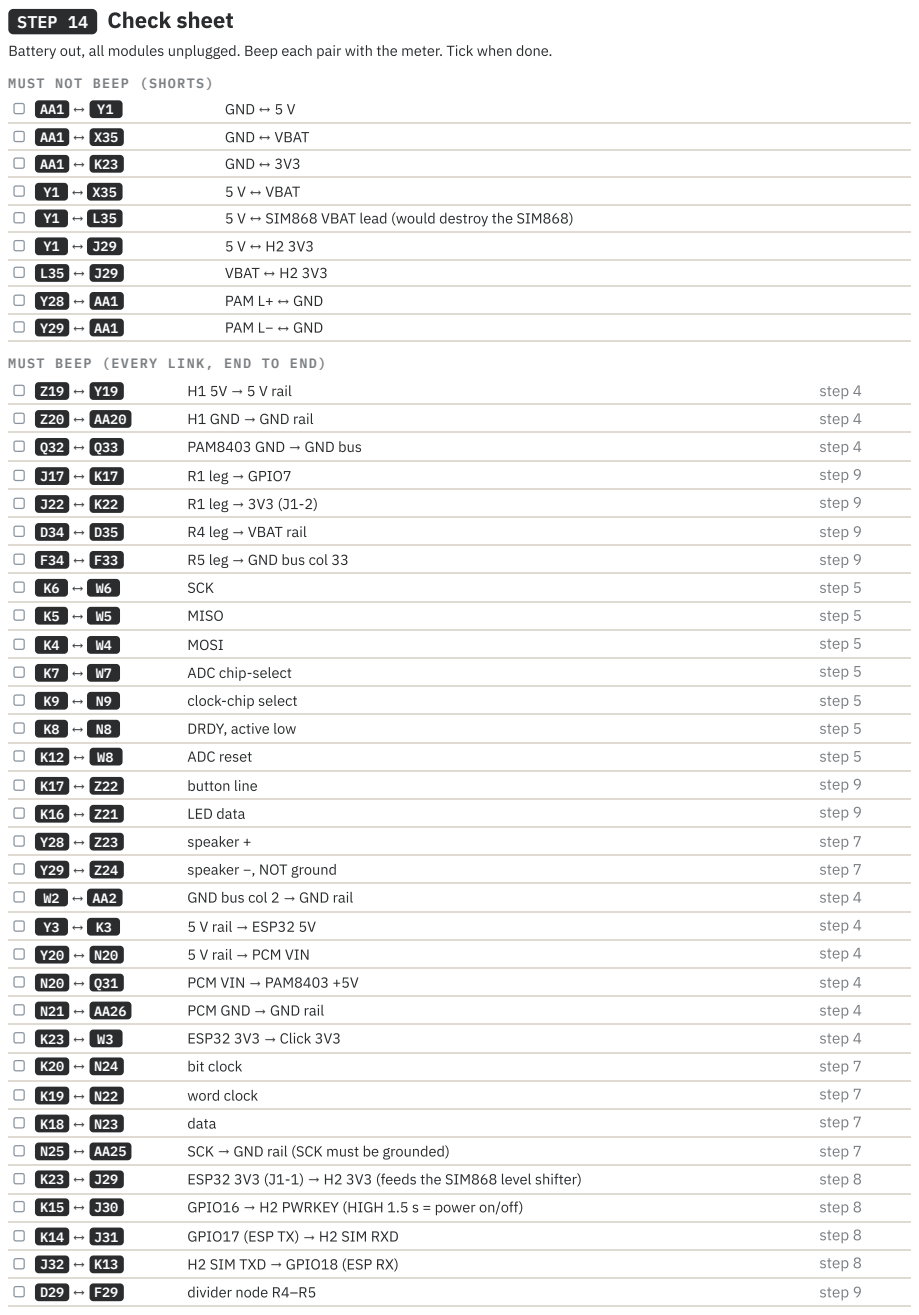
[picture p129: page 23]

Battery out, all modules unplugged. Beep each pair with the meter. Tick when done.

MUST BEEP (EVERY LINK, END TO END)

## THEN, MODULES PLUGGED IN, BATTERY IN, ROCKER ON

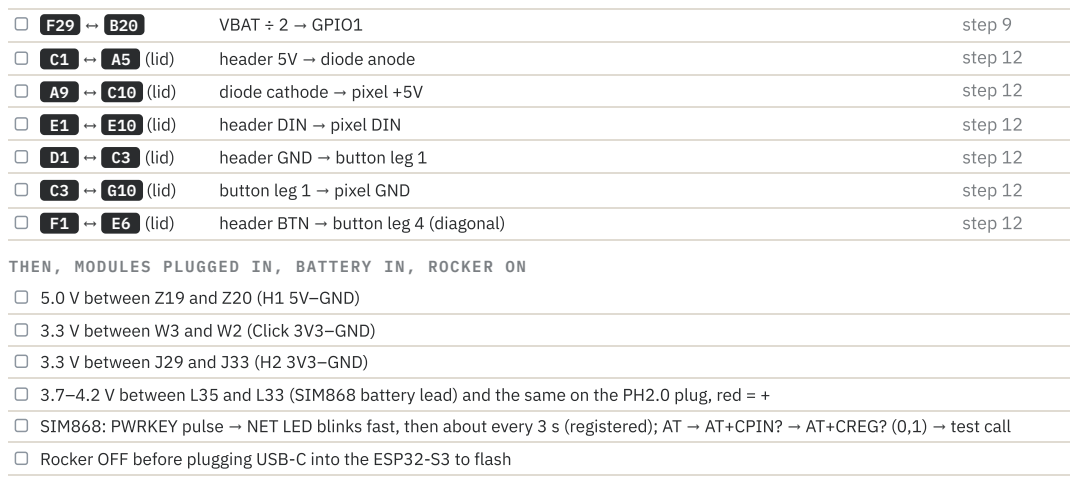
[picture p130: page 24]

3.3 V between W3 and W2 (Click 3V3–GND)

3.7–4.2 V between L35 and L33 (SIM868 battery lead) and the same on the PH2.0 plug, red = +

SIM868: PWRKEY pulse → NET LED blinks fast, then about every 3 s (registered); AT → AT+CPIN? → AT+CREG? (0,1) → test call

Rocker OFF before plugging USB-C into the ESP32-S3 to flash

## CUT Cut list (every wire cut to length)

STEP TYPE | FROM | TO | LENGTH INSTRUCTION
4 | Bare wire | AA1 GND rail | AA35 GND rail | 100

mm

## bare 20 AWG · cut 100 mm

4 | Bare wire | Y1 5 V rail | Y20 5 V rail | 60 mm | bare 20 AWG · cut 60 mm
4 | Bare wire | B2 ESP32-S3 J3-22 GND | W2 Click GND | 65 mm | bare 20 AWG · cut 65 mm
4 | Bare wire | F33 GND bus col 33 | AA33 GND rail | 65 mm | bare 20 AWG · cut 65 mm
4 | Bare wire | D35 VBAT rail | X35 VBAT rail | 65 mm | bare 20 AWG · cut 65 mm
4 | Link | W2 Click GND | AA2 GND rail | 20 mm | insulated core · cut 20

## mm, strip 3 mm both ends

4 | Link | Y3 5 V rail | K3 ESP32-S3 J1-21 5V | 55 mm | insulated core · cut 55

## mm, strip 3 mm both ends

4 | Link | Y20 5 V rail | N20 PCM5102A VIN | 40 mm | insulated core · cut 40

## mm, strip 3 mm both ends

4 | Link | N20 PCM5102A VIN | Q31 PAM8403 +5V | 50 mm | insulated core · cut 50

## mm, strip 3 mm both ends

4 | Link | N21 PCM5102A GND | AA26 GND rail | 55 mm | insulated core · cut 55

## mm, strip 3 mm both ends

4 | Link | K23 ESP32-S3 J1-1 3V3 | W3 Click 3V3 | 90 mm | insulated core · cut 90

## mm, strip 3 mm both ends

5 | Link | K6 ESP32-S3 J1-18

GPIO12

W6 Click SCK | 40 mm | insulated core · cut 40

## mm, strip 3 mm both ends

5 | Link | K5 ESP32-S3 J1-19

GPIO13

W5 Click SDO (MISO) | 40 mm | insulated core · cut 40

## mm, strip 3 mm both ends

5 | Link | K4 ESP32-S3 J1-20

GPIO14

W4 Click SDI (MOSI) | 40 mm | insulated core · cut 40

## mm, strip 3 mm both ends

5 | Link | K7 ESP32-S3 J1-17

GPIO11

W7 Click CS1 | 40 mm | insulated core · cut 40

## mm, strip 3 mm both ends

5 | Link | K9 ESP32-S3 J1-15 GPIO9 | N9 Click CS2 | 20 mm | insulated core · cut 20

## mm, strip 3 mm both ends

5 | Link | K8 ESP32-S3 J1-16

GPIO10

N8 Click INT (DRDY) | 20 mm | insulated core · cut 20

## mm, strip 3 mm both ends

5 | Link | K12 ESP32-S3 J1-12

GPIO8

W8 Click RST | 50 mm | insulated core · cut 50

## mm, strip 3 mm both ends

6 | Pair | ↗ | SM-24 + tab | ↗ | Click CH1+ screw terminal | 115

mm

## 6×0.22 cable core · cut 115 mm, twist the two cores ~1 turn/cm

6 | Pair | ↗ | SM-24 − tab | ↗ | Click CH1− screw terminal | 105

mm

## 6×0.22 cable core · cut 105 mm, twist the two cores ~1 turn/cm

6 | Top wire | AA18 GND rail | ↗ | Click CH1− screw terminal | 55 mm | insulated core · cut 55

## mm, strip 5 mm (screw end) / 3 mm

6 | Top wire | AA19 GND rail | ↗ | Click CH2− screw terminal | 40 mm | insulated core · cut 40

## mm, strip 5 mm (screw end) / 3 mm

6 | Top wire | ↗ | Click CH2+ screw

terminal

↗ | Click CH2− screw terminal | 20 mm | insulated core · cut 20

## mm, strip 5 mm (screw end) / 3 mm

7 | Link | Y28 PAM8403 L+ out | Z23 H1 SPK+ | 25 mm | insulated core · cut 25

## mm, strip 3 mm both ends

7 | Link | Y29 PAM8403 L− out | Z24 H1 SPK− | 25 mm | insulated core · cut 25

## mm, strip 3 mm both ends

7 | Link | K20 ESP32-S3 J1-4 GPIO4 | N24 PCM5102A BCK | 40 mm | insulated core · cut 40

## mm, strip 3 mm both ends

7 | Link | K19 ESP32-S3 J1-5 GPIO5 | N22 PCM5102A LCK | 30 mm | insulated core · cut 30

## mm, strip 3 mm both ends

STEP TYPE | FROM | TO | LENGTH INSTRUCTION
| | | mm, strip 3 mm both ends

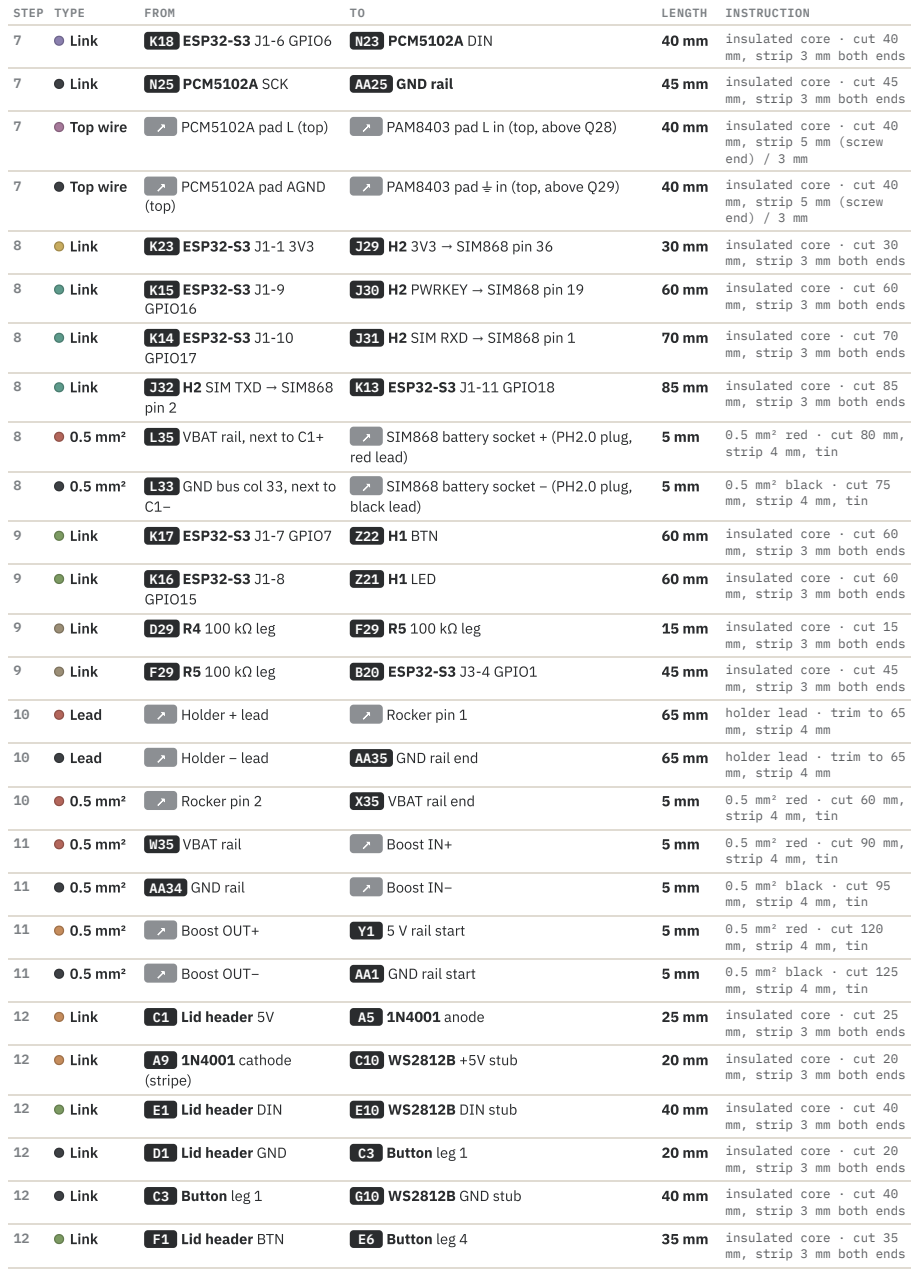
[picture p131: page 26]

mm, strip 3 mm both ends

mm, strip 5 mm (screw
end) / 3 mm

mm, strip 4 mm, tin

STEP TYPE | FROM | TO | LENGTH INSTRUCTION
13 | Jumper | H1 5V Z19 | ↗ | Lid header 5V | 60 mm | F-F jumper → 60 mm: cut

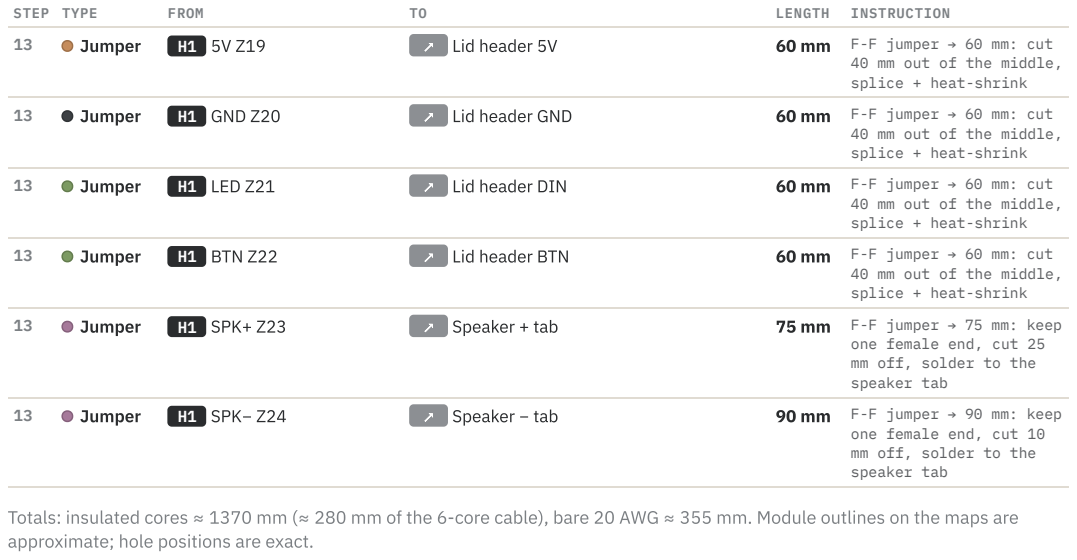
[picture p132: page 27]
Jumper; H1 GND Z20; Lid header GND; F-F jumper → 60 mm: cut; H1 LED Z21; Lid header DIN; H1 BTN Z22; Lid header BTN; H1 SPK+ Z23; Speaker + tab; F-F jumper → 75 mm: keep; H1 SPK− Z24; Speaker − tab; F-F jumper → 90 mm: keep

40 mm out of the middle,
splice + heat-shrink

one female end, cut 25
mm off, solder to the
speaker tab

one female end, cut 10

Totals: insulated cores ≈ 1370 mm (≈ 280 mm of the 6-core cable), bare 20 AWG ≈ 355 mm. Module outlines on the maps are

approximate; hole positions are exact.
