Kaszti49/RezonFallDetector/out/phase0/font_test.png

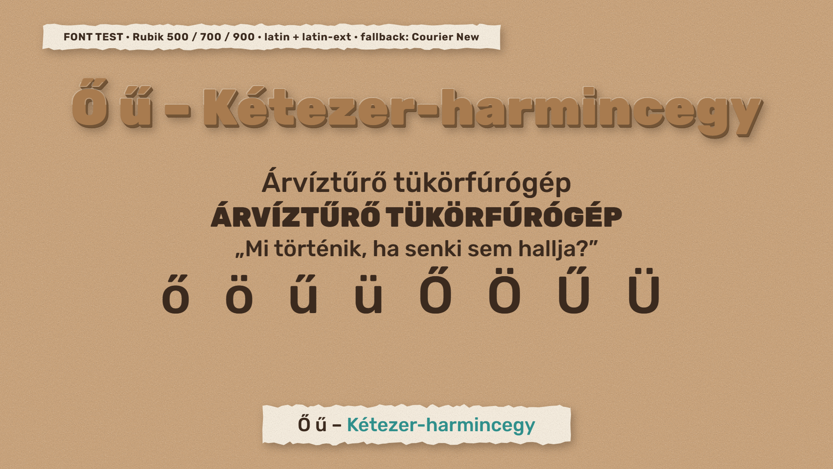
out/phase0/font_test.png
