Kaszti49/RezonFallDetector/(commit log)

2026-10-21 Phase 1: style test – material system, Mari puppet, sets, device, ripple, titles
    - Cut-paper material system: seeded hand-cut outlines, grain/fiber/mottle textures,
    card thickness, lit cut edge, per-piece shadows, key light, depth of field
    - Mari jointed puppet (side view, FK floor contact, split pins)
    - Bathroom set, house cross-section with corrugated cut faces, perspective tile floor
    - Rezon device (hero 3/4 and side view), floor ripple + seismograph from one impact list
    - Captions on torn paper; collage letter titles after Kaszti's reference (3 variants)
    - SCRIPT.md: team names, roles and lines (Kaszti)
2026-10-21 Phase 2: animatic – all scenes S01–S19 with timing and captions
    - timeline.ts: single timing source from SCRIPT.md, syllable-based VO estimates,
    build fails over 1:58 or if a VO line overruns its scene
    - captions.json + scripts/check-script.mjs: captions verified against SCRIPT.md
    character for character (npm run check)
    - Generic puppet rig; Mari (walk cycle, throw, slip, lie, sit up, smile), Anna, team puppets
    - Bathroom story as one function of time; S06 rewind replays it backwards
    - Seamless S06→S07 hand-off: bathroom fits the house's right room, house assembles around it
    - Exploded device view, floor waves + tape from one event list, fall spike + flat line
    - Split-screen alert,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
2026-10-21 Captions clear at their scene's cut; formatting
2026-10-21 Year 2028; sound effects + ambience; pop-up book scenery; device lid scaling
    - 2031 → 2028 (Kaszti): SCRIPT.md S07 + VO-06 recording text, captions, stamp
    - SFX pulled into Phase 3 (Kaszti): scripts/build-sfx.mjs builds 37 sounds + audition
    candidates from Kenney CC0 packs and ffmpeg synthesis; audio/sfx/CREDITS.md
    - SfxTrack places every sound from the picture's own constants (walk plans, falls,
    BEATS table, VO word times); hook and fall share one thud file, S10 heavier
    - Pop-up book: hills, sun, clouds fold up as it opens
    - Rezon lid details scale with device size; lid rim + shadow (finale device was unreadable)
2026-10-21 Phase 3: foot-locked walk, S07 build always lands before the cut, mood grading
    - Walk: planted foot never slides; hip derived from stance leg reach (incl. near/far hip
    offset); footstep impacts at the true heel position; 0.25 s settle after walking
    - S07: house assembly window shared with SFX, finishes ≥ 0.45 s before S08 (was a jump)
    - Grade overlay: amber alarm wash in S11, teal relief lift in S13
    - noAudio input prop for sparse check renders (Remotion audio mixing bug)
2026-11-09 Full project snapshot: REZON film, audio pass, team assets, presentation S01-S03
    - Remotion film project with final render and all phase renders in out/
    - Voiceover, SFX sources and processed audio; team face cut-outs
    - presentation/: Cavalry scenes, slide renders (S01 title, S02 problems,
    S03 crack/tear), circle-cropped assets and SLIDES.md motion specs
    - Videos (*.mp4, *.mov) stored with Git LFS
2026-11-10 Add hardware docs: parts list, wiring guide, sensor practice sketches
    Shopping/parts list, Rezon wiring guide and list (HTML/PDF), the wiring
    document generator sources, and practice sketches for the VL53L5CX hand
    test, I2C diagnostics and robot obstacle avoidance.
2026-11-12 SIM868 modem: practice call test, diagnostics, updated wiring and parts docs
    - practice/sim868_call_test: ESP32 DevKit V1 sketch that powers the SIM868 on,
    waits for the network and dials / hangs up from the Serial Monitor
    - practice/sim868_diag: tries both RX/TX orders and 5 baud rates, reads idle
    line levels, pulses PWRKEY only when the modem is off
    - First outgoing and incoming calls work (logged in NOTES.md)
    - Wiring guide, wiring list and parts list regenerated for the Waveshare
    Pico-SIM868 board (parts_source/, wiring_source/)
    - Geophone practice sketch, viewer, wiring PDF and recordings
2026-11-12 Add how-it-works explainer PDF and firmware master prompt
    - Rezon_How_It_Works.pdf: 14-page explanation of the signal chain, power, maths and detection logic (source in explainer_source/)
    - firmware/MASTER_PROMPT.md: prompt for the firmware session, based on published geophone fall-detection research
    - NOTES: decisions for the detection logic
2026-11-12 Remove TP4056 USB-C charger from wiring guide and wiring list
    The battery is charged externally, so the device has no charger board.
    Holder leads now go straight to rocker pin 1 (+) and the AA35 GND rail
    end (-). Removed the charger model, its case rails, the USB-C wall port
    and their callouts; added a protected-cell / external-charging warning.
2026-11-13 Add jumper-only wiring guide and casing Blender mockup
    Rezon_Wiring_Guide_Jumpers.html: 3D wiring guide in the same style as
    the perfboard guide, using plain F-F / M-F jumpers (no perfboard, no
    breadboard). Drops R1, R4, R5, C1: firmware uses INPUT_PULLUP on GPIO7
    and reads battery voltage via AT+CBC instead of the GPIO1 divider.
    Rezon_Full_Mockup.blend: Blender model of the casing.
2026-11-13 Power bank + 4.0 V step-down, ZK-502M amp as last step
    - Power: an external power bank (USB-A out) is the only source. A cut USB
    cable enters through a grommet in the left wall; red -> rocker (main
    switch) -> 5 V, black -> GND. The DC-DC boost and the 18650 + holder
    are removed.
    - SIM868: an STP28UD-3A step-down (stock row 291), set to 4.0 V, feeds
    its battery socket from the 5 V rail, never 5 V directly.
    - Jumper guide: the PAM8403 is replaced by the ZK-502M (DAC line-out ->
    AUX cable, 5 V into its DC jack, speaker on L+/L-). Audio moves to the
    last wiring step (step 10). The DAC SCK is grounded via its solder
    bridge.
    - Perfboard guide, wiring list and parts list regenerated f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
2026-11-14 Firmware: detection core, ESP32-S3 sketch, tools, train and live pages
    First upload to the wired device (2026-11-14): ADC answers at 998 samples/s
    with 0 CRC errors, settings and the alarm rehearsal work over USB.
    The SIM868 gives no answer yet (TXD floats: off or unpowered).
    - firmware/rezon: portable detection core, alarm sequence, serial protocol
    and the ESP32-S3 sketch. Fix: !test skipped the ASK state because the
    command handler took its own millis(), 1 ms ahead of loop().
    - firmware/tools: replay and fit (C++), build and train scripts.
    - firmware/ui: train.html and live.html (Web Serial, single files).
    - firmware/data: provisional labels and one demo fall log.
    - Casing: updated Bl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
2026-11-14 Firmware: normalised fall rule from the stage test
    Stage recording 2026-11-14 (walking near/mid/far, falls near/mid/far,
    3 jumps): with the absolute rule (impactMin 30) the far fall was missed
    and two jumps alarmed.
    Rule 1 (new default) ignores distance:
    - impact-sized when the peak is >= relMin (4) x the step level, the
    second-loudest step-like event from 8 s to 1 s before the onset
    (impactMin is only an absolute floor now)
    - fall-shaped when the impact envelope stays >= 30 % of its own peak
    for >= holdMin (0.25 s) within -300..+600 ms of the peak
    Replay: 3/3 falls, 3/3 jumps rejected, steps at most 3.3x the level.
    Rule 0 (old) stays available.
    - core: step level, hold measure, rul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
2026-11-14 Firmware: phone call after a fall, modem and freeze diagnostics
    First real call from Rezon (2026-11-14): !test ran the alarm sequence and
    dialled the number in secrets.h; the phone rang. The modem had never
    switched on because the SIM868 board switch was on USB instead of VBAT.
    - modem task: switches the modem on at boot and retries once a minute if
    it gets power later; enters REZON_SIM_PIN from secrets.h once per boot
    (3 wrong tries would lock the SIM); logs SIM and registration state
    - !pwr: PWRKEY pulse on request (it toggles); !pwrhold [s]: hold GPIO16
    high to measure it, the pin reads itself back
    - boot line "restart reason: ..." (power-on, brownout, watchdog, crash);
    the sampl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
2026-11-14 Casing: wall mockup STL, Blender build scripts, device voice clips
    - Add Rezon_Walls_Mockup.stl and update Rezon_Full_Mockup.blend
    - Add blender_source/ (build_parts, build_walls, send_to_blender)
    - Add device voice clips Minden_Rendben.mp3 and Segitseget_Hivok.mp3
    - Remove superseded presentation renders (S01 v1/v2, S02 v1/v2, S02 styleframe)
2026-11-14 Firmware: Bluetooth link, voice clips, start-up chime, speaker tests
    - Bluetooth LE (Nordic UART service, name REZON): every text line goes
    to USB and BLE, commands work over both; raw samples travel as
    B,<base64> lines (20 x 3-byte samples, ~4 kB/s). Train page:
    Bluetooth button, recordings store the samples as D lines so replay
    still works. Live page: key B. Tested: connect, !get round-trip,
    no dropped bytes. Stage setup: power bank + rocker on, laptop over BLE.
    - Voice: clips.h from Minden_Rendben.mp3 (question) and
    Segitseget_Hivok.mp3 (calling), 16 kHz mono; alarm timings follow the
    clip lengths. tools/mkclips.js regenerates it.
    - Start-up chime: two neutral notes ~1.5 s a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
